jmendoza-10/connectivity-module-public/firmware/config/README.md

Pin/clock configuration will be generated with NXP S32 Config Tools from the rev 0.4 schematic pin budget
(docs/design/power-mcu.md sec. 4) into `config/generated/`. Empty until rev 0.4 exists.
