jmendoza-10/connectivity-module-public/docs/hw-sw-interface.md

<!-- GENERATED by tools/gen_interface.py from hardware/kicad/wwan-carrier.net - DO NOT EDIT BY HAND. -->
# Hardware / software interface - WWAN carrier rev 0.2

Generated from the KiCad netlist plus the semantic table in `tools/gen_interface.py`. Rerun `python3 tools/gen_interface.py` (or `tools/regen_hardware.sh`) after any schematic change; CI runs `--check`.

Legend: **VERIFY** = not yet confirmed on hardware or against a primary source. Nothing in this document has been bench-tested (no boards exist yet).

## 1. I2C devices

One host I2C bus enters on the host header J801 (3.3 V). The PCIe switch sits behind a PCA9306 level translator (1.8 V side).

| Ref | Device | 7-bit address | Bus | Source / note | Status |
|---|---|---|---|---|---|
| U301 | PI7C9X3G606GP | 0x6F | host I2C via U304 PCA9306 (1.8 V side) | Diodes DS43484 Rev 5-2 sec. I2C: default 1101111b (0x6F), programmable at cfg offset 318h. The same section's example tables show 68h - confirm with i2cdetect | **VERIFY** |
| U705 | USB5744 | 0x2D | host I2C (3.3 V) | Linux DT binding microchip,usb5744.yaml example (usb-hub@2d); not stated in DS00001855J text | **VERIFY** |
| U801 | TCA6416A | 0x20 | host I2C (3.3 V) | ADDR pin on GND - TI SCPS194F Table 8-3: ADDR=L -> 0x20, ADDR=H -> 0x21 (derived from the ADDR pin net) | from netlist + datasheet |
| U802 | TCA6416A | 0x21 | host I2C (3.3 V) | ADDR pin on +3V3 - TI SCPS194F Table 8-3: ADDR=L -> 0x20, ADDR=H -> 0x21 (derived from the ADDR pin net) | from netlist + datasheet |
| U704 | HD3SS3220 | - | - | ADDR pin unconnected -> GPIO mode, I2C not used (TI SLLSEN5) | from netlist + datasheet |

Bus pull-ups found in the netlist: R709 10k to +3V3; R802 4.7k to +3V3 (DNP); R710 10k to +3V3; R803 4.7k to +3V3 (DNP).

Notes:
- USB5744 is strapped for **SMBus slave mode** (10 k pull-ups on SMCLK/SMDAT). In that mode the hub waits **indefinitely** in its SOC_CFG stage until the host finishes configuration (DS00001855J sec. 5.1.5). Linux `onboard_usb_dev` (`CONFIG_USB_ONBOARD_DEV_USB5744`) sends the attach command (SMBus write-word, command 0xAA, data 0x0056); `carrierctl.py hub-attach` does the same from userspace. Until this happens **no slot enumerates over USB**. **VERIFY** on hardware.
- PI7C9X3G606GP I2C is for configuration/debug only; normal operation needs no I2C traffic (transparent switch).

## 2. TCA6416A GPIO expanders

### U801 - address 0x20 (ADDR -> GND)

INT# -> `EXP_INT_N`, RESET# -> `EXP_RESET_N`. Register init (write output regs 0x02/0x03 **first**, then config 0x06/0x07): output = `0x00 0x80`, config = `0x00 0x00` (1 = input).

| Port.bit | Pin | Net | Dir | Active | Board default (expander pins are inputs after POR) | Init value | Meaning | Connects to | gpio-line-name |
|---|---|---|---|---|---|---|---|---|---|
| P0.0 | 4 | `SLOT1_PWR_EN` | out | high | 0 (pull-down R201 100k to GND) | 0 | Enable for slot 1 3.7 V buck (LM61460 EN). 1 = slot rail on. | R201.1 (100k), U201.EN/SYNC (LM61460AASQRJRRQ1) | `slot1-pwr-en` |
| P0.1 | 5 | `SLOT1_FCPO_N` | out | low | 0 (pull-down R401 47k to GND) | 0 | M.2 FULL_CARD_POWER_OFF# (module pin 6), driven directly. 0 = module held off, 1 = module allowed to run. Drive 0 before removing +3V7 (avoid back-powering the module from the expander). | J401.FULL_CARD_POWER_OFF# (M.2 Key-B WWAN), R401.1 (47k) | `slot1-fcpo-n` |
| P0.2 | 6 | `SLOT1_RESET` | out | high | 0 (pull-down R402 100k to GND) | 0 | Gate of 2N7002 that pulls module RESET# (pin 67) low (open drain only - EM92 RESET_N / FN990 SYS_RESIN_N forbid pull-ups). 1 = module held in reset. Pulse >= 1 s (FN990 needs > 1 s, EM92 >= 450 ms); emergency use only. | Q401.G (2N7002), R402.1 (100k) | `slot1-reset` |
| P0.3 | 7 | `SLOT1_WDIS` | out | high | 0 (pull-down R403 100k to GND) | 0 | Gate of 2N7002 that pulls W_DISABLE1# (pin 8) low. 1 = radio disabled (RF off). | Q402.G (2N7002), R403.1 (100k) | `slot1-wdis` |
| P0.4 | 8 | `SLOT1_PCIE_EN` | out | high | 0 (pull-down R407 10k to GND) | 0 | Gates host PERST# into slot 1 (SN74LVC1G08 AND). 0 = slot PERST# held asserted (default during power-up; release >= 150 ms after the slot rail is valid, EM92 T_pvpgl). Does NOT select the host interface - see SLOT1_PCIE_SEL. Jumper JUMPER (fitted) forces 0 regardless of the expander. | R406.1 (1k), R407.1 (10k) | `slot1-pcie-en` |
| P0.5 | 9 | `SLOT2_PWR_EN` | out | high | 0 (pull-down R207 100k to GND) | 0 | Enable for slot 2 3.7 V buck (LM61460 EN). 1 = slot rail on. | R207.1 (100k), U202.EN/SYNC (LM61460AASQRJRRQ1) | `slot2-pwr-en` |
| P0.6 | 10 | `SLOT2_FCPO_N` | out | low | 0 (pull-down R501 47k to GND) | 0 | M.2 FULL_CARD_POWER_OFF# (module pin 6), driven directly. 0 = module held off, 1 = module allowed to run. Drive 0 before removing +3V7 (avoid back-powering the module from the expander). | J501.FULL_CARD_POWER_OFF# (M.2 Key-B WWAN), R501.1 (47k) | `slot2-fcpo-n` |
| P0.7 | 11 | `SLOT2_RESET` | out | high | 0 (pull-down R502 100k to GND) | 0 | Gate of 2N7002 that pulls module RESET# (pin 67) low (open drain only - EM92 RESET_N / FN990 SYS_RESIN_N forbid pull-ups). 1 = module held in reset. Pulse >= 1 s (FN990 needs > 1 s, EM92 >= 450 ms); emergency use only. | Q501.G (2N7002), R502.1 (100k) | `slot2-reset` |
| P1.0 | 13 | `SLOT2_WDIS` | out | high | 0 (pull-down R503 100k to GND) | 0 | Gate of 2N7002 that pulls W_DISABLE1# (pin 8) low. 1 = radio disabled (RF off). | Q502.G (2N7002), R503.1 (100k) | `slot2-wdis` |
| P1.1 | 14 | `SLOT2_PCIE_EN` | out | high | 0 (pull-down R507 10k to GND) | 0 | Gates host PERST# into slot 2 (SN74LVC1G08 AND). 0 = slot PERST# held asserted (default during power-up; release >= 150 ms after the slot rail is valid, EM92 T_pvpgl). Does NOT select the host interface - see SLOT2_PCIE_SEL. Jumper JUMPER (fitted) forces 0 regardless of the expander. | R506.1 (1k), R507.1 (10k) | `slot2-pcie-en` |
| P1.2 | 15 | `SLOT3_PWR_EN` | out | high | 0 (pull-down R213 100k to GND) | 0 | Enable for slot 3 3.7 V buck (LM61460 EN). 1 = slot rail on. | R213.1 (100k), U203.EN/SYNC (LM61460AASQRJRRQ1) | `slot3-pwr-en` |
| P1.3 | 16 | `SLOT3_FCPO_N` | out | low | 0 (pull-down R601 47k to GND) | 0 | M.2 FULL_CARD_POWER_OFF# (module pin 6), driven directly. 0 = module held off, 1 = module allowed to run. Drive 0 before removing +3V7 (avoid back-powering the module from the expander). | J601.FULL_CARD_POWER_OFF# (M.2 Key-B WWAN), R601.1 (47k) | `slot3-fcpo-n` |
| P1.4 | 17 | `SLOT3_RESET` | out | high | 0 (pull-down R602 100k to GND) | 0 | Gate of 2N7002 that pulls module RESET# (pin 67) low (open drain only - EM92 RESET_N / FN990 SYS_RESIN_N forbid pull-ups). 1 = module held in reset. Pulse >= 1 s (FN990 needs > 1 s, EM92 >= 450 ms); emergency use only. | Q601.G (2N7002), R602.1 (100k) | `slot3-reset` |
| P1.5 | 18 | `SLOT3_WDIS` | out | high | 0 (pull-down R603 100k to GND) | 0 | Gate of 2N7002 that pulls W_DISABLE1# (pin 8) low. 1 = radio disabled (RF off). | Q602.G (2N7002), R603.1 (100k) | `slot3-wdis` |
| P1.6 | 19 | `SLOT3_PCIE_EN` | out | high | 0 (pull-down R607 10k to GND) | 0 | Gates host PERST# into slot 3 (SN74LVC1G08 AND). 0 = slot PERST# held asserted (default during power-up; release >= 150 ms after the slot rail is valid, EM92 T_pvpgl). Does NOT select the host interface - see SLOT3_PCIE_SEL. Jumper JUMPER (fitted) forces 0 regardless of the expander. | R606.1 (1k), R607.1 (10k) | `slot3-pcie-en` |
| P1.7 | 20 | `HUB_RESET_N` | out | low | 1 (pull-up R706 10k to +3V3) | 1 | USB5744 RESET_N. 0 = hub held in reset (standby). Hub straps re-latch on the rising edge. | C716.1 (100nF), R706.2 (10k), TP702.1 (HUB_RESET_N), U705.RESET_N (USB5744/2G9 (verify ordering suffix)) | `hub-reset-n` |

### U802 - address 0x21 (ADDR -> +3V3)

INT# -> `EXP_INT_N`, RESET# -> `EXP_RESET_N`. Register init (write output regs 0x02/0x03 **first**, then config 0x06/0x07): output = `0xFF 0xF3`, config = `0xFF 0x83` (1 = input).

| Port.bit | Pin | Net | Dir | Active | Board default (expander pins are inputs after POR) | Init value | Meaning | Connects to | gpio-line-name |
|---|---|---|---|---|---|---|---|---|---|
| P0.0 | 4 | `SLOT1_PG` | in | high | 1 (pull-up R206 100k to +3V3) | - | Slot 1 3.7 V buck PGOOD (open drain). 1 = rail in regulation. | Q805.G (2N7002), R206.2 (100k), U201.PGOOD (LM61460AASQRJRRQ1) | `slot1-pg` |
| P0.1 | 5 | `SLOT2_PG` | in | high | 1 (pull-up R212 100k to +3V3) | - | Slot 2 3.7 V buck PGOOD (open drain). 1 = rail in regulation. | Q806.G (2N7002), R212.2 (100k), U202.PGOOD (LM61460AASQRJRRQ1) | `slot2-pg` |
| P0.2 | 6 | `SLOT3_PG` | in | high | 1 (pull-up R218 100k to +3V3) | - | Slot 3 3.7 V buck PGOOD (open drain). 1 = rail in regulation. | Q807.G (2N7002), R218.2 (100k), U203.PGOOD (LM61460AASQRJRRQ1) | `slot3-pg` |
| P0.3 | 7 | `SLOT1_WAKE_N` | in | low | 1 (pull-up R405 10k to +3V3) | - | M.2 PEWAKE# (module pin 54). 0 = module requests wake. Not routed to the PCIe switch. | J401.PEWAKE# (M.2 Key-B WWAN), R405.2 (10k) | `slot1-wake-n` |
| P0.4 | 8 | `SLOT2_WAKE_N` | in | low | 1 (pull-up R505 10k to +3V3) | - | M.2 PEWAKE# (module pin 54). 0 = module requests wake. Not routed to the PCIe switch. | J501.PEWAKE# (M.2 Key-B WWAN), R505.2 (10k) | `slot2-wake-n` |
| P0.5 | 9 | `SLOT3_WAKE_N` | in | low | 1 (pull-up R605 10k to +3V3) | - | M.2 PEWAKE# (module pin 54). 0 = module requests wake. Not routed to the PCIe switch. | J601.PEWAKE# (M.2 Key-B WWAN), R605.2 (10k) | `slot3-wake-n` |
| P0.6 | 10 | `PG_3V3` | in | high | 1 (pull-up R112 10k to +3V3) | - | +3V3 system buck PGOOD. Also enables the +0V95/+1V8/+1V2 regulators (hardware sequencing). | Q801.G (2N7002), R112.2 (10k), TP106.1 (PG_3V3), U102.PGOOD (LM61460AASQRJRRQ1), U103.EN (TPS568230RJER), U104.EN (TPS62130RGTR), U105.EN (TPS62130RGTR) | `pg-3v3` |
| P0.7 | 11 | `PG_0V95` | in | high | 1 (pull-up R117 100k to +3V3) | - | +0V95 (PCIe switch core) PGOOD. | Q802.G (2N7002), R117.2 (100k), U103.PGOOD (TPS568230RJER) | `pg-0v95` |
| P1.0 | 13 | `PG_1V8` | in | high | 1 (pull-up R120 100k to +3V3) | - | +1V8 (PCIe switch I/O, EEPROM) PGOOD. | Q803.G (2N7002), R120.2 (100k), U104.PG (TPS62130RGTR) | `pg-1v8` |
| P1.1 | 14 | `PG_1V2` | in | high | 1 (pull-up R123 100k to +3V3) | - | +1V2 (USB5744 core) PGOOD. | Q804.G (2N7002), R123.2 (100k), U105.PG (TPS62130RGTR) | `pg-1v2` |
| P1.2 | 15 | `USER_LED1` | out | high | ? (no pull (floating while expander pin is an input)) | 0 | User LED 1 (yellow, 1 k to LED to GND). 1 = on. | R813.1 (1k) | `user-led1` |
| P1.3 | 16 | `USER_LED2` | out | high | ? (no pull (floating while expander pin is an input)) | 0 | User LED 2 (yellow, 1 k to LED to GND). 1 = on. | R814.1 (1k) | `user-led2` |
| P1.4 | 17 | `SLOT1_PCIE_SEL` | out | high | 1 (pull-up R410 10k to +3V3) | 1 | Gate of 2N7002 on M.2 pin 20 (rev 0.3). 1 = pin 20 LOW = PCIe host interface (Telit FN990 USB_PCIE_SWITCH low; Sierra EM92 PCIE_DIS low). 0 = pin 20 released: FN990 boots USB-only (internal 10k PU); EM92 boots USB only if the DNP 10k pin-20 pull-up to +1V8 is fitted. Sampled at module boot: set before FCPO# goes high. 10k PU = PCIe by default. | Q403.G (2N7002), R410.2 (10k) | `slot1-pcie-sel` |
| P1.5 | 18 | `SLOT2_PCIE_SEL` | out | high | 1 (pull-up R510 10k to +3V3) | 1 | Gate of 2N7002 on M.2 pin 20 (rev 0.3). 1 = pin 20 LOW = PCIe host interface (Telit FN990 USB_PCIE_SWITCH low; Sierra EM92 PCIE_DIS low). 0 = pin 20 released: FN990 boots USB-only (internal 10k PU); EM92 boots USB only if the DNP 10k pin-20 pull-up to +1V8 is fitted. Sampled at module boot: set before FCPO# goes high. 10k PU = PCIe by default. | Q503.G (2N7002), R510.2 (10k) | `slot2-pcie-sel` |
| P1.6 | 19 | `SLOT3_PCIE_SEL` | out | high | 1 (pull-up R610 10k to +3V3) | 1 | Gate of 2N7002 on M.2 pin 20 (rev 0.3). 1 = pin 20 LOW = PCIe host interface (Telit FN990 USB_PCIE_SWITCH low; Sierra EM92 PCIE_DIS low). 0 = pin 20 released: FN990 boots USB-only (internal 10k PU); EM92 boots USB only if the DNP 10k pin-20 pull-up to +1V8 is fitted. Sampled at module boot: set before FCPO# goes high. 10k PU = PCIe by default. | Q603.G (2N7002), R610.2 (10k) | `slot3-pcie-sel` |
| P1.7 | 20 | `EXP_SPARE7` | spare | - | ? (no pull (floating while expander pin is an input)) | - | Spare expander pin, brought to a test point only. | TP804.1 (EXP_SPARE7) | `spare7` |

TCA6416A facts used above (TI SCPS194F): after power-on reset or RESET# all pins are inputs (config regs 0x06/0x07 = 0xFF) and the output registers 0x02/0x03 default to 0xFF (sec. 8.6.3). If firmware writes the config register first, every output would immediately drive **1** (slots powered, FCPO# released, modules in reset, RF disabled). Always write the output registers first. The expander has no internal pull resistors, so the "board default" column is set by the carrier resistors only.

## 3. PCIe topology

Host: FRDM-IMX95 M.2 Key-M (PCIe Gen3 x1) -> ADT-Link M41 riser cable -> carrier x1 edge fingers -> PI7C9X3G606GP upstream port 0. Switch strapped PORTCFG[2:0]=101 (6-port/6-lane), CKMODE=0 (host REFCLK), hot-plug disabled (HOT_PLUG_EN_L=1).

| Slot | Connector | Switch lane | Switch port | REFCLK out | CLKREQ# net | PERST# source |
|---|---|---|---|---|---|---|
| 1 | J401 | 1 | P1 | REFCLKO1 | `SLOT1_CLKREQ_N` | `SLOT1_PERST_N` = host PERST# AND SLOT1_PCIE_EN (TP403.1 (SLOT1_PERST_N), U401.4 (SN74LVC1G08DCKR)) |
| 2 | J501 | 2 | P4 | REFCLKO4 | `SLOT2_CLKREQ_N` | `SLOT2_PERST_N` = host PERST# AND SLOT2_PCIE_EN (TP503.1 (SLOT2_PERST_N), U501.4 (SN74LVC1G08DCKR)) |
| 3 | J601 | 3 | P5 | REFCLKO5 | `SLOT3_CLKREQ_N` | `SLOT3_PERST_N` = host PERST# AND SLOT3_PCIE_EN (TP603.1 (SLOT3_PERST_N), U601.4 (SN74LVC1G08DCKR)) |

Ports P6/P7 are unused (lanes 4/5 NC).

Expected `lspci -tvnn` (bus numbers illustrative; **VERIFY** downstream device numbers and whether unused ports P6/P7 still appear as bridges):

```
-[0000:00]---00.0-[01-ff]--  i.MX 95 root port
    \-[01]---00.0  Pericom/Diodes PI7C9X3G606GP upstream port   [12d8:c008]
        +-[02] DSP P1 --- 00.0  Qualcomm SDX65 MHI (Telit FN990A28)  [17cb:0308 sub 1c5d:2010]  driver mhi-pci-generic
        +-[03] DSP P4 --- 00.0  Qualcomm SDX65 MHI (Sierra EM9291)   [17cb:0308 sub 18d7:0301]  driver mhi-pci-generic
        +-[04] DSP P5 --- 00.0  (any of the above / future NTN M.2 card)
        +-[05] DSP P6 (no link)
        \-[06] DSP P7 (no link)
```

IDs: switch 12d8:c008 from DS43484 sec. 9.3.1/9.3.2 (vendor 12D8h, device C008h). Module IDs from mainline `drivers/bus/mhi/host/pci_generic.c` (entries "Telit FN990" 1c5d:2010 and "EM929x (sdx65)" 18d7:0301); the slot assignment above is only an example. **VERIFY** on hardware that FN990A28 reports subsystem 1c5d:2010 (an unknown subsystem still binds via the generic 17cb:0308 entry).

## 4. USB topology

Host USB3 Type-C (FRDM) -> carrier USB-C J701 (UFP) -> HD3SS3220 (orientation mux, GPIO mode) -> USB5744 upstream. USB5744 port 4 disabled by strap; ports 1-3 non-removable.

| Slot | Connector | USB5744 port | USB2 D+ | Module USB3 TX -> hub | Hub USB3 TX -> module RX |
|---|---|---|---|---|---|
| 1 | J401 | 1 | USB2DN_DP1/PRT_DIS_P1 | USB3DN_RXDP1 | USB3DN_TXDP1 (via C708 100nF) |
| 2 | J501 | 2 | USB2DN_DP2/PRT_DIS_P2 | USB3DN_RXDP2 | USB3DN_TXDP2 (via C710 100nF) |
| 3 | J601 | 3 | USB2DN_DP3/PRT_DIS_P3 | USB3DN_RXDP3 | USB3DN_TXDP3 (via C712 100nF) |

USB is always wired. Telit FN990: with pin 20 LOW (PCIe mode) USB is debug-only; with `SLOTn_PCIE_SEL`=0 at boot the card boots USB-only (USB 3.1 Gen2 / USB 2.0, HDG Table 29). Sierra EM92xx: interfaces are mutually exclusive; USB needs PCIE_DIS driven to 1.8 V (fit the DNP 10k pin-20 pull-up to +1V8) and normally VBUS_SENSE high on pin 22 (fit the DNP 10k to the slot rail - Sierra only).

## 5. LEDs

| Ref | Colour | Anode supply | Cathode net | Lit when | Sheet |
|---|---|---|---|---|---|
| D102 | green | `+12V via R105 4.7k` | `GND` | on whenever `+12V` is present | power_input.kicad_sch |
| D301 | red | `+3V3 via R345 680` | `Net-(D301-K)` | switch PORTGOOD_L0 (port P0): off = no link, 1 Hz blink = 2.5 GT/s, 2 Hz blink = 5 GT/s, steady on = 8 GT/s (DS43484 pin table) | pcie_switch.kicad_sch |
| D302 | red | `+3V3 via R346 680` | `Net-(D302-K)` | switch PORTGOOD_L1 (port P1): off = no link, 1 Hz blink = 2.5 GT/s, 2 Hz blink = 5 GT/s, steady on = 8 GT/s (DS43484 pin table) | pcie_switch.kicad_sch |
| D303 | red | `+3V3 via R347 680` | `Net-(D303-K)` | switch PORTGOOD_L4 (port P4): off = no link, 1 Hz blink = 2.5 GT/s, 2 Hz blink = 5 GT/s, steady on = 8 GT/s (DS43484 pin table) | pcie_switch.kicad_sch |
| D304 | red | `+3V3 via R348 680` | `Net-(D304-K)` | switch PORTGOOD_L5 (port P5): off = no link, 1 Hz blink = 2.5 GT/s, 2 Hz blink = 5 GT/s, steady on = 8 GT/s (DS43484 pin table) | pcie_switch.kicad_sch |
| D401 | green | `+3V3 via R404 1k` | `Net-(D401-K)` | module LED1# (J401 pin 10, open drain): status pattern set by module firmware | slot1.kicad_sch |
| D501 | green | `+3V3 via R504 1k` | `Net-(D501-K)` | module LED1# (J501 pin 10, open drain): status pattern set by module firmware | slot2.kicad_sch |
| D601 | green | `+3V3 via R604 1k` | `Net-(D601-K)` | module LED1# (J601 pin 10, open drain): status pattern set by module firmware | slot3.kicad_sch |
| D801 | green | `+3V3 via R806 1k` | `Net-(D801-K)` | on when `PG_3V3` = 1 (Q801 2N7002 low-side switch) | control.kicad_sch |
| D802 | green | `+3V3 via R807 1k` | `Net-(D802-K)` | on when `PG_0V95` = 1 (Q802 2N7002 low-side switch) | control.kicad_sch |
| D803 | green | `+3V3 via R808 1k` | `Net-(D803-K)` | on when `PG_1V8` = 1 (Q803 2N7002 low-side switch) | control.kicad_sch |
| D804 | green | `+3V3 via R809 1k` | `Net-(D804-K)` | on when `PG_1V2` = 1 (Q804 2N7002 low-side switch) | control.kicad_sch |
| D805 | green | `+3V3 via R810 1k` | `Net-(D805-K)` | on when `SLOT1_PG` = 1 (Q805 2N7002 low-side switch) | control.kicad_sch |
| D806 | green | `+3V3 via R811 1k` | `Net-(D806-K)` | on when `SLOT2_PG` = 1 (Q806 2N7002 low-side switch) | control.kicad_sch |
| D807 | green | `+3V3 via R812 1k` | `Net-(D807-K)` | on when `SLOT3_PG` = 1 (Q807 2N7002 low-side switch) | control.kicad_sch |
| D808 | yellow | `USER_LED1 via R813 1k` | `GND` | on when `USER_LED1` = 1 (U802 P12 via R813 1k) | control.kicad_sch |
| D809 | yellow | `USER_LED2 via R814 1k` | `GND` | on when `USER_LED2` = 1 (U802 P13 via R814 1k) | control.kicad_sch |

## 6. Test points

| Ref | Label (silkscreen intent) | Netlist net | Sheet |
|---|---|---|---|
| TP101 | +12V | `+12V` | power_input.kicad_sch |
| TP102 | +12V_RAW | `Net-(J101-Pin_1)` | power_input.kicad_sch |
| TP103 | GND | `GND` | power_input.kicad_sch |
| TP104 | GND | `GND` | power_input.kicad_sch |
| TP105 | +3V3 | `+3V3` | power_input.kicad_sch |
| TP106 | PG_3V3 | `PG_3V3` | power_input.kicad_sch |
| TP107 | +0V95 | `+0V95` | power_input.kicad_sch |
| TP108 | +1V8 | `+1V8` | power_input.kicad_sch |
| TP109 | +1V2 | `+1V2` | power_input.kicad_sch |
| TP201 | +3V7_S1 | `+3V7_S1` | wwan_power.kicad_sch |
| TP202 | +3V7_S2 | `+3V7_S2` | wwan_power.kicad_sch |
| TP203 | +3V7_S3 | `+3V7_S3` | wwan_power.kicad_sch |
| TP301 | PCIE_PERST_N | `PCIE_PERST_N` | pcie_switch.kicad_sch |
| TP302 | SW_FATAL_N | `Net-(U301B-FATAL_ERR_L{slash}HOT_PLUG_EN_L)` | pcie_switch.kicad_sch |
| TP303 | SW_INTA_N | `Net-(U301B-INTA_L{slash}PM_L11_EN_L)` | pcie_switch.kicad_sch |
| TP304 | UP_CLKREQ_N | `Net-(U301B-GPIO8{slash}CLKREQ_L0)` | pcie_switch.kicad_sch |
| TP401 | S1_M2_GPIO6 | `Net-(J401-GPIO6[VBUS_SNS])` | slot1.kicad_sch |
| TP402 | S1_M2_GPIO8 | `Net-(J401-GPIO8[PLA_S2#])` | slot1.kicad_sch |
| TP403 | SLOT1_PERST_N | `Net-(J401-PERST#)` | slot1.kicad_sch |
| TP404 | +3V7_S1 | `+3V7_S1` | slot1.kicad_sch |
| TP501 | S2_M2_GPIO6 | `Net-(J501-GPIO6[VBUS_SNS])` | slot2.kicad_sch |
| TP502 | S2_M2_GPIO8 | `Net-(J501-GPIO8[PLA_S2#])` | slot2.kicad_sch |
| TP503 | SLOT2_PERST_N | `Net-(J501-PERST#)` | slot2.kicad_sch |
| TP504 | +3V7_S2 | `+3V7_S2` | slot2.kicad_sch |
| TP601 | S3_M2_GPIO6 | `Net-(J601-GPIO6[VBUS_SNS])` | slot3.kicad_sch |
| TP602 | S3_M2_GPIO8 | `Net-(J601-GPIO8[PLA_S2#])` | slot3.kicad_sch |
| TP603 | SLOT3_PERST_N | `Net-(J601-PERST#)` | slot3.kicad_sch |
| TP604 | +3V7_S3 | `+3V7_S3` | slot3.kicad_sch |
| TP701 | HD_DIR | `Net-(U704-DIR)` | usb_hub.kicad_sch |
| TP702 | HUB_RESET_N | `HUB_RESET_N` | usb_hub.kicad_sch |
| TP801 | I2C_SCL | `I2C_SCL` | control.kicad_sch |
| TP802 | I2C_SDA | `I2C_SDA` | control.kicad_sch |
| TP803 | EXP_INT_N | `Net-(J801-Pin_5)` | control.kicad_sch |
| TP804 | EXP_SPARE7 | `Net-(U802-P17)` | control.kicad_sch |

## 7. Host header J801 (2x5, 2.54 mm)

| Pin | Net | Notes |
|---|---|---|
| 1 | `GND` |  |
| 2 | `GND` |  |
| 3 | `I2C_SCL` | host I2C, 3.3 V. Bus pull-ups 10 k on the hub sheet (SMBus strap), 4.7 k DNP here |
| 4 | `I2C_SDA` | host I2C, 3.3 V. Bus pull-ups 10 k on the hub sheet (SMBus strap), 4.7 k DNP here |
| 5 | `EXP_INT_N` | open-drain wired-OR INT# of both TCA6416A, 10 k pull-up; connect to a host GPIO with IRQ |
| 6 | `EXP_RESET_N` | RESET# of both TCA6416A, 10 k pull-up; host GPIO, active low |
| 7 | `NC` |  |
| 8 | `CARRIER_3V3_SENSE` | 1 k from +3V3: reads high when the carrier +3V3 rail is up |
| 9 | `GND` |  |
| 10 | `GND` |  |

Mapping to FRDM-IMX95 header pins (which LPI2C instance, which GPIO for INT#/RESET#) is **not decided**; see docs/open-issues.md. Host I/O must be 3.3 V (**VERIFY** the FRDM header voltage).

## 8. Parts flagged VERIFY in the schematic

| Ref | Value | Field | Text |
|---|---|---|---|
| C106 | 100uF/35V | MPN | Panasonic EEE-FK1V101P (AEC-Q200) VERIFY |
| C401, C402, C501, C502, C601, C602 | 220uF/6.3V | MPN | KEMET T520D227M006ATE015 (low ESR polymer) VERIFY |
| D301, D302, D303, D304 | red | MPN | Kingbright APHHS1005SURCK (low Vf red) VERIFY |
| F101 | 7A | MPN | Littelfuse 0466007.NR (VERIFY I2t vs inrush) |
| FB301, FB302, FB303, FB701 | BLM18PG221SN1D | Notes | VERIFY bead choice/DCR |
| H401, H501, H601 | 3052 standoff | MPN | Wurth WA-SMSI M2 SMT spacer (height per connector) VERIFY P/N |
| H402, H502, H602 | 3042 standoff | MPN | Wurth WA-SMSI M2 SMT spacer VERIFY P/N (fit only for 3042 cards) |
| J401, J501, J601 | M.2 Key-B WWAN | MPN | LOTES APCI0026-P001A (TW) VERIFY stack height; alt TE/Amphenol M.2 Key-B 0.5mm VERIFY |
| J801 | HOST I2C/CTRL | MPN | Samtec TSW-105-07-G-D (or Wurth 61301021121) VERIFY |
| JP401, JP501, JP601 | PERST# hold | MPN | Samtec TSW-102-07-G-S + SNT-100-BK-G shunt VERIFY |
| Q101, Q102 | NVMFS5C646NL | Notes | VERIFY SOA/inrush with LM74800 HGATE soft-start |
| Q401, Q402, Q403, Q501, Q502, Q503, Q601, Q602, Q603, Q801, Q802, Q803, Q804, Q805, Q806, Q807 | 2N7002 | MPN | Diodes Inc. 2N7002-7-F (AEC-Q101: onsemi 2N7002ET1G / Diodes 2N7002Q-7-F VERIFY) |
| R342, R343, R344 | 0 | Notes | present-detect option - VERIFY |
| U303 | 25AA640A | MPN | 25AA640A-I/SN (1.8V, 2-byte addr) VERIFY vs switch EEPROM format |
| U705 | USB5744/2G9 (verify ordering suffix) | MPN | USB5744-I/2G (industrial) VERIFY suffix |
| U801, U802 | TCA6416APWR | MPN | TCA6416APWR (TCA6416ATPWRQ1 = AEC option, VERIFY) |
| Y701 | 25MHz | MPN | Abracon ABM8-25.000MHZ-B2-T (VERIFY CL vs load caps) |
