jmendoza-10/connectivity-module-public/hardware/diagrams/block-diagram-v1-bench.png

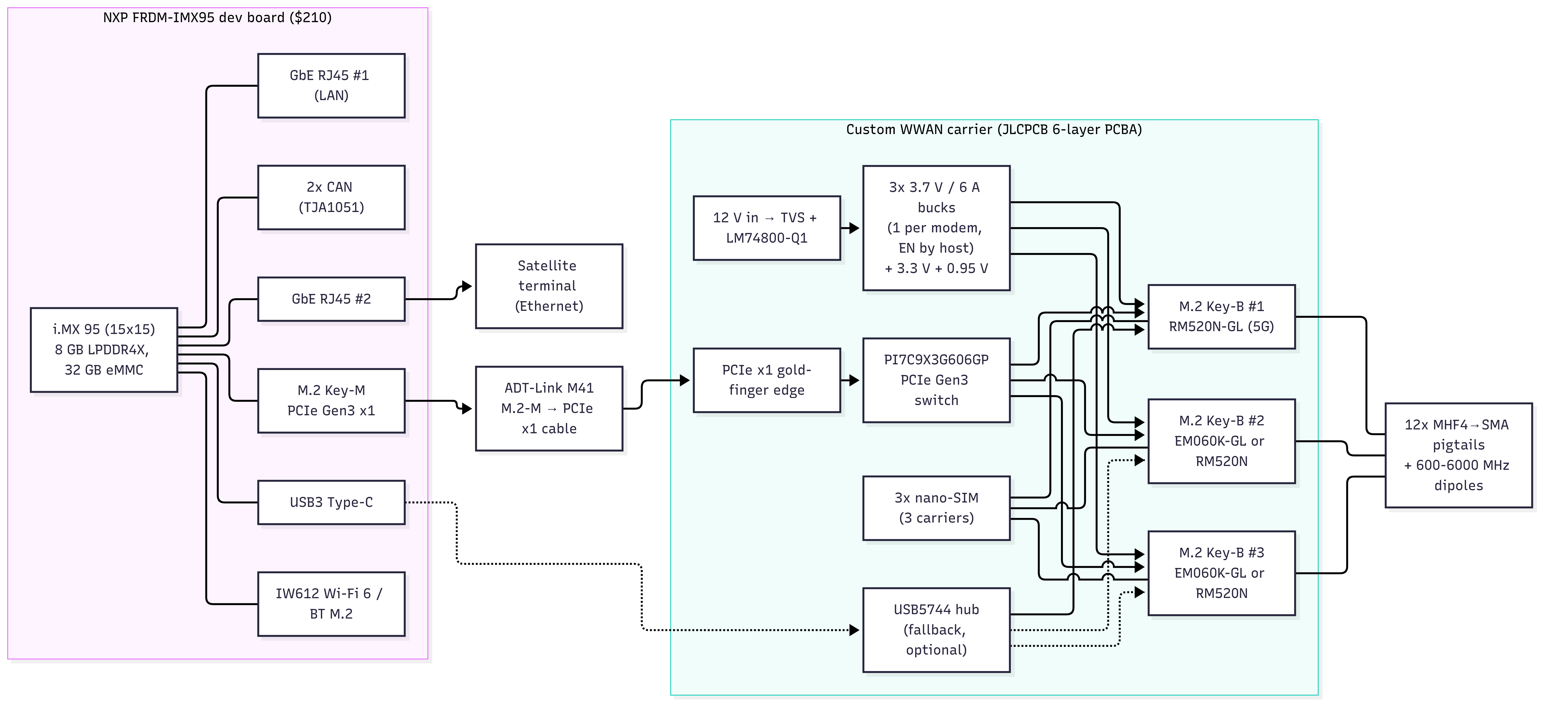
hardware/diagrams/block-diagram-v1-bench.png
