jmendoza-10/connectivity-module-public/hardware/diagrams/block-diagram.png

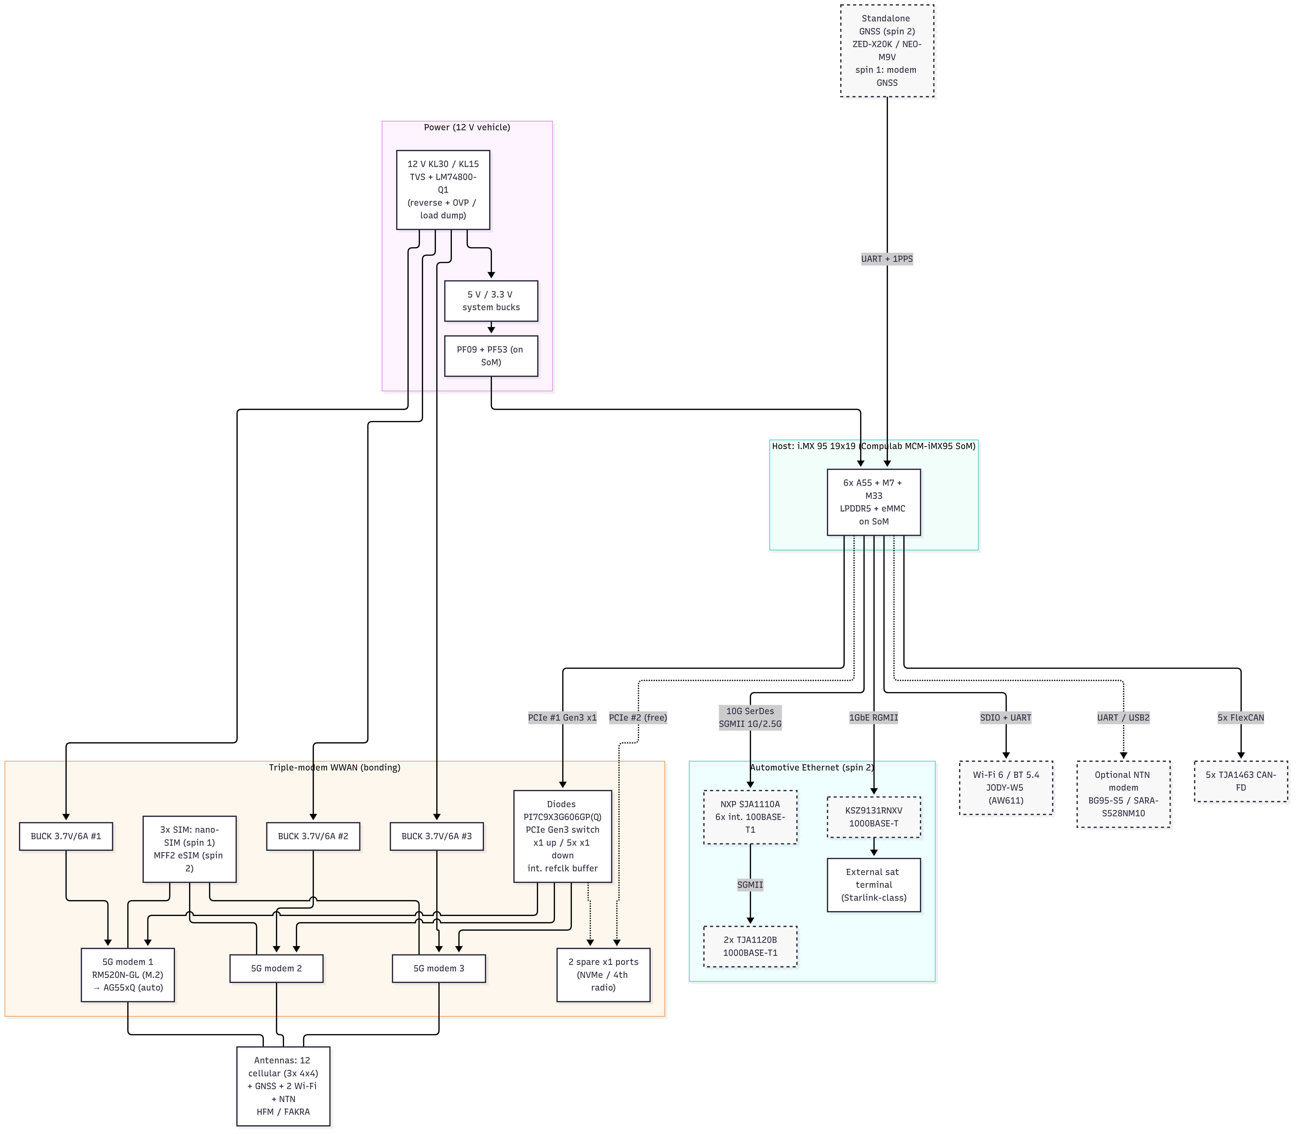
hardware/diagrams/block-diagram.png
