jmendoza-10/connectivity-module-public/hardware/diagrams/preview-control.png

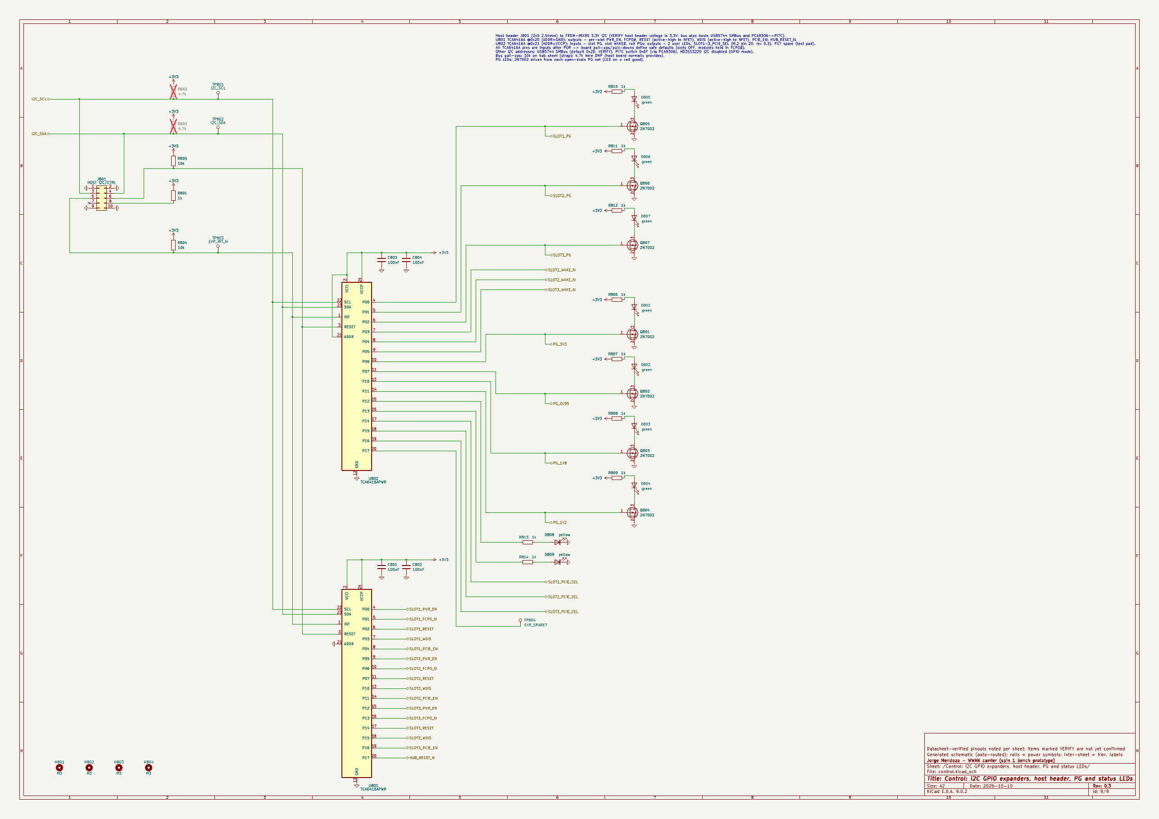
hardware/diagrams/preview-control.png
