jmendoza-10/connectivity-module-public/hardware/diagrams/preview-root.png

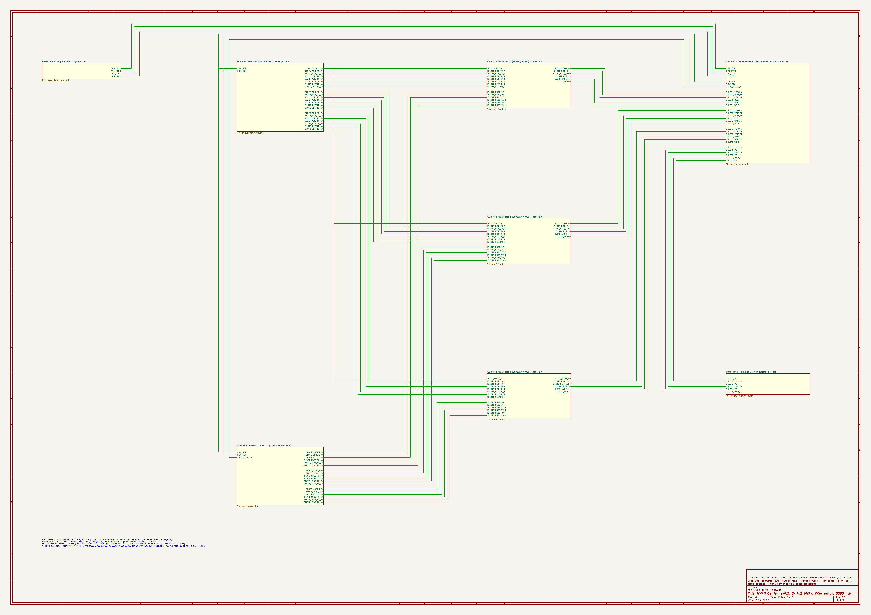
hardware/diagrams/preview-root.png
