jmendoza-10/connectivity-module-public/hardware/wwan-carrier-bom.csv

Refs | Value | Footprint | MPN / maker | Qty | DNP | Notes | Footprint TODO | Footprint VERIFY
C101,C102,C103 | 100nF/50V | Capacitor_SMD:C_0603_1608Metric | Murata GRM/GCM, TDK C/CGA or KEMET (X7R; C0G below 10nF) - no PRC brands | 3
C104,C105,C107,C108,C201,C202,C212,C213,C223,C224 | 10uF/50V | Capacitor_SMD:C_1210_3225Metric | Murata GRM/GCM, TDK C/CGA or KEMET (X7R; C0G below 10nF) - no PRC brands | 10
C106 | 100uF/35V | Capacitor_SMD:CP_Elec_6.3x7.7 | Panasonic EEE-FK1V101P (AEC-Q200) VERIFY | 1
C109,C110,C121,C129,C134,C203,C204,C214,C215,C225,C226 | 100nF/50V | Capacitor_SMD:C_0402_1005Metric | Murata GRM/GCM, TDK C/CGA or KEMET (X7R; C0G below 10nF) - no PRC brands | 11
C111,C122,C205,C216,C227 | 100nF/16V | Capacitor_SMD:C_0402_1005Metric | Murata GRM/GCM, TDK C/CGA or KEMET (X7R; C0G below 10nF) - no PRC brands | 5
C112,C113,C206,C207,C217,C218,C228,C229,C702,C703 | 1uF/16V | Capacitor_SMD:C_0402_1005Metric | Murata GRM/GCM, TDK C/CGA or KEMET (X7R; C0G below 10nF) - no PRC brands | 10
C114 | 22pF | Capacitor_SMD:C_0402_1005Metric | Murata GRM/GCM, TDK C/CGA or KEMET (X7R; C0G below 10nF) - no PRC brands | 1 | DNP | Cff option
C115,C116,C117,C118,C208,C209,C210,C211,C219,C220,C221,C222,C230,C231,C232,C233 | 22uF/10V | Capacitor_SMD:C_1210_3225Metric | Murata GRM/GCM, TDK C/CGA or KEMET (X7R; C0G below 10nF) - no PRC brands | 16
C119,C120 | 10uF/25V | Capacitor_SMD:C_1206_3216Metric | Murata GRM/GCM, TDK C/CGA or KEMET (X7R; C0G below 10nF) - no PRC brands | 2
C123,C403,C503,C603 | 1uF/10V | Capacitor_SMD:C_0402_1005Metric | Murata GRM/GCM, TDK C/CGA or KEMET (X7R; C0G below 10nF) - no PRC brands | 4
C124,C125,C126,C127 | 47uF/6.3V | Capacitor_SMD:C_1206_3216Metric | Murata GRM/GCM, TDK C/CGA or KEMET (X7R; C0G below 10nF) - no PRC brands | 4
C128,C133 | 10uF/25V | Capacitor_SMD:C_0805_2012Metric | Murata GRM/GCM, TDK C/CGA or KEMET (X7R; C0G below 10nF) - no PRC brands | 2
C130,C135 | 3.3nF | Capacitor_SMD:C_0402_1005Metric | Murata GRM/GCM, TDK C/CGA or KEMET (X7R; C0G below 10nF) - no PRC brands | 2
C131,C132,C136,C137,C327 | 22uF/6.3V | Capacitor_SMD:C_0805_2012Metric | Murata GRM/GCM, TDK C/CGA or KEMET (X7R; C0G below 10nF) - no PRC brands | 5
C301,C302,C304,C305,C306,C307,C308,C309 | 220nF | Capacitor_SMD:C_0201_0603Metric | Murata GRM/GCM, TDK C/CGA or KEMET (X7R; C0G below 10nF) - no PRC brands | 8
C303,C310,C311,C328,C330,C331,C333,C335,C336,C404,C409,C411,C504,C509,C511,C604,C609,C611,C704,C705,C716,C717,C718,C719,C720,C722,C723,C724,C725,C726,C727,C728,C729,C801,C802,C803,C804 | 100nF | Capacitor_SMD:C_0402_1005Metric | Murata GRM/GCM, TDK C/CGA or KEMET (X7R; C0G below 10nF) - no PRC brands | 37
C312,C313,C314,C315,C316,C317,C318,C319,C320,C321,C322,C323,C706,C707,C708,C709,C710,C711,C712,C713 | 100nF | Capacitor_SMD:C_0201_0603Metric | Murata GRM/GCM, TDK C/CGA or KEMET (X7R; C0G below 10nF) - no PRC brands | 20
C324,C325,C326 | 10uF/6.3V | Capacitor_SMD:C_0603_1608Metric | Murata GRM/GCM, TDK C/CGA or KEMET (X7R; C0G below 10nF) - no PRC brands | 3
C329,C334,C410,C510,C610 | 1uF | Capacitor_SMD:C_0402_1005Metric | Murata GRM/GCM, TDK C/CGA or KEMET (X7R; C0G below 10nF) - no PRC brands | 5
C332,C337,C721,C730,C731 | 10uF/6.3V | Capacitor_SMD:C_0402_1005Metric | Murata GRM/GCM, TDK C/CGA or KEMET (X7R; C0G below 10nF) - no PRC brands | 5
C401,C402,C501,C502,C601,C602 | 220uF/6.3V | Capacitor_Tantalum_SMD:CP_EIA-7343-31_Kemet-D | KEMET T520D227M006ATE015 (low ESR polymer) VERIFY | 6
C405,C505,C605 | 33pF | Capacitor_SMD:C_0402_1005Metric | Murata GRM/GCM, TDK C/CGA or KEMET (X7R; C0G below 10nF) - no PRC brands | 3
C406,C506,C606,C714,C715 | 18pF | Capacitor_SMD:C_0402_1005Metric | Murata GRM/GCM, TDK C/CGA or KEMET (X7R; C0G below 10nF) - no PRC brands | 5
C407,C507,C607 | 10pF | Capacitor_SMD:C_0402_1005Metric | Murata GRM/GCM, TDK C/CGA or KEMET (X7R; C0G below 10nF) - no PRC brands | 3
C408,C508,C608 | 6.8pF | Capacitor_SMD:C_0402_1005Metric | Murata GRM/GCM, TDK C/CGA or KEMET (X7R; C0G below 10nF) - no PRC brands | 3
C412,C413,C414,C512,C513,C514,C612,C613,C614 | 22pF | Capacitor_SMD:C_0402_1005Metric | Murata GRM/GCM, TDK C/CGA or KEMET (X7R; C0G below 10nF) - no PRC brands | 9
C701 | 4.7nF/100V | Capacitor_SMD:C_0603_1608Metric | Murata GRM/GCM, TDK C/CGA or KEMET (X7R; C0G below 10nF) - no PRC brands | 1
D101 | SMBJ33CA | Diode_SMD:D_SMB | Littelfuse SMBJ33CA (bidirectional, per TI app) | 1
D102,D401,D501,D601,D801,D802,D803,D804,D805,D806,D807 | green | LED_SMD:LED_0603_1608Metric | Lite-On LTST-C191KGKT | 11
D301,D302,D303,D304 | red | LED_SMD:LED_0603_1608Metric | Kingbright APHHS1005SURCK (low Vf red) VERIFY | 4
D701 | SMAJ5.0A | Diode_SMD:D_SMA | Littelfuse SMAJ5.0A (unidirectional, pin1=K to VBUS) | 1
D808,D809 | yellow | LED_SMD:LED_0603_1608Metric | Lite-On LTST-C191KSKT | 2
F101 | 7A | Fuse:Fuse_1206_3216Metric | Littelfuse 0466007.NR (VERIFY I2t vs inrush) | 1
FB301,FB302,FB303,FB701 | BLM18PG221SN1D | Inductor_SMD:L_0603_1608Metric | Murata BLM18PG221SN1D | 4 |  | VERIFY bead choice/DCR
H401,H501,H601 | 3052 standoff | MountingHole:MountingHole_2.2mm_M2_Pad_Via | Wurth WA-SMSI M2 SMT spacer (height per connector) VERIFY P/N | 3 |  | 3052 card screw position (30 x 52 mm) - verify against connector datum
H402,H502,H602 | 3042 standoff | MountingHole:MountingHole_2.2mm_M2_Pad_Via | Wurth WA-SMSI M2 SMT spacer VERIFY P/N (fit only for 3042 cards) | 3 |  | 42 mm option: 3042 card screw position (30 x 42 mm) - verify against connector datum
H801,H802,H803,H804 | M3 | MountingHole:MountingHole_3.2mm_M3 | M3 nylon/steel standoff (Wurth WA-SSTII / Keystone) - mechanical | 4
J101 | 12V IN | Connector_Molex:Molex_Micro-Fit_3.0_43650-0200_1x02_P3.00mm_Horizontal | Molex 43650-0200 | 1
J301 | PCIe x1 edge fingers | Connector_PCBEdge:BUS_PCIexpress_x1 |  | 1 |  | PCB edge fingers (bevel/hard gold); mates ADT-Link M41 x1 slot
J401,J501,J601 | M.2 Key-B WWAN |  | LOTES APCI0026-P001A (TW) VERIFY stack height; alt TE/Amphenol M.2 Key-B 0.5mm VERIFY | 3
J402,J502,J602 | NSIM-2-C | Connector_Card:nanoSIM_Hinged_CUI_NSIM-2-C | CUI Devices NSIM-2-C | 3
J701 | USB-C (USB3.2 Gen1, UFP) | Connector_USB:USB_C_Receptacle_Amphenol_12401610E4-2A | Amphenol 12401610E4#2A | 1
J801 | HOST I2C/CTRL | Connector_PinHeader_2.54mm:PinHeader_2x05_P2.54mm_Vertical | Samtec TSW-105-07-G-D (or Wurth 61301021121) VERIFY | 1
JP401,JP501,JP601 | PERST# hold | Connector_PinHeader_2.54mm:PinHeader_1x02_P2.54mm_Vertical | Samtec TSW-102-07-G-S + SNT-100-BK-G shunt VERIFY | 3
L101,L201,L202,L203 | 3.3uH | Inductor_SMD:L_Coilcraft_XAL7070-XXX | XAL7070-332MEB | 4
L102 | 1.0uH | Inductor_SMD:L_Coilcraft_XAL5030-XXX | XAL5030-102MEB | 1
L103,L104 | 2.2uH | Inductor_SMD:L_Coilcraft_XAL4020-XXX | XAL4020-222MEB | 2
Q101,Q102 | NVMFS5C646NL | Package_SO:ONSemi_SO-8FL_488AA | onsemi NVMFS5C646NLAFT1G (60V, 4.7mOhm@10V, AEC-Q101, SO-8FL 488AA) | 2 |  | VERIFY SOA/inrush with LM74800 HGATE soft-start
Q401,Q402,Q403,Q501,Q502,Q503,Q601,Q602,Q603,Q801,Q802,Q803,Q804,Q805,Q806,Q807 | 2N7002 | Package_TO_SOT_SMD:SOT-23 | Diodes Inc. 2N7002-7-F (AEC-Q101: onsemi 2N7002ET1G / Diodes 2N7002Q-7-F VERIFY) | 16
R101 | 470k | Resistor_SMD:R_0402_1005Metric | Yageo RC0402FR-07470KL (alt Panasonic ERJ / Vishay CRCW, 1%) | 1
R102 | 39k | Resistor_SMD:R_0402_1005Metric | Yageo RC0402FR-0739KL (alt Panasonic ERJ / Vishay CRCW, 1%) | 1
R103 | 220k | Resistor_SMD:R_0402_1005Metric | Yageo RC0402FR-07220KL (alt Panasonic ERJ / Vishay CRCW, 1%) | 1
R104 | 40.2k | Resistor_SMD:R_0402_1005Metric | Yageo RC0402FR-0740K2L (alt Panasonic ERJ / Vishay CRCW, 1%) | 1
R105 | 4.7k | Resistor_SMD:R_0402_1005Metric | Yageo RC0402FR-074K7L (alt Panasonic ERJ / Vishay CRCW, 1%) | 1
R106,R110,R117,R120,R123,R201,R204,R206,R207,R210,R212,R213,R216,R218,R303,R402,R403,R502,R503,R602,R603,R708 | 100k | Resistor_SMD:R_0402_1005Metric | Yageo RC0402FR-07100KL (alt Panasonic ERJ / Vishay CRCW, 1%) | 22 |  | default OFF
R107 | 20k | Resistor_SMD:R_0402_1005Metric | Yageo RC0402FR-0720KL (alt Panasonic ERJ / Vishay CRCW, 1%) | 1
R108,R202,R208,R214 | 33.2k | Resistor_SMD:R_0402_1005Metric | Yageo RC0402FR-0733K2L (alt Panasonic ERJ / Vishay CRCW, 1%) | 4 |  | 400 kHz
R109,R203,R209,R215,R306,R307,R310,R311,R314,R315 | 0 | Resistor_SMD:R_0402_1005Metric | Yageo RC0402JR-070RL (0R jumper) | 10
R111 | 43.2k | Resistor_SMD:R_0402_1005Metric | Yageo RC0402FR-0743K2L (alt Panasonic ERJ / Vishay CRCW, 1%) | 1
R112,R405,R407,R410,R505,R507,R510,R605,R607,R610,R706,R709,R710,R712,R713,R714,R804,R805 | 10k | Resistor_SMD:R_0402_1005Metric | Yageo RC0402FR-0710KL (alt Panasonic ERJ / Vishay CRCW, 1%) | 18 |  | PG_3V3 also drives EN of 3 regulators (internal EN pull-downs),SMBus-mode strap,default PCIe: Q on -> pin 20 low while the expander pin is still an input,ports 1-3 non-removable,rev 0.3: pull-DOWN - PERST# held low by default (no 3.3V into an unpowered card)
R113,R121 | 75k | Resistor_SMD:R_0402_1005Metric | Yageo RC0402FR-0775KL (alt Panasonic ERJ / Vishay CRCW, 1%) | 2 |  | FCCM 800kHz (DS Table 1)
R114 | 51k | Resistor_SMD:R_0402_1005Metric | Yageo RC0402FR-0751KL (alt Panasonic ERJ / Vishay CRCW, 1%) | 1
R115 | 5.62k | Resistor_SMD:R_0402_1005Metric | Yageo RC0402FR-075K62L (alt Panasonic ERJ / Vishay CRCW, 1%) | 1
R116 | 9.53k | Resistor_SMD:R_0402_1005Metric | Yageo RC0402FR-079K53L (alt Panasonic ERJ / Vishay CRCW, 1%) | 1
R118,R122 | 150k | Resistor_SMD:R_0402_1005Metric | Yageo RC0402FR-07150KL (alt Panasonic ERJ / Vishay CRCW, 1%) | 2
R119 | 120k | Resistor_SMD:R_0402_1005Metric | Yageo RC0402FR-07120KL (alt Panasonic ERJ / Vishay CRCW, 1%) | 1
R205,R211,R217 | 36.5k | Resistor_SMD:R_0402_1005Metric | Yageo RC0402FR-0736K5L (alt Panasonic ERJ / Vishay CRCW, 1%) | 3
R301,R302,R308,R309,R312,R313,R316,R317 | 49.9 | Resistor_SMD:R_0402_1005Metric | Yageo RC0402FR-0749R9L (alt Panasonic ERJ / Vishay CRCW, 1%) | 8 | DNP | HCSL term option
R304,R325,R326,R327,R328,R329,R330,R331,R332,R333,R334,R335,R336,R337,R338,R339,R340 | 5.1k | Resistor_SMD:R_0402_1005Metric | Yageo RC0402FR-075K1L (alt Panasonic ERJ / Vishay CRCW, 1%) | 17
R305 | 200R 1% | Resistor_SMD:R_0402_1005Metric | Yageo RC0402FR-07200RL (alt Panasonic ERJ / Vishay CRCW, 1%) | 1 |  | 100ppm/C or better
R318,R319,R320,R321,R322,R323,R324 | 330 | Resistor_SMD:R_0402_1005Metric | Yageo RC0402FR-07330RL (alt Panasonic ERJ / Vishay CRCW, 1%) | 7
R341 | 330 | Resistor_SMD:R_0402_1005Metric | Yageo RC0402FR-07330RL (alt Panasonic ERJ / Vishay CRCW, 1%) | 1 | DNP | fit to enable PM L1.1 (PM_L11_EN_L=0)
R342,R343,R344 | 0 | Resistor_SMD:R_0402_1005Metric | Yageo RC0402JR-070RL (0R jumper) | 3 | DNP | present-detect option - VERIFY
R345,R346,R347,R348 | 680 | Resistor_SMD:R_0402_1005Metric | Yageo RC0402FR-07680RL (alt Panasonic ERJ / Vishay CRCW, 1%) | 4
R349,R703,R711 | 200k | Resistor_SMD:R_0402_1005Metric | Yageo RC0402FR-07200KL (alt Panasonic ERJ / Vishay CRCW, 1%) | 3 |  | no BC
R401,R501,R601 | 47k | Resistor_SMD:R_0402_1005Metric | Yageo RC0402FR-0747KL (alt Panasonic ERJ / Vishay CRCW, 1%) | 3
R404,R406,R504,R506,R604,R606,R801,R806,R807,R808,R809,R810,R811,R812,R813,R814 | 1k | Resistor_SMD:R_0402_1005Metric | Yageo RC0402FR-071KL (alt Panasonic ERJ / Vishay CRCW, 1%) | 16 |  | host can sense carrier powered,limits current if JP fitted while GPIO drives high
R408,R409,R508,R509,R608,R609 | 10k | Resistor_SMD:R_0402_1005Metric | Yageo RC0402FR-0710KL (alt Panasonic ERJ / Vishay CRCW, 1%) | 6 | DNP | FIT ONLY for Sierra EM92xx (pin22 VBUS_SENSE 1.6-5.25V). NEVER fit with Telit FN990 (pin22 = 1.8V TGPIO_06),Sierra-only option: lets PCIE_EN=0/JP select USB (PCIE_DIS high = 1.8V, max 2.1V). Not needed for Telit (internal 10k PU)
R701 | 1M | Resistor_SMD:R_0603_1608Metric | Yageo RC0603FR-071ML (alt Panasonic ERJ / Vishay CRCW, 1%) | 1
R702 | 910k | Resistor_SMD:R_0402_1005Metric | Yageo RC0402FR-07910KL (alt Panasonic ERJ / Vishay CRCW, 1%) | 1 |  | DS: 900k required
R704 | 12k 1% | Resistor_SMD:R_0402_1005Metric | Yageo RC0402FR-0712KL (alt Panasonic ERJ / Vishay CRCW, 1%) | 1
R705 | 1M | Resistor_SMD:R_0402_1005Metric | Yageo RC0402FR-071ML (alt Panasonic ERJ / Vishay CRCW, 1%) | 1 | DNP
R707 | 49.9k | Resistor_SMD:R_0402_1005Metric | Yageo RC0402FR-0749K9L (alt Panasonic ERJ / Vishay CRCW, 1%) | 1
R802,R803 | 4.7k | Resistor_SMD:R_0402_1005Metric | Yageo RC0402FR-074K7L (alt Panasonic ERJ / Vishay CRCW, 1%) | 2 | DNP
U101 | LM74800QDRRRQ1 | Package_SON:WSON-12-1EP_3x3mm_P0.5mm_EP1.5x2.5mm |  | 1
U102,U201,U202,U203 | LM61460AASQRJRRQ1 |  | LM61460AASQRJRRQ1 | 4 |  | Sub for LMQ61460AASQRJRRQ1 (backordered)
U103 | TPS568230RJER | Package_DFN_QFN:Texas_RJE0020A_VQFN-20-1EP_3x3mm_P0.45mm_EP0.675x0.76mm | TPS568230RJER | 1
U104,U105 | TPS62130RGTR | Package_DFN_QFN:VQFN-16-1EP_3x3mm_P0.5mm_EP1.68x1.68mm_ThermalVias | TPS62130RGTR (TPS62130AQRGTRQ1 = AEC option) | 2
U301 | PI7C9X3G606GP | Package_BGA:LFBGA-144_10x10mm_Layout12x12_P0.8mm | PI7C9X3G606GPAEX (GPQ = AEC-Q100 option) | 1
U302 | SN74LVC1G07DCKR | Package_TO_SOT_SMD:SOT-353_SC-70-5 | TI SN74LVC1G07DCKR | 1
U303 | 25AA640A | Package_SO:SOIC-8_3.9x4.9mm_P1.27mm | 25AA640A-I/SN (1.8V, 2-byte addr) VERIFY vs switch EEPROM format | 1
U304 | PCA9306DCUR | Package_SO:VSSOP-8_2.3x2mm_P0.5mm | PCA9306DCUR | 1
U401,U501,U601 | SN74LVC1G08DCKR | Package_TO_SOT_SMD:SOT-353_SC-70-5 | TI SN74LVC1G08DCKR | 3
U402,U502,U602 | TPD4E05U06DQAR | Package_SON:USON-10_2.5x1.0mm_P0.5mm | TI TPD4E05U06DQAR | 3
U701,U702,U703 | TPD4EUSB30DQAR | Package_SON:USON-10_2.5x1.0mm_P0.5mm | TPD4EUSB30DQAR | 3
U704 | HD3SS3220RNHR | Package_DFN_QFN:Texas_RNH0030A_WQFN-30-1EP_2.5x4.5mm_P0.4mm_EP1.2x3.2mm | HD3SS3220RNHR | 1
U705 | USB5744/2G9 (verify ordering suffix) | Package_DFN_QFN:QFN-56-1EP_7x7mm_P0.4mm_EP5.6x5.6mm_ThermalVias | USB5744-I/2G (industrial) VERIFY suffix | 1
U801,U802 | TCA6416APWR | Package_SO:TSSOP-24_4.4x7.8mm_P0.65mm | TCA6416APWR (TCA6416ATPWRQ1 = AEC option, VERIFY) | 2
Y701 | 25MHz | Crystal:Crystal_SMD_3225-4Pin_3.2x2.5mm | Abracon ABM8-25.000MHZ-B2-T (VERIFY CL vs load caps) | 1
