jmendoza-10/connectivity-module-public/docs/open-issues.md

# Open issues and unverified items

Everything below is **unverified** until closed with evidence (measurement, datasheet section, vendor answer). "Close by" says how.
Generated per-part VERIFY flags (MPNs, footprints) are listed in [hw-sw-interface.md](hw-sw-interface.md) sec. 8 and in the BOM;
they are summarised as OI-20..OI-22 here.

**Roadmap issues (GitHub):** [#1 power-management MCU](https://github.com/jmendoza-10/connectivity-module/issues/1) (OI-07, OI-12, OI-27, OI-38..OI-41), [#2 host abstraction](https://github.com/jmendoza-10/connectivity-module/issues/2) (OI-10, OI-12, OI-16), [#3 low-power PARK mode](https://github.com/jmendoza-10/connectivity-module/issues/3) (OI-30, OI-34), [#4 vehicle networking](https://github.com/jmendoza-10/connectivity-module/issues/4) (OI-37), [#5 eCall / NG eCall](https://github.com/jmendoza-10/connectivity-module/issues/5) (OI-26).

| ID | Area | Item | Risk if wrong | Close by | Test |
|---|---|---|---|---|---|
| OI-01 | Host | FRDM-IMX95 header pins / LPI2C instance / GPIOs for J801 (SCL, SDA, EXP_INT_N, EXP_RESET_N, 3V3 sense); header I/O voltage must be 3.3 V | No control of carrier | FRDM-IMX95 schematic + board user guide; update overlay placeholders | T1.1 |
| OI-02 | Software | DT overlay compiles with dtc (syntax only, stub headers) but is untested against the NXP BSP: labels, pinctrl, overlay fixups | Expanders not probed | Build in Yocto/BSP, boot, `gpioinfo` | T1.7 |
| OI-03 | Modem | USB host-interface mode (rev 0.3): FN990 pin 20 high (internal 10k PU) = USB only, [FN990] Table 29; EM92 PCIE_DIS (pin 20) high = USB and needs VBUS_SENSE (pin 22) high, [EM92] Tables 2-1, 2-12. Open: EM92 PCIE_DIS internal pull-down strength vs 10k DNP PU; whether PERST# must stay low in USB mode; FN990 USB composition (`AT#USBCFG`) | USB fallback useless | Bench with DNP Rx08/Rx09 fitted (Sierra only); vendor FAE | T6.1 |
| OI-04 | I2C | PI7C9X3G606GP I2C address: DS43484 text says default 1101111b = 0x6F, examples show 68h | Wrong address in tools (debug only) | `i2cdetect` | T1.2 |
| OI-05 | I2C | USB5744 SMBus address 0x2D (from Linux binding example, not found in DS00001855J text) and attach command (0xAA / 0x0056 from Linux onboard_usb_dev.c) | Hub never leaves SOC_CFG -> no USB | `i2cdetect`; T3.1; Microchip AN for SMBus config | T1.2, T3.1 |
| OI-06 | Timing | USB5744 RESET_N min assertion trstia: extracted text shows "5" with garbled unit (likely µs); carrierctl uses 5 ms | none if µs | Read DS00001855J Table 10-7 in the PDF | - |
| OI-07 | Power | USB5744 VDD12 (+1V2) rises after VDD33 (+3V3) because +1V2 EN = PG_3V3; Table 10-5 tVDD33 suggests VDD12 no later than VDD33 | Hub mis-start / latch-up risk (unknown) | Scope (T0.4); ask Microchip; rev 0.3: hold HUB_RESET_N low until PG_1V2 (add AND/RC) or enable +1V2 first | T0.4, T3.1 |
| OI-08 | PCIe SI | Gen3 through the FRDM M.2 Key-M -> ADT-Link riser -> carrier edge; REFCLK presence on the FRDM M.2 connector; switch PERST_L slew (>= 50 mV/ns, DS43484) through the cable | Link fails / downtrains | Scope REFCLK/PERST#; LnkSta; force Gen2 if needed | T4.1, T4.2 |
| OI-09 | Modem | FCC lock state of purchased EM9291 / FN990A28 units; MM fcc-unlock helper for 1199:90e3 / 17cb:0308 (sub 18d7:0301, 1c5d:2010) in the MM version used | Radio stays off | `mmcli -m N` state; MM package contents | T5.1 |
| OI-10 | Kernel | BSP `mhi_pci_generic` contains the EM929x (18d7:0301) and FN990 (1c5d:2010) subsystem entries (mainline master has both, checked 2026-10-10); FN990**A28** subsystem ID not confirmed (assumed 1c5d:2010) | Card binds with generic sdx65 config (wrong channels) | `modinfo mhi_pci_generic`; `lspci -nnv` on first card; backport | T4.3 |
| OI-11 | PCIe | Downstream port BDFs and whether PI7C reports LNKCAP port number = P1/P4/P5 (carrierctl uses it to map slots); whether unused P6/P7 appear | carrierctl maps wrong slot | `lspci -vv` on downstream ports | T4.1 |
| OI-12 | PCIe/Linux | BAR / bus-number assignment for endpoints that appear after boot behind a non-hot-plug switch | Modems powered after boot unusable without reboot | Try `pci=realloc`; U-Boot pre-power; switch hot-plug strap in rev 0.3 | T4.4 |
| OI-13 | Software | EXP_RESET_N is shared by both expanders; pca953x takes `reset-gpios` exclusively, so only one DT node can own it, and the "emergency all-off" pulse then needs a driver path | No emergency all-off from userspace | Decide: leave reset-gpios out of DT and drive EXP_RESET_N from a gpio-hog/userspace, or keep in U801 node | T1.7 |
| OI-14 | Modem | Rev 0.3 sequence releases RESET# before power and never holds it at power-up (FN990: RESET must not be low at power-on; EM92: RESET_N open-collector only). Open: does the 2N7002 gate default (pull-down) guarantee RESET# released while U801 is in reset - yes by design; confirm on bench | Card stuck in reset / boot-mode side effect | Bench T2.2/T4.3 | T4.3 |
| OI-15 | Timing | Engineering choices in carrierctl (rev 0.3): PWR_EN -> PG timeout 50 ms, PERST# 200 ms after PG (EM92 T_pvpgl >= 150 ms is datasheet), rescan after 1 s and retry to 10 s, FCPO# -> power-off wait 15 s (EM92 max 12 s), off time 1 s, inter-slot stagger 2 s, AT+CFUN=0 cap 5 s | Spurious failures or slow recovery | Measure, then tune constants in carrierctl.py | T2.1, T5.3, T7.1 |
| OI-16 | PCIe | Surprise link-down on one switch port during slot power-cycle: AER/DPC behaviour of PI7C + i.MX 95 root port | Other slots disturbed | dmesg during T5.4 | T5.4 |
| OI-17 | Power | PI7C 0.95 V vs 1.8 V rail order (rev 0.2 starts both from PG_3V3 together) | Switch start-up issue | Read full DS43484 sec. 10 figure; scope | T0.4, T4.1 |
| OI-18 | Software | gpiod backend: line state after carrierctl exits (released lines keep value in pca953x, not an ABI guarantee) | Glitch on exit | Bench check; long-term: daemon holding the requests | T1.3 |
| OI-19 | Thermal | 3x 5G cards (EM9291 / FN990A28) at full load in the bench enclosure; operating ranges per vendor guides not yet copied into the test plan | Throttling / shutdown | T5.7, T7.2 | T5.7 |
| OI-20 | BOM | Parts with MPN VERIFY flags (C106, C401-C602 polymer caps, F101 I2t, Q101/Q102, U303 EEPROM format, U705 ordering suffix, U801/U802 AEC option, Y701 CL, FB beads, D301-D304) | Wrong part ordered | Distributor/datasheet check before ordering | - |
| OI-21 | Footprints | M.2 socket LOTES APCI0026-P001A (no KiCad footprint), LM61460 RJR0014A, PI7C FCA144 vs generic LFBGA-144, USB5744 EP size, LM74800 DRR EP must float, PCIe edge bevel/hard gold | Unbuildable PCB | Create/verify footprints before layout (see hardware/kicad/README.md) | - |
| OI-22 | Schematic | R342-R344 present-detect option (0 ohm) - VERIFY intent | PRSNT wiring wrong | Decide hot-plug/present-detect strategy with OI-12 | - |
| OI-23 | Docs | FRDM-IMX95 DTS location/name and kernel config symbol names in the NXP BSP (PCI_IMX6_HOST, DWC3 glue, Type-C) | Build friction | Check BSP defconfig | - |
| OI-24 | Modem | `wwanNat0`/`wwanNmbim0`/`wwanNqmi0` naming per mhi_wwan_ctrl version (channels per mainline pci_generic: EM929x MBIM/QMI/DUN/DIAG/IP_HW0; FN990 MBIM/DUN/DUN2/NMEA/IP_HW0_MBIM); MM >= 1.22 support for EM929x data over mhi_net | Tool paths wrong / no data | Bench | T4.3 |
| OI-25 | Bonding | All bonding requirement values (bonding-requirements.md TODOs) | No pass/fail for T8 | open decision | T8 |
| OI-26 | Supply chain | **No Chinese-company chips/modules (decision 2026-10-10).** FM350-GL (Fibocom) and all Quectel parts are excluded, which voids the FM350-based assumptions in OI-03, OI-09, OI-10, OI-14, OI-19, OI-24, power-reset-sequencing.md, linux-bringup.md (t7xx) and the schematic title/pin names. Open: (a) rev 0.3 slot changes for the replacement cards (pin-20 pull-down for Telit FN990 PCIe select, DNP pin-22 VBUS_SENSE pull-up for Sierra, 42 mm standoff, 3.3 V FB option for AIW-357; see parts-shortlist.md rev 0.4); (b) Nexperia parts Q101/Q102, U302, U401-U601 (Wingtech-owned) to onsemi/TI; (c) pin MPNs for generic R/C/headers/TVS; (d) does the rule cover bench fixtures (ADT-Link riser, pigtails) and PCB fab/assembly (JLCPCB)? (e) is Rolling Wireless (Fibocom-owned until Jul 2024) acceptable? (f) country-of-manufacture vs company HQ Status 2026-10-10: (a) done in rev 0.3 except the AIW-357 3.3 V option (AIW-357 VCC max 3.63 V < our 3.74 V slot rail - do **not** fit an AIW-357 on rev 0.3), (b) done, (c) done with VERIFY flags (OI-20/OI-33); (d)(e)(f) open; (f) now also affects the S32K3 power MCU (OI-38) | Ordering or building with an excluded part; budget overrun (3x 5G no longer fits $1,500) | decisions still open on (d)(e); schematic rev 0.3; re-run ERC + gen_interface; per-module timing from EM92 PTS / FN990 HDG | T2.x, T4.3 re-baselined per module |
| OI-27 | Modem/HW | No graceful-shutdown monitor: EM92 requires FCPO# low -> wait PLA_S2_N (pin 28) low -> remove power; FN990 indicates via VREG_L6B_1P8 (pin 65). Rev 0.3 only has TPs on pin 28 and a fixed 15 s wait. Proposal: 1.8 V->3.3 V level shift of pin 28 / pin 65 into U802 P1.7 (EXP_SPARE7) per slot (needs 2 more inputs - second-stage expander or OR) | Power removed during flash write -> corrupted card | Decide for rev 0.4; bench measure shutdown time | T5.3 |
| OI-28 | Modem | FN990 power-on/PERST#/shutdown timing figures (HDG Rev 3 sec. 6.x figures) were not fully extracted; sequence uses EM92 numbers + margin | PERST# released too early for FN990 | Read FN990 HDG figures in the PDF; bench T4.3 | T4.3 |
| OI-29 | PCIe | FN990 PCIE_RESET_N / CLKREQ_N / WAKE_N are in the VPH (VCC) domain with 100k PU to VPH; carrier pulls/levels these at 3.3 V via the switch side. Check for back-drive into the card and CLKREQ# pull-up conflict | Leakage / wrong levels | Review FN990 HDG electrical table; scope | T4.1 |
| OI-30 | Power | Card back-feed when the slot rail is off: LED1# anode on +3V3, pin-20 FET path, SIM ESD, USB/PCIe AC paths. Rev 0.3 keeps PCIE_SEL=1 and PERST# low when off; LED path not fixed | Card partially powered / latch-up | Measure +3V7_Sn with slot off and others on | T2.3 |
| OI-31 | Modem | Sierra SIM detect (pin 66) polarity/enable is AT-configurable (EM92: 0 V = absent); FN990 UIM1_PRESENT 1.8 V with PU. Carrier SIM CD wiring vs the nano-SIM holder switch polarity | SIM not detected | AT config check; bench | T5.1 |
| OI-32 | GNSS | EM9291 GNSS is on shared ANT1 (passive antenna only - DC on ANT0-3 damages the module); FN990 dedicated GNSS port with internal bias LDO (2.9-3.15 V, 100 mA) - verify which FN990A28 port carries bias and that GNSS-only pigtail/antenna is correct; EM9293 (MHF7S, 3.0-3.25 V bias) if used later | Damaged module / no fix | See antenna-gnss-plan.md; vendor FAE | - |
| OI-33 | BOM | Rev 0.3 maker MPNs needing check: Würth WA-SMSI standoffs (3052/3042 height), Samtec TSW header suffix, onsemi NVMFS5C646NL SOA for LM74800 inrush, AEC alternates for 2N7002 (onsemi 2N7002ET1G / Diodes 2N7002Q-7-F), LOTES socket stack height vs card | Wrong part ordered | Distributor/datasheet check | - |
| OI-34 | Modem | Pin 20 / pin 28 / pin 65 are 1.8 V card signals; pin 20 is driven only by an open-drain FET (safe). Pin 28/65 are TP-only. Any future host connection needs level shifting | Over-voltage on card GPIO | Keep TP-only until OI-27 design | - |
| OI-35 | NTN | NTN-capable M.2 cards (future) may need extra antenna (L/S-band), a different VCC range or pin usage on 24/38/68 (left NC in rev 0.3) | Slot incompatible with NTN card | Re-check pinout when an NTN M.2 card is selected (nRF9151 decision still open, not on this carrier) | - |
| OI-36 | Power | FN990 max input ripple 30 mV ([FN990] Table 15) vs LM61460 at 400 kHz with 2x220 uF bulk at the slot: not calculated. EM92 limit 100 mVpp | RF spurs / desense on FN990 | Measure at the M.2 VCC pins under load (T2.5); add LC post-filter or more low-ESR bulk if needed | T2.5 |
| OI-37 | GNSS/Timing | FN990 outputs **1PPS on M.2 pin 38** (1.8 V, "1PPS/TSN", [FN990] HDG Rev 3 pin table), but rev 0.3 leaves pin 38 NC because Sierra EM92 uses pin 38 as optional VCC. Proposal: per-slot **Telit-only DNP** 0R/series resistor from pin 38 to a 1.8 V->3.3 V level shifter (e.g. TI SN74LXC1T45 class, VERIFY) feeding the host/switch PTP 1PPS input; DNP by default, never fitted with a Sierra card (would short the card's VCC option into the shifter). See [#4 vehicle networking](https://github.com/jmendoza-10/connectivity-module/issues/4) | No GNSS-disciplined gPTP from the modems; or damage if fitted with a Sierra card | Decide in #4 (dedicated GNSS receiver vs FN990 1PPS); verify FN990 1PPS accuracy and enable AT command in Telit docs; netcheck rule for DNP | - |
| OI-38 | Supply chain | Power MCU **NXP S32K344EHT1MPBST** (issue #1 decision 1.1): NXP is a Dutch company, but distributor listings give **country of origin China** (NXP assembly/test). Same question as OI-26(f). Alternatives are other S32K3 parts with the same COO situation; no non-NXP lockstep+HSM MCU evaluated yet (Infineon AURIX TC3xx / Renesas RH850 would be a full redesign) | Rule violation if (f) is decided as "country of manufacture" | decision still open on OI-26(f); ask NXP for assembly-site options | - |
| OI-39 | Power | Host power switch sizing ([#1](https://github.com/jmendoza-10/connectivity-module/issues/1)): primary **TI TPS1HC30-Q1** (5 A, adjustable ILIM) / alt **Infineon BTS7008-1EPP** (11 A). Needs the chosen host and its **supply current (steady, peak, inrush, input capacitance)**; all host currents in power-mcu.md sec. 6.4 are [U]. Also: does the host expose a **reset input** (HOST_RESET#) for the escalation ladder? | Nuisance trips on inrush; switch/thermal undersized; escalation skips reset step | Host decision (#2); host datasheet; measure inrush on bench | T-new |
| OI-40 | Security | HSE secure boot ([#1](https://github.com/jmendoza-10/connectivity-module/issues/1)): HSE firmware, SAF and the HSE service reference are behind NXP licence/NDA; key provisioning station owner, ECDSA curve, debug-lock option and lifecycle advance procedure not decided. No keys in repo/CI (firmware/docs/provisioning.md) | Bricked parts (lifecycle mistakes); no production secure boot | NXP account/NDA; provisioning plan; first EVB trial on S32K3X4EVB-T172 [U: EVB part number] | - |
| OI-41 | Safety | ASIL-B safety case ([#1](https://github.com/jmendoza-10/connectivity-module/issues/1)): HARA not done; SG-1 (no unintended slot/host power loss during eCall) vs SG-2 (no uncontrolled host power on fault) conflict on the **host-EN default/safe state** (power-mcu.md sec. 7); FMEDA metrics and TSR-1..6 are placeholders | Wrong safe state; ASIL claim unsupported | HARA with item definition; decide host-EN latch; FMEDA after rev 0.4 schematic | - |

## Closed

(none yet)
