jmendoza-10/connectivity-module-public/hardware/wwan-carrier-schematic-rev0.3.pdf

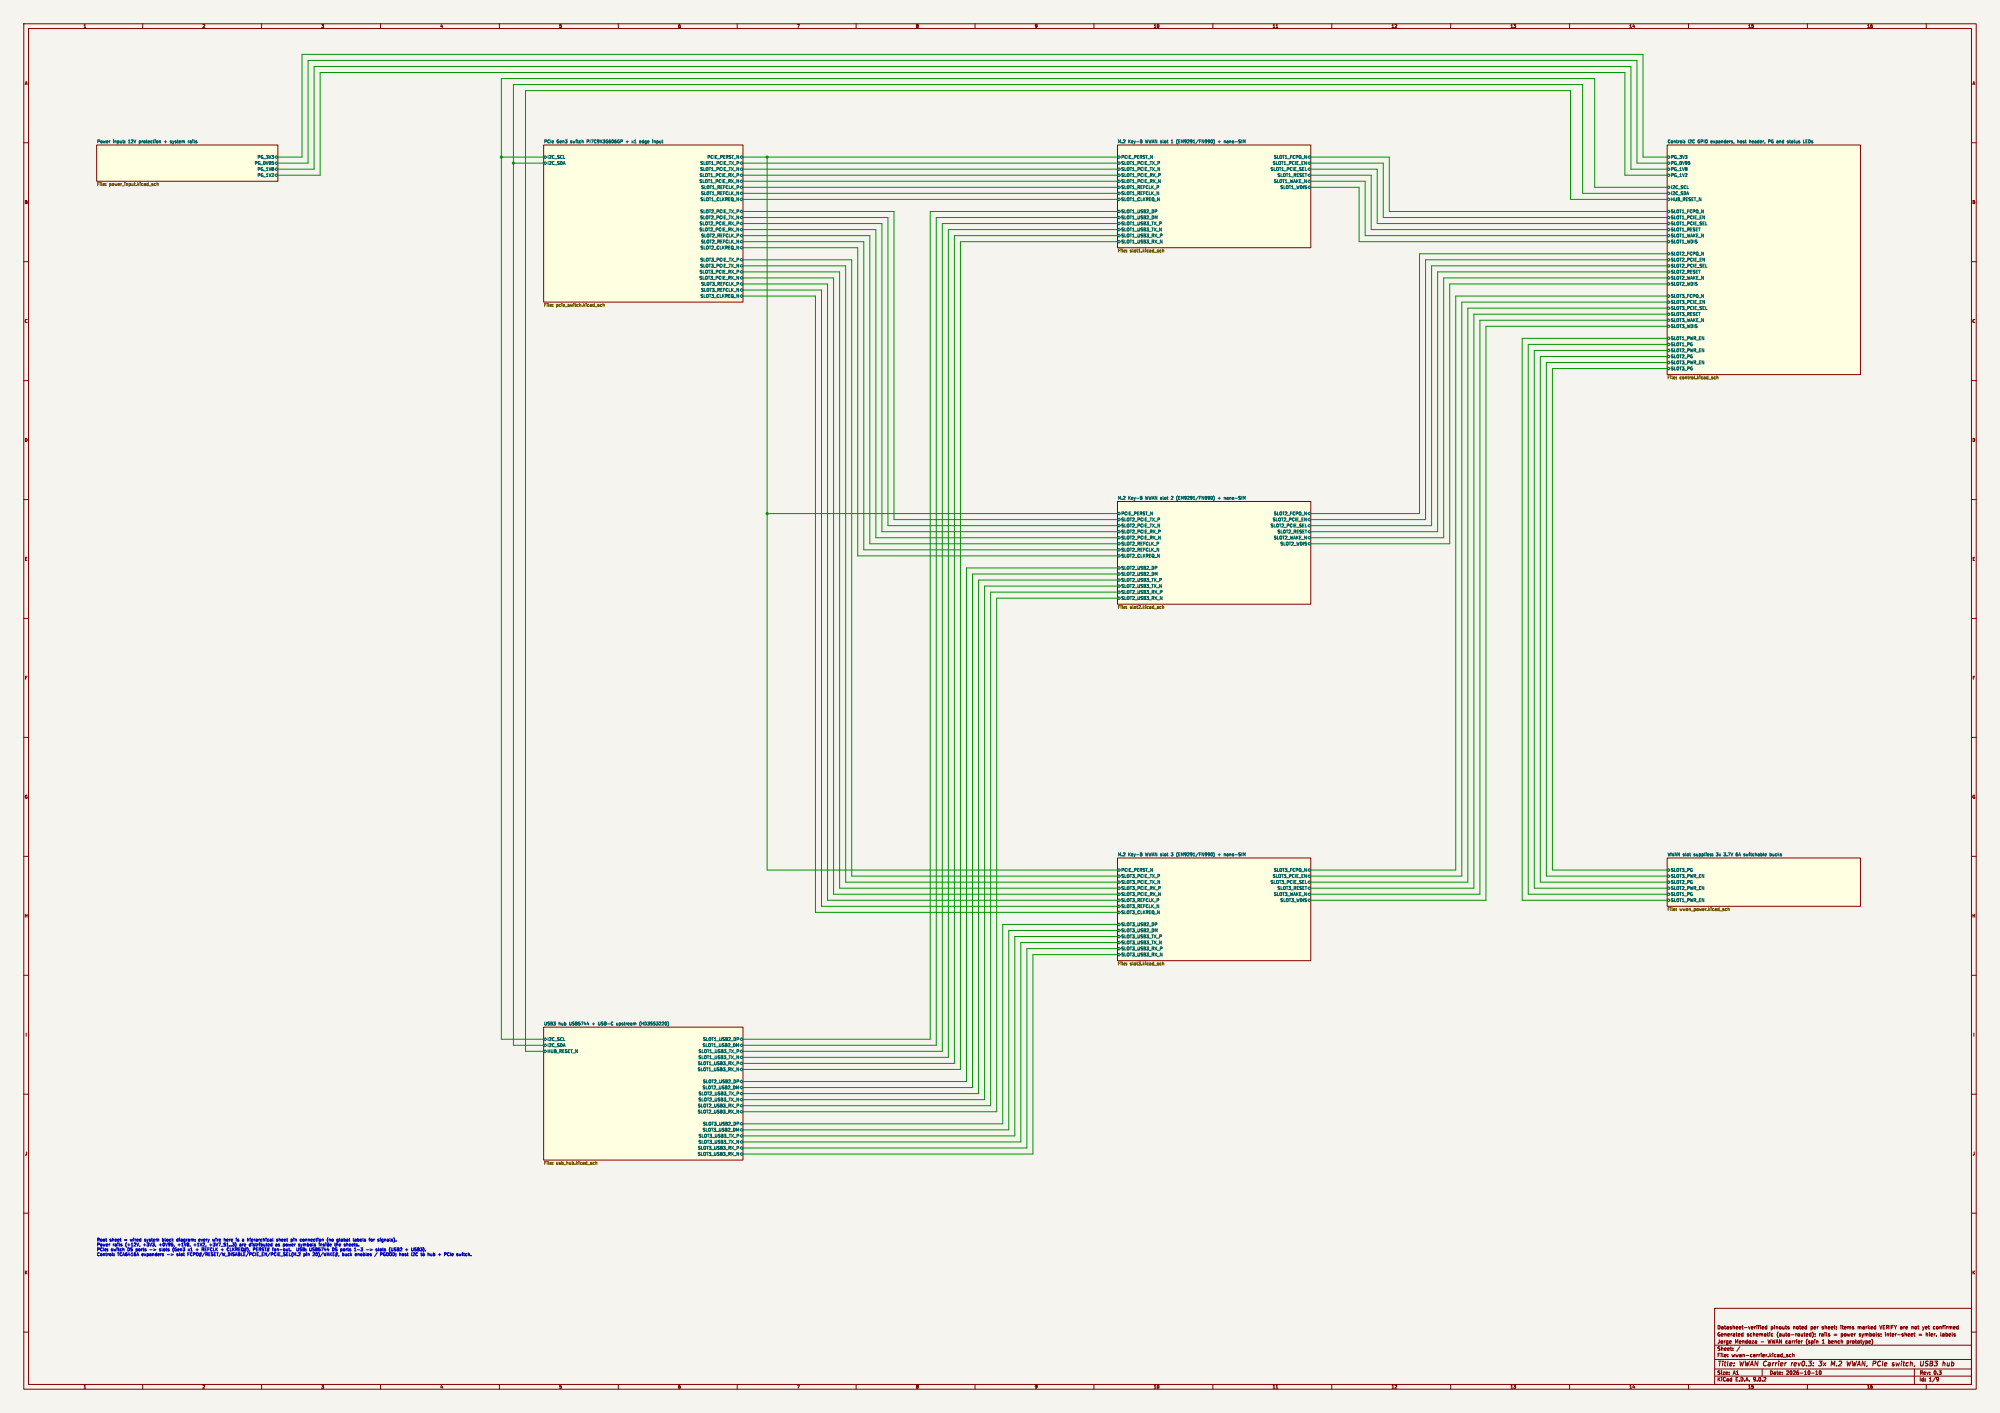
[picture p8: page 1]

PG_3V3 PG_0V95 PG_1V8 PG_1V2 Power input: 12V protection + system rails File: power_input.kicad_sch

Control: I2C GPIO expanders, host header, PG and status LEDs File: control.kicad_sch

SLOT1_PWR_EN WWAN slot supplies: 3x 3.7V 6A switchable bucks File: wwan_power.kicad_sch

Id: 1/9 Title: WWAN Carrier rev0.3: 3x M.2 WWAN, PCIe switch, USB3 hub

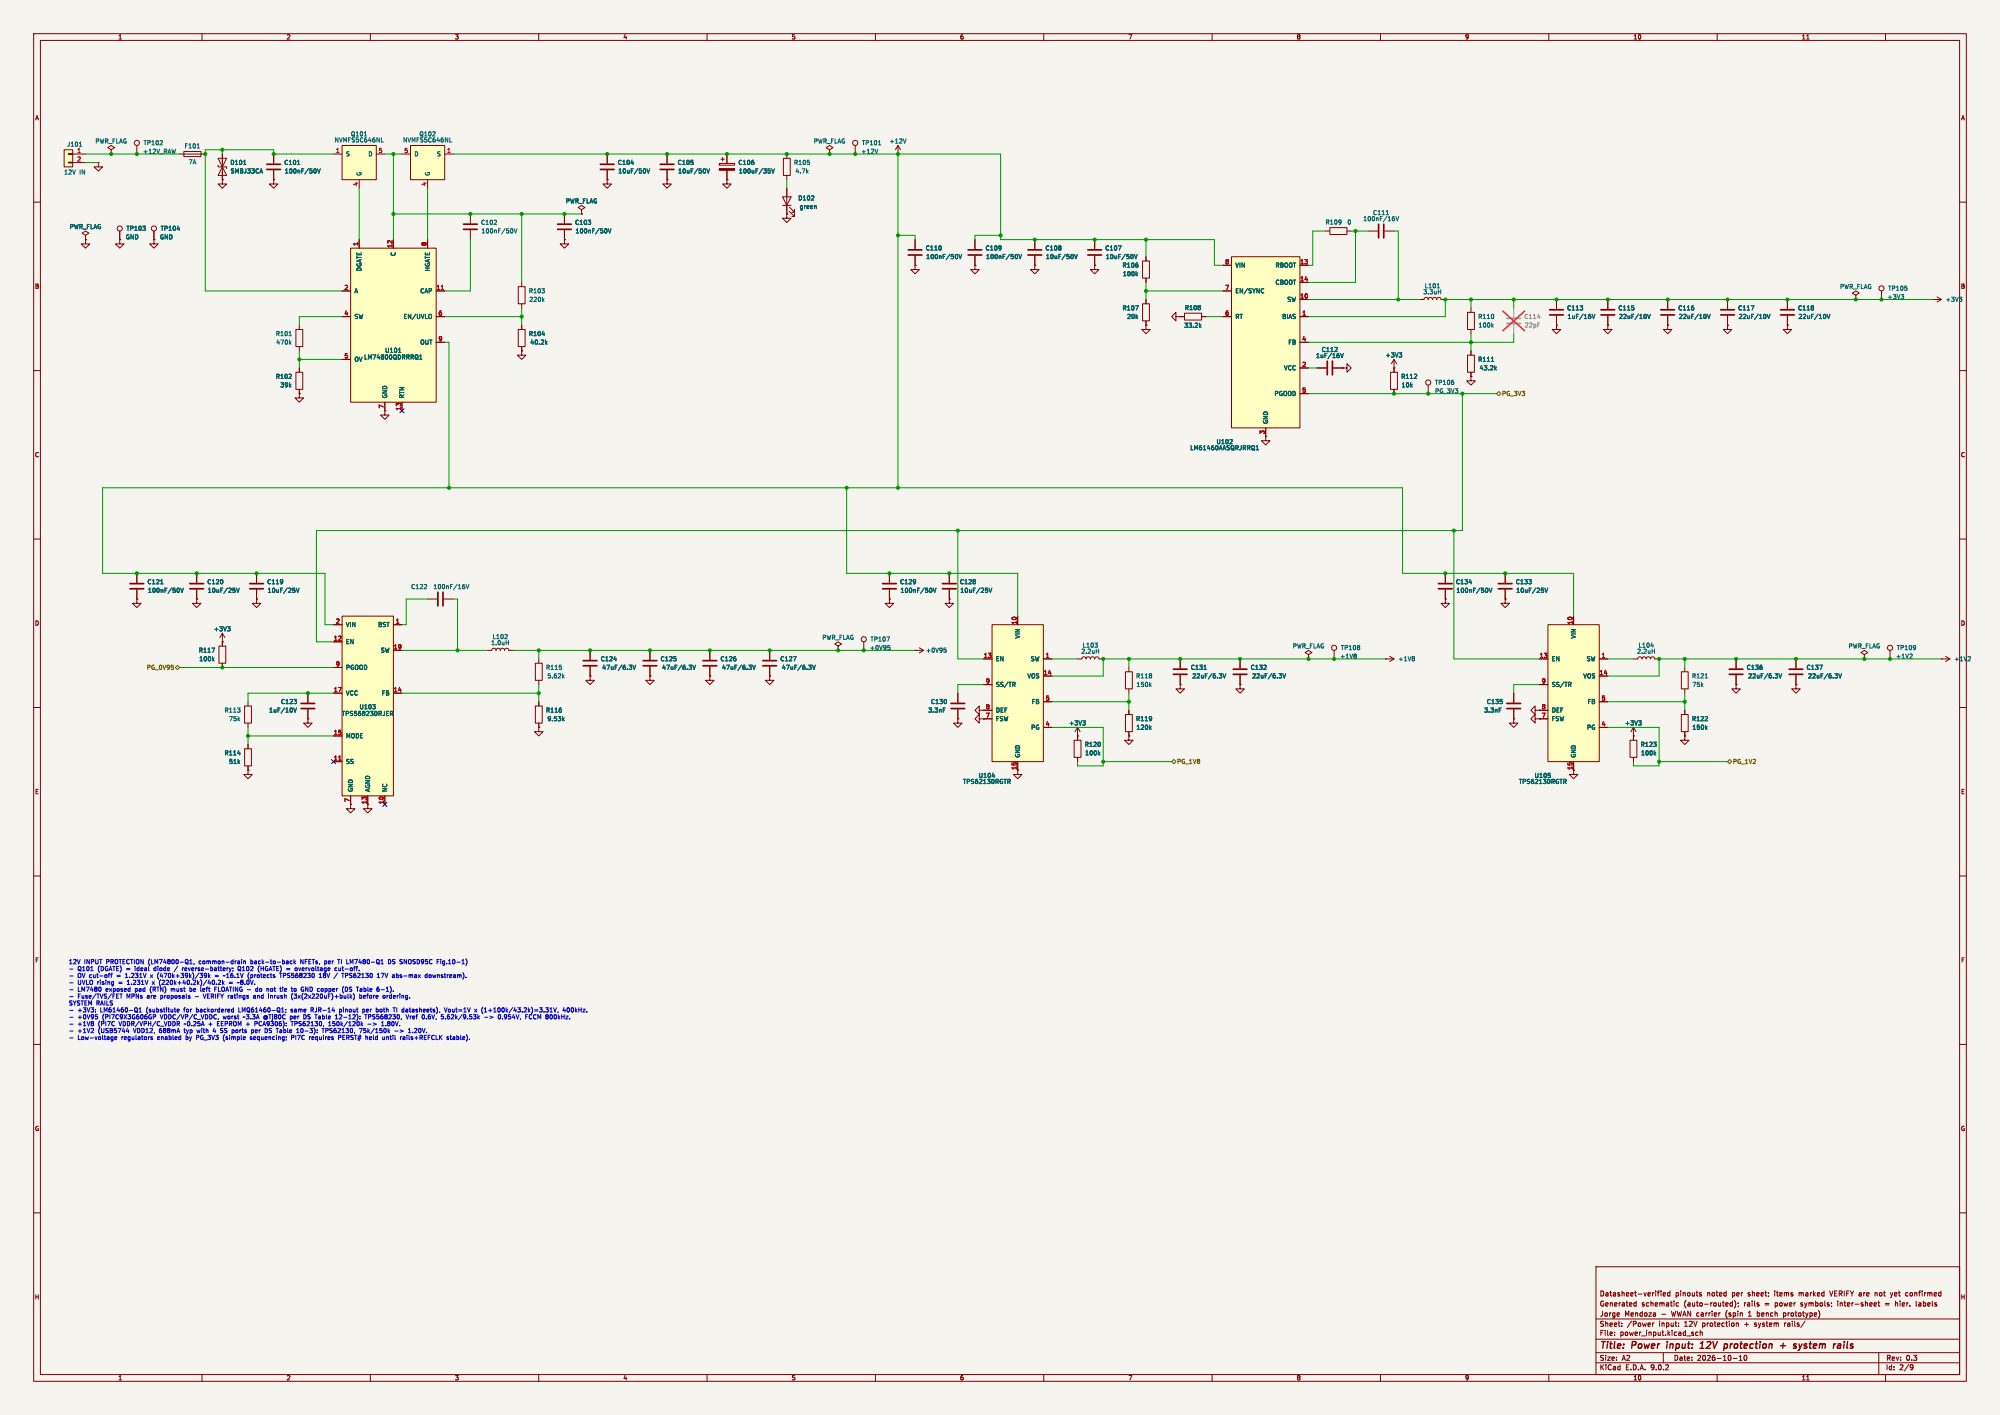
[picture p9: page 2]

8 CAP 11 EN/UVLO 6 OUT 9 C103

8 CAP 11 EN/UVLO 6 OUT 9 U101

+3V3 VIN 2 EN 12 PGOOD 9 VCC 17 MODE 15 SS 11 GND

VIN 2 EN 12 PGOOD 9 VCC 17 MODE 15 SS 11 GND

7 AGND 13 NC 10 BST 1 SW 19 FB 14 U103 TPS568230RJER

7 AGND 13 NC 10 BST 1 SW 19 FB 14

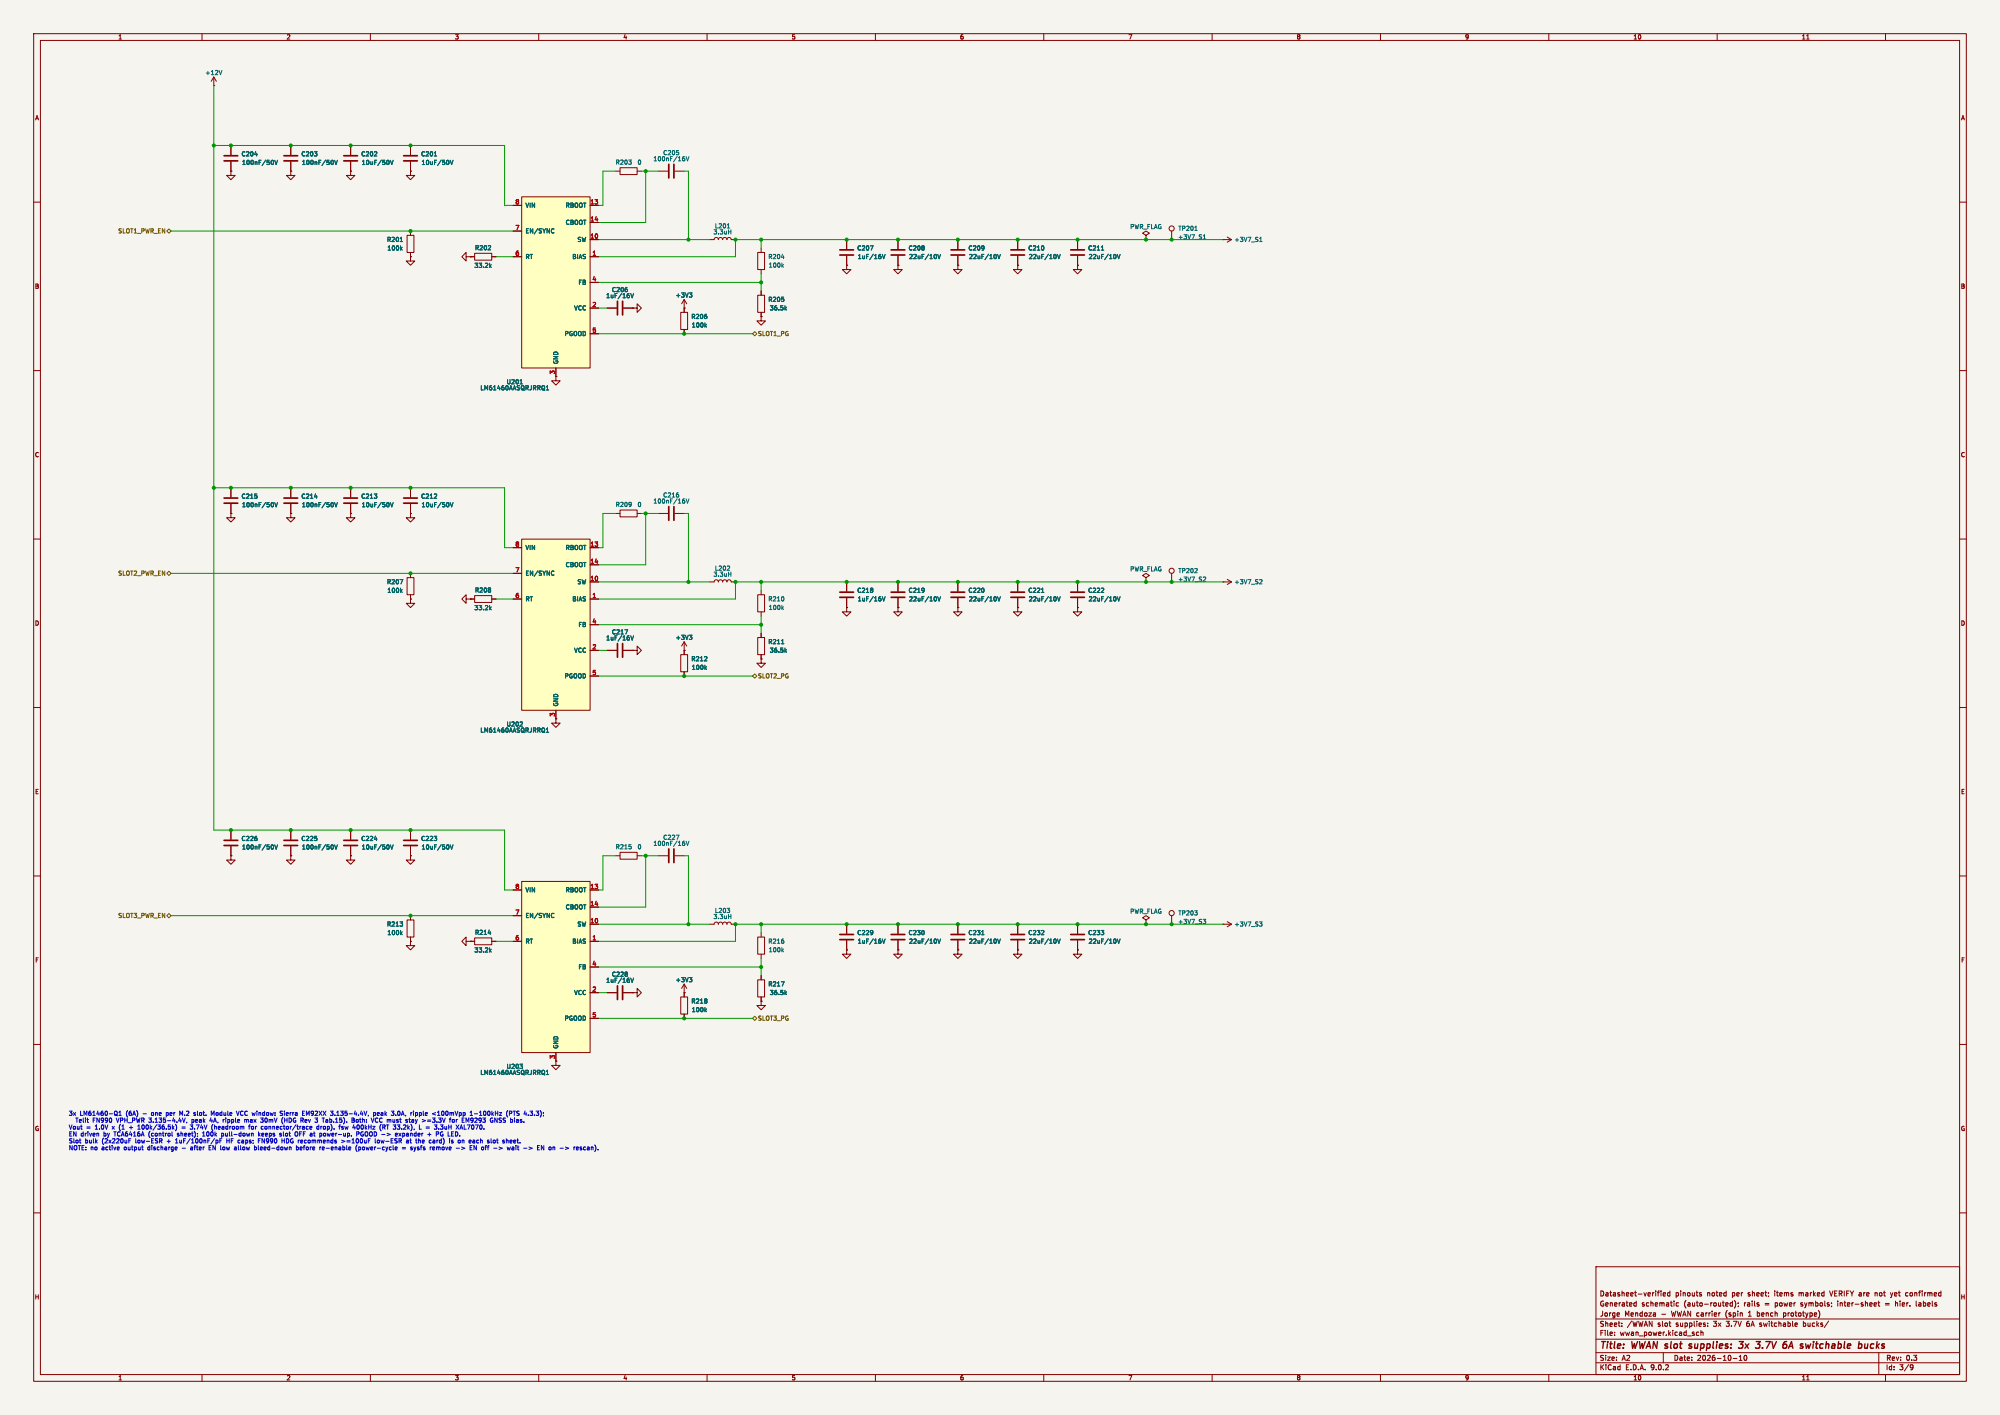
[picture p10: page 3]

3 RBOOT 13 CBOOT 14 SW 10 BIAS 1 FB 4 VCC 2 PGOOD 5 R207

3 RBOOT 13 CBOOT 14 SW 10 BIAS 1 FB 4 VCC 2 PGOOD 5 U201

3 RBOOT 13 CBOOT 14 SW 10 BIAS 1 FB 4 VCC 2 PGOOD 5 R208

3 RBOOT 13 CBOOT 14 SW 10 BIAS 1 FB 4 VCC 2 PGOOD 5 U202

3 RBOOT 13 CBOOT 14 SW 10 BIAS 1 FB 4 VCC 2 PGOOD 5 C226

3 RBOOT 13 CBOOT 14 SW 10 BIAS 1 FB 4 VCC 2 PGOOD 5 U203

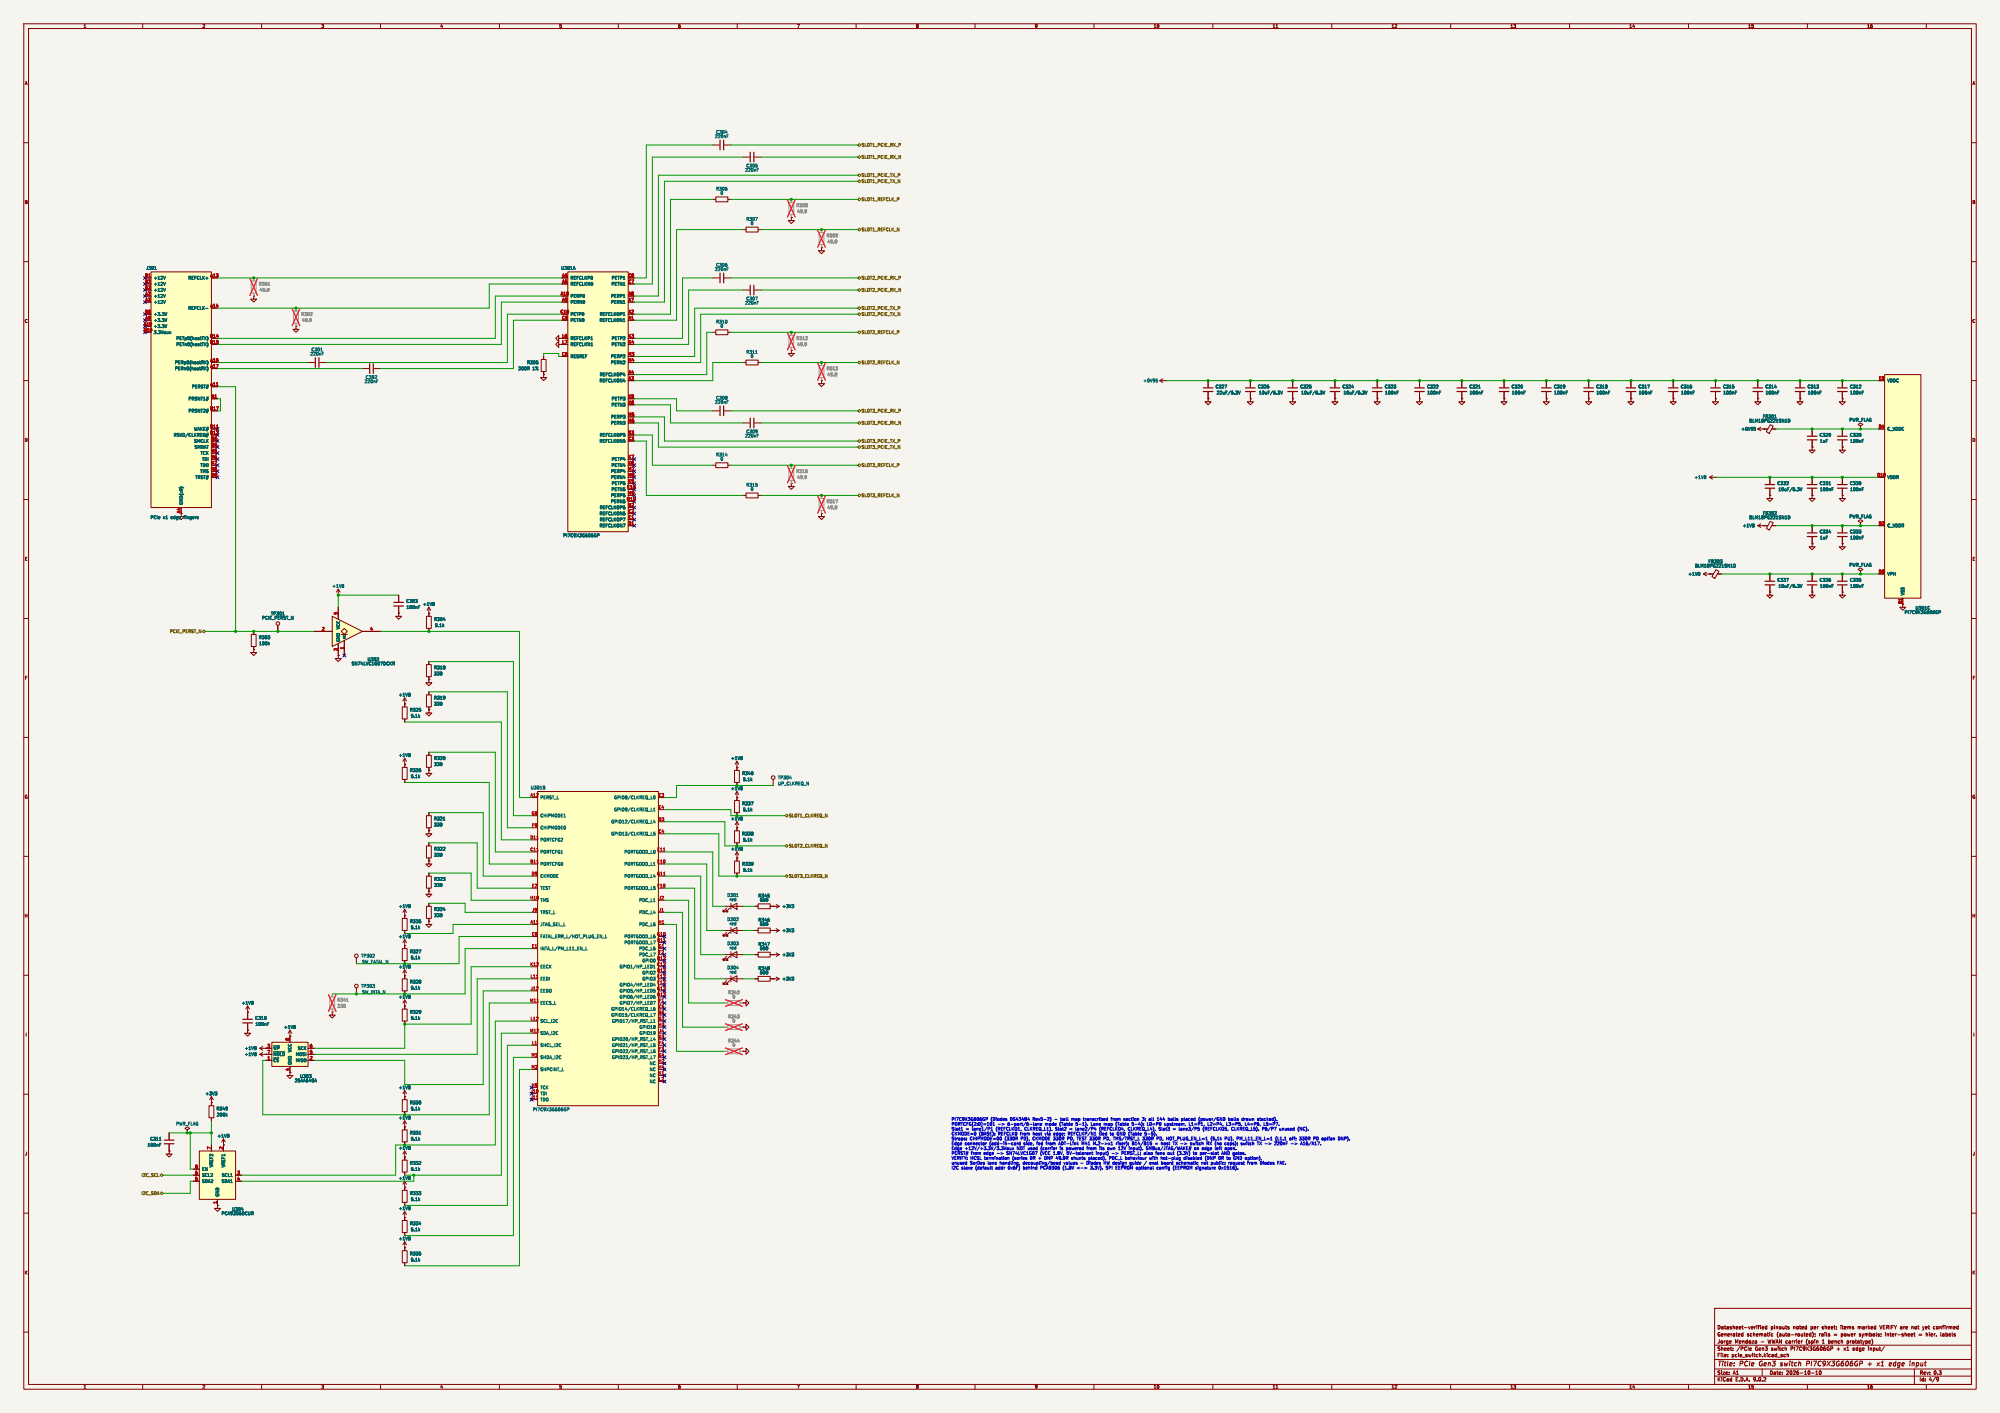
[picture p11: page 4]

INTA_L/PM_L11_EN_L E1 EECK K12 EEDI L11 EEDO J12 EECS_L M11 SCL_I2C L12 SDA_I2C M12 SHCL_I2C L1 SHDA_I2C M1 SHPCINT_L M2 TCK H9 TDI J10 TDO J11

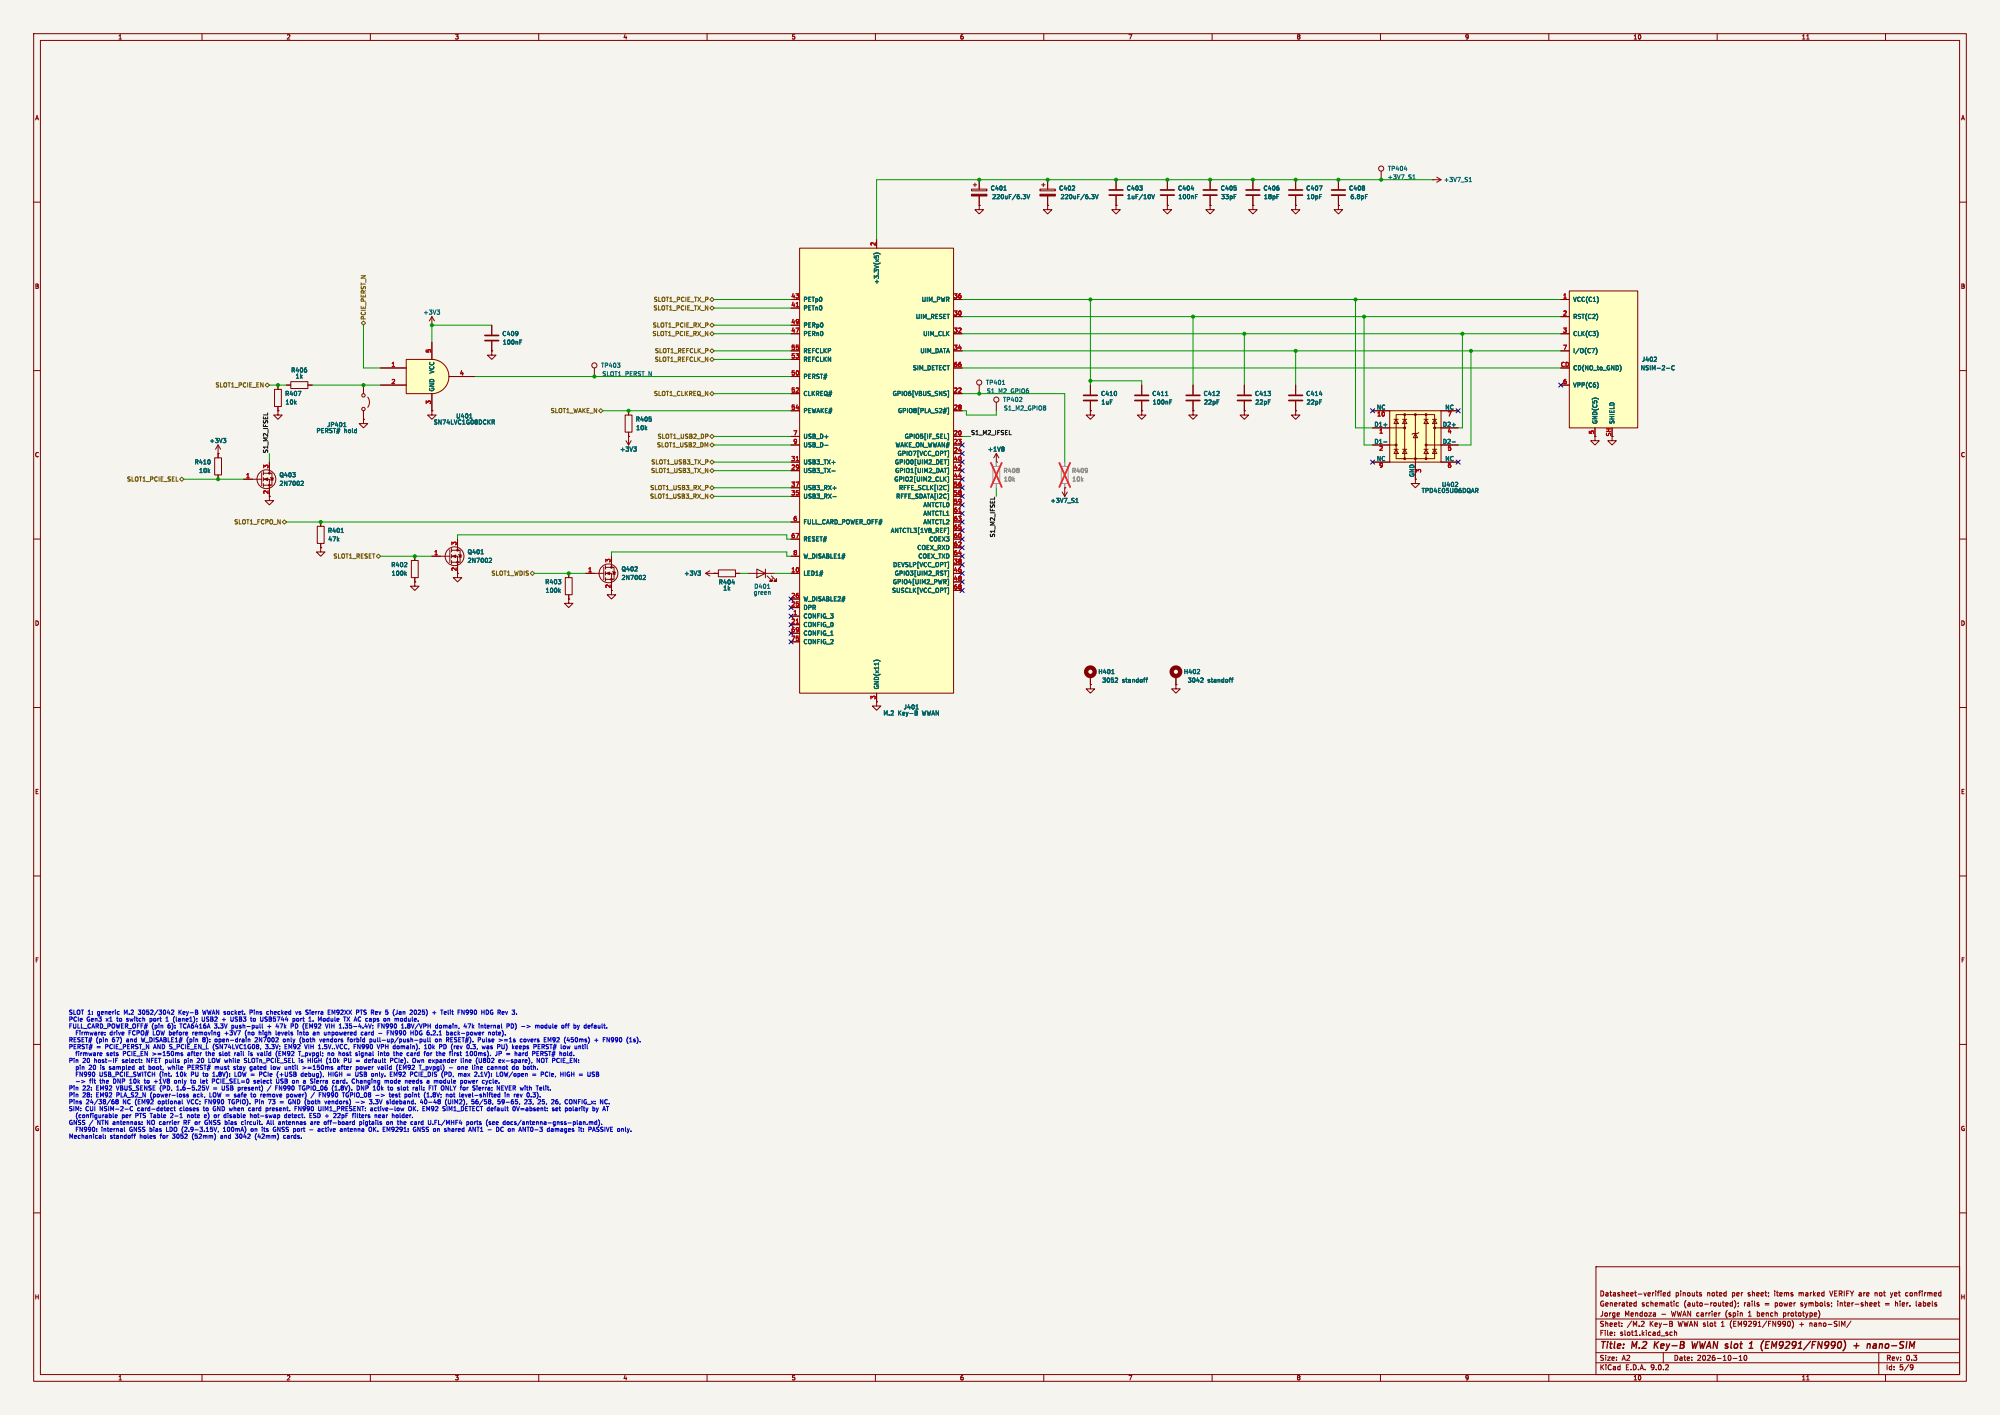
[picture p12: page 5]

PETp0 43 PETn0 41 PERp0 49 PERn0 47 REFCLKP 55 REFCLKN 53 PERST# 50 CLKREQ# 52 PEWAKE# 54 USB_D+ 7 USB_D- 9 USB3_TX+ 31 USB3_TX- 29 USB3_RX+ 37 USB3_RX- 35 FULL_CARD_POWER_OFF# 6 RESET# 67 W_DISABLE1# 8

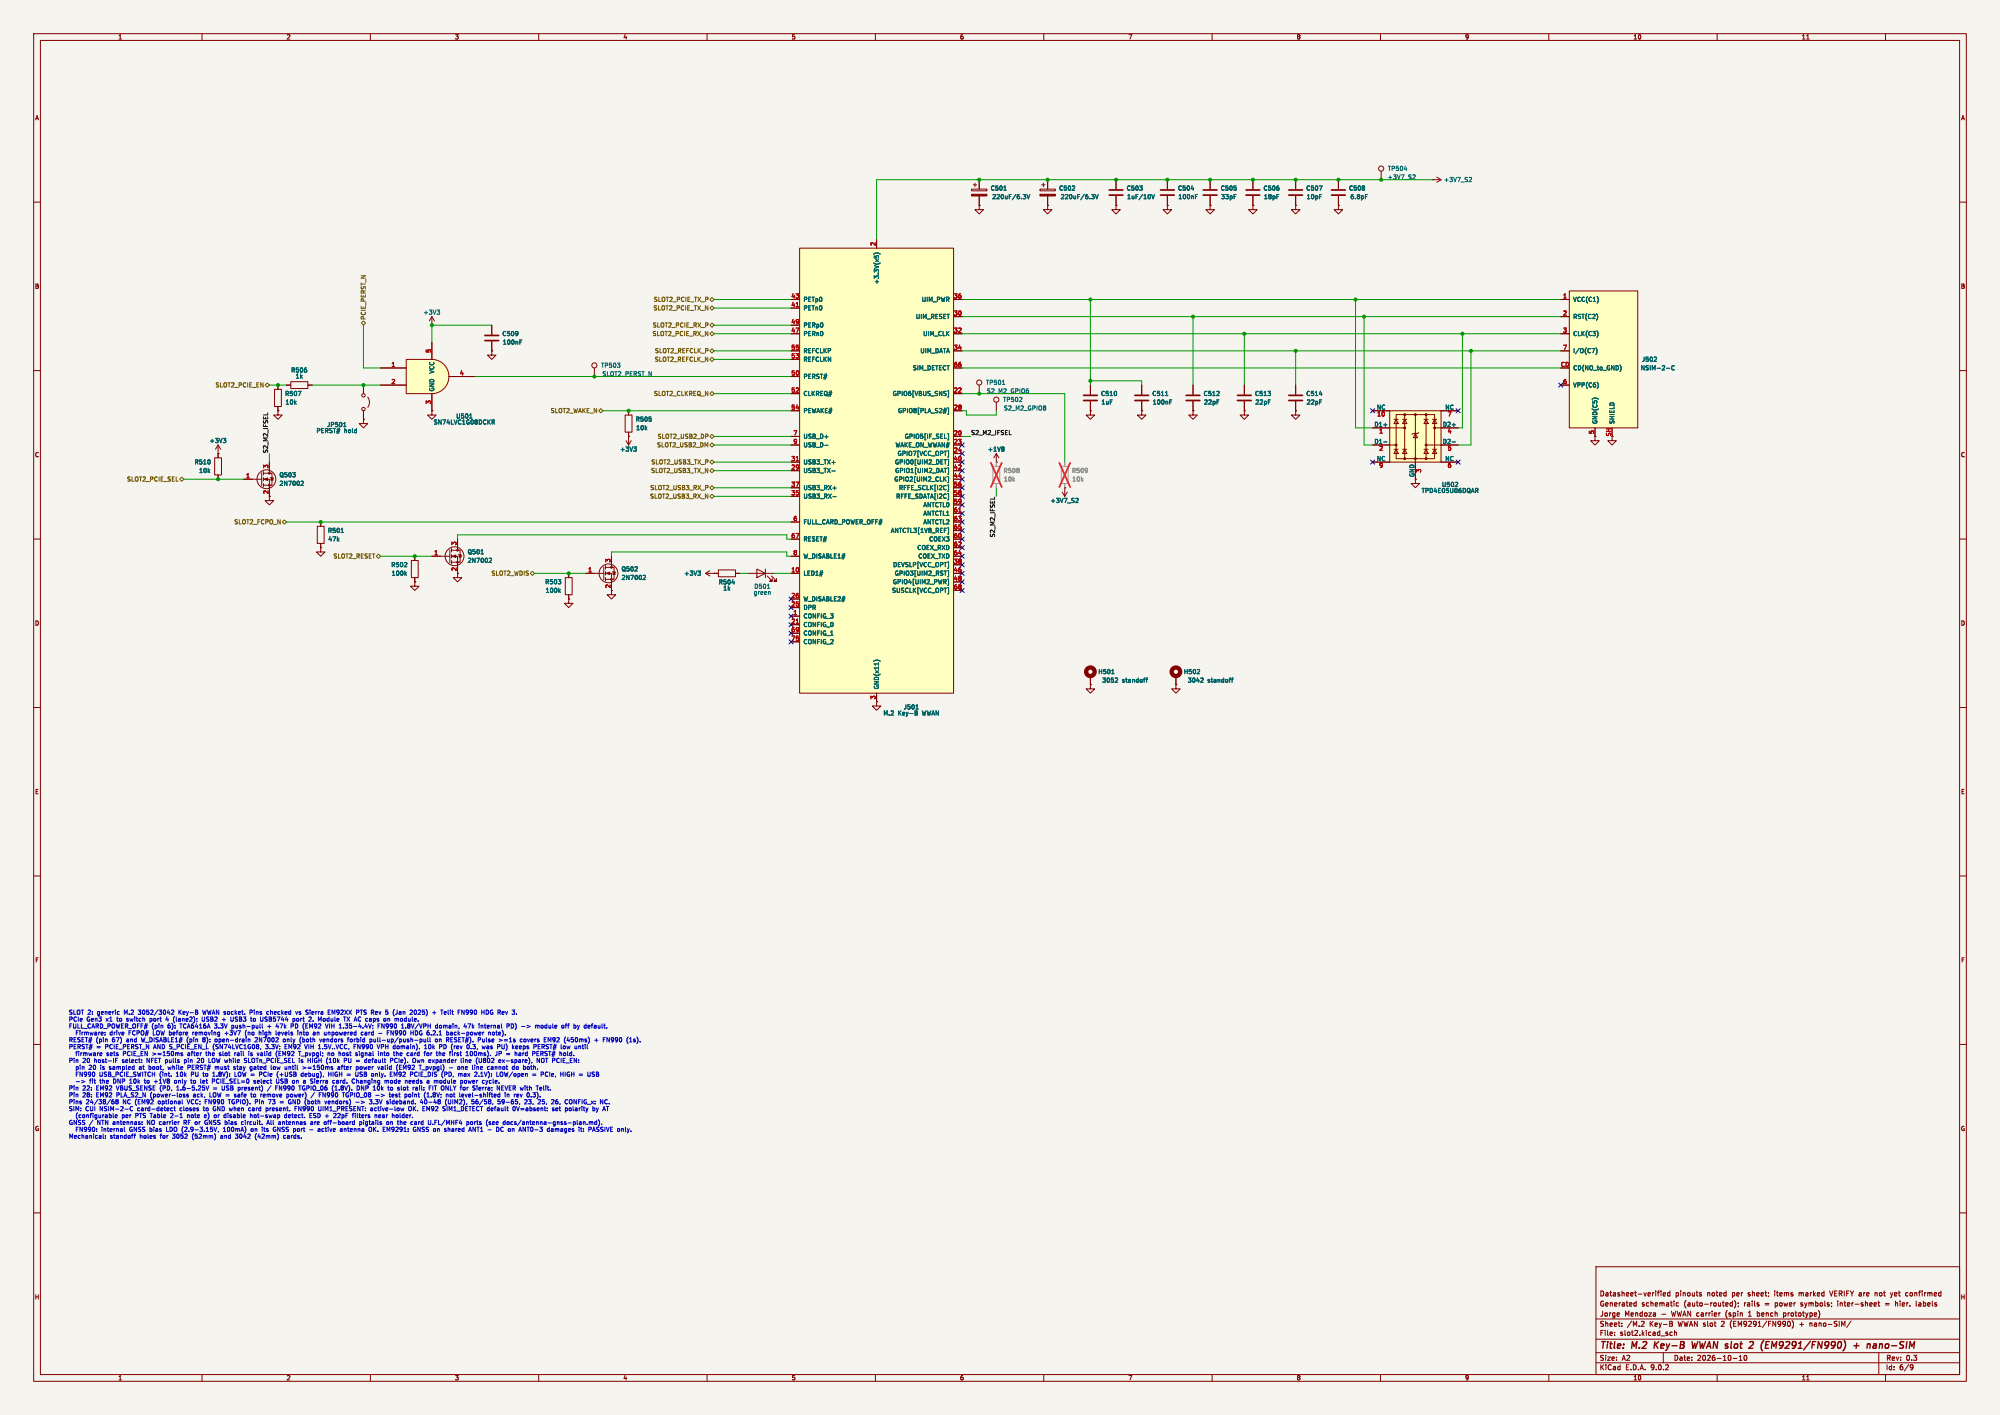
[picture p13: page 6]
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

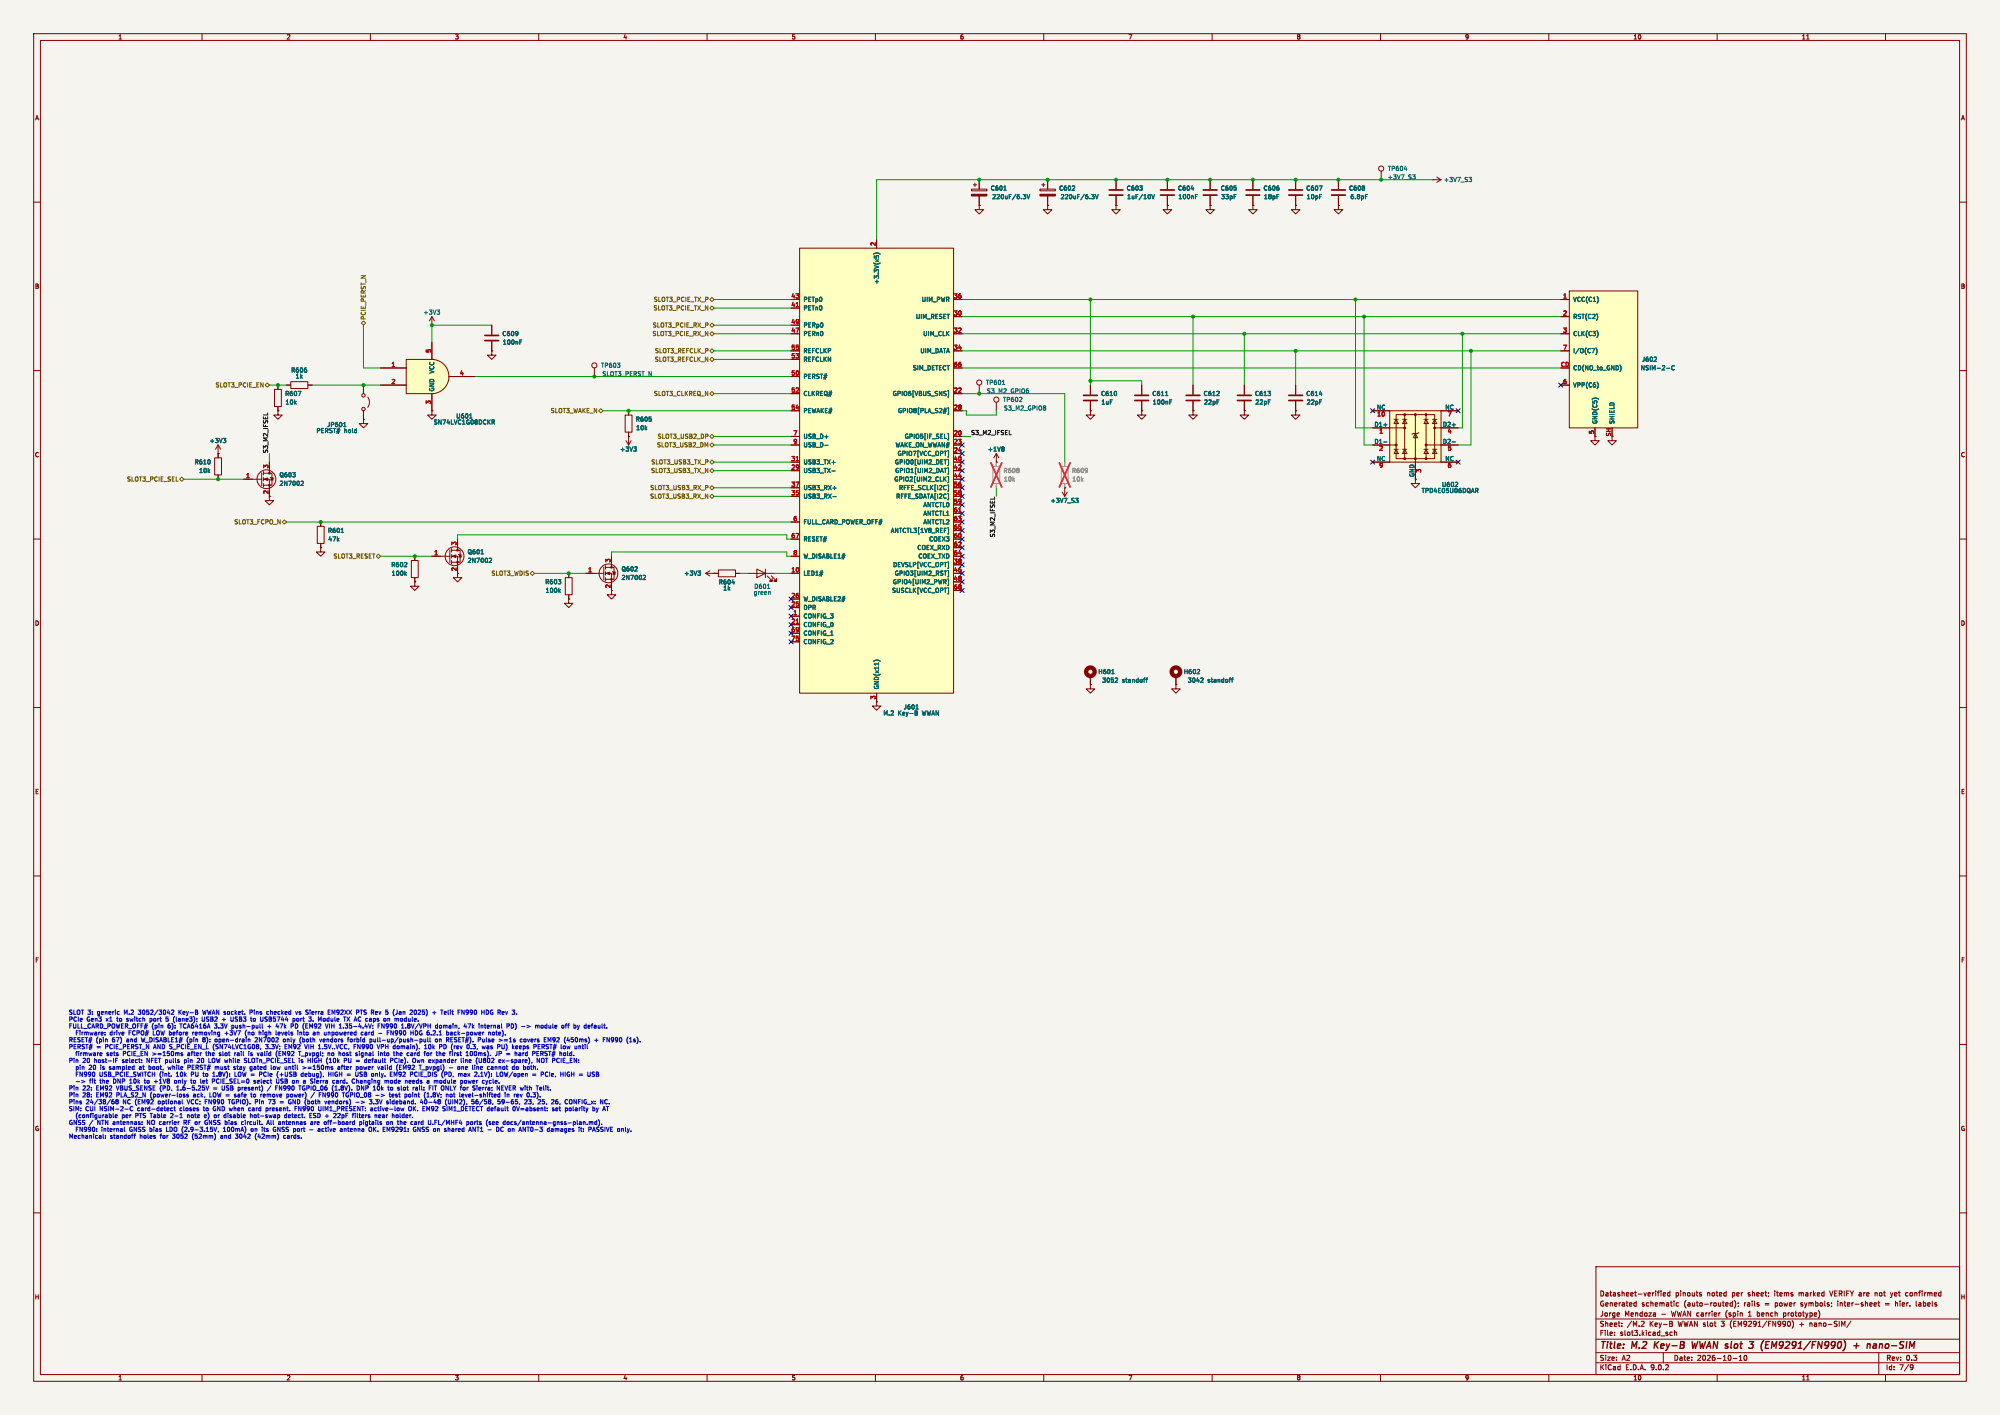
[picture p14: page 7]

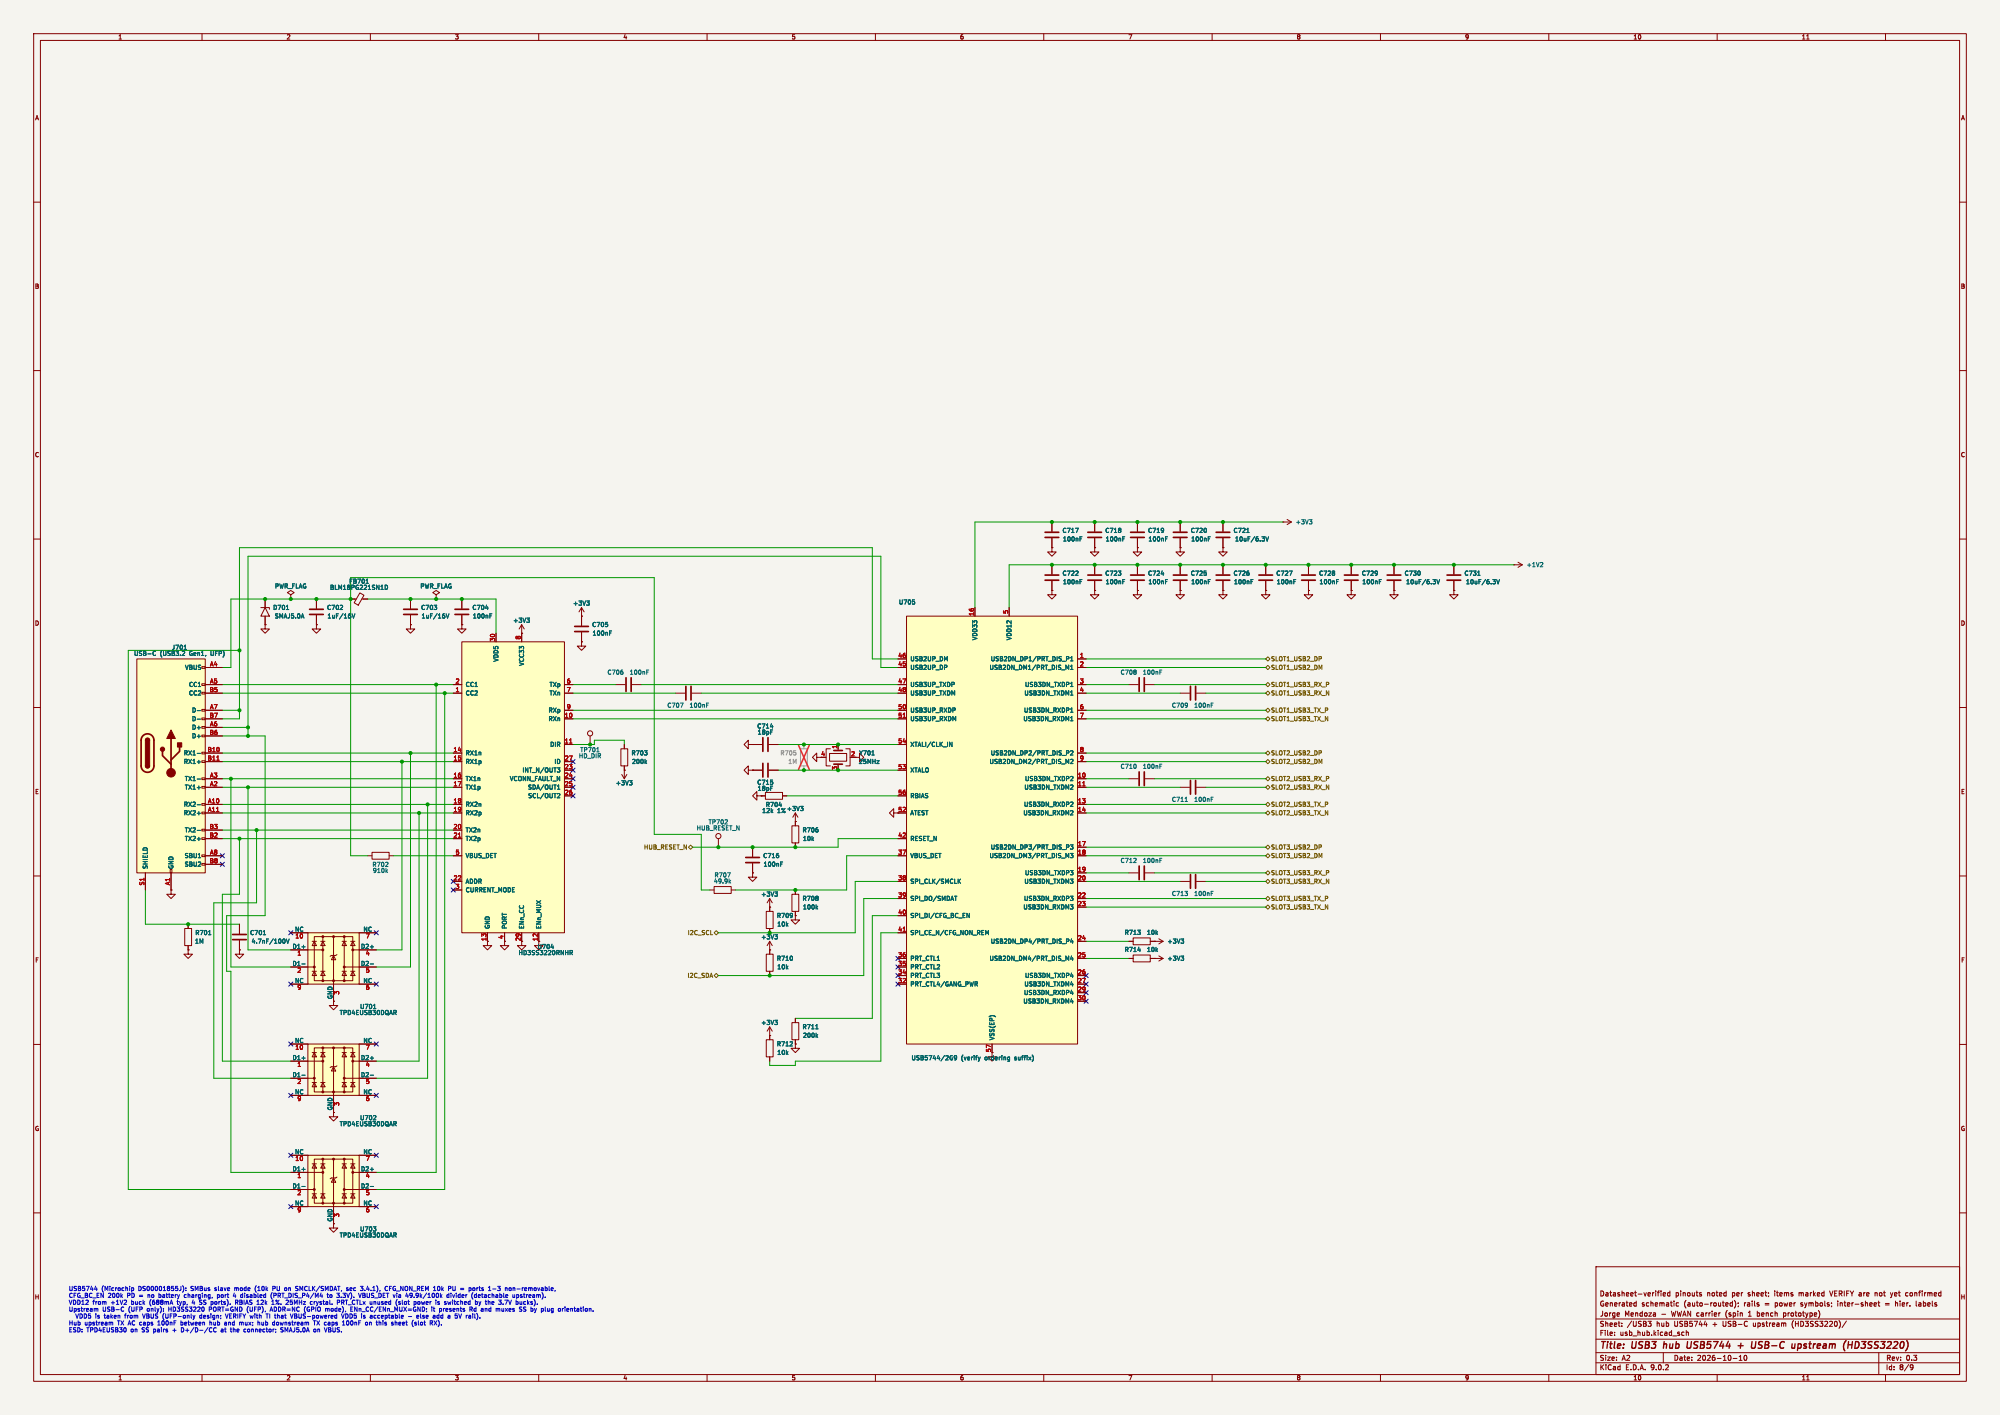
[picture p15: page 8]

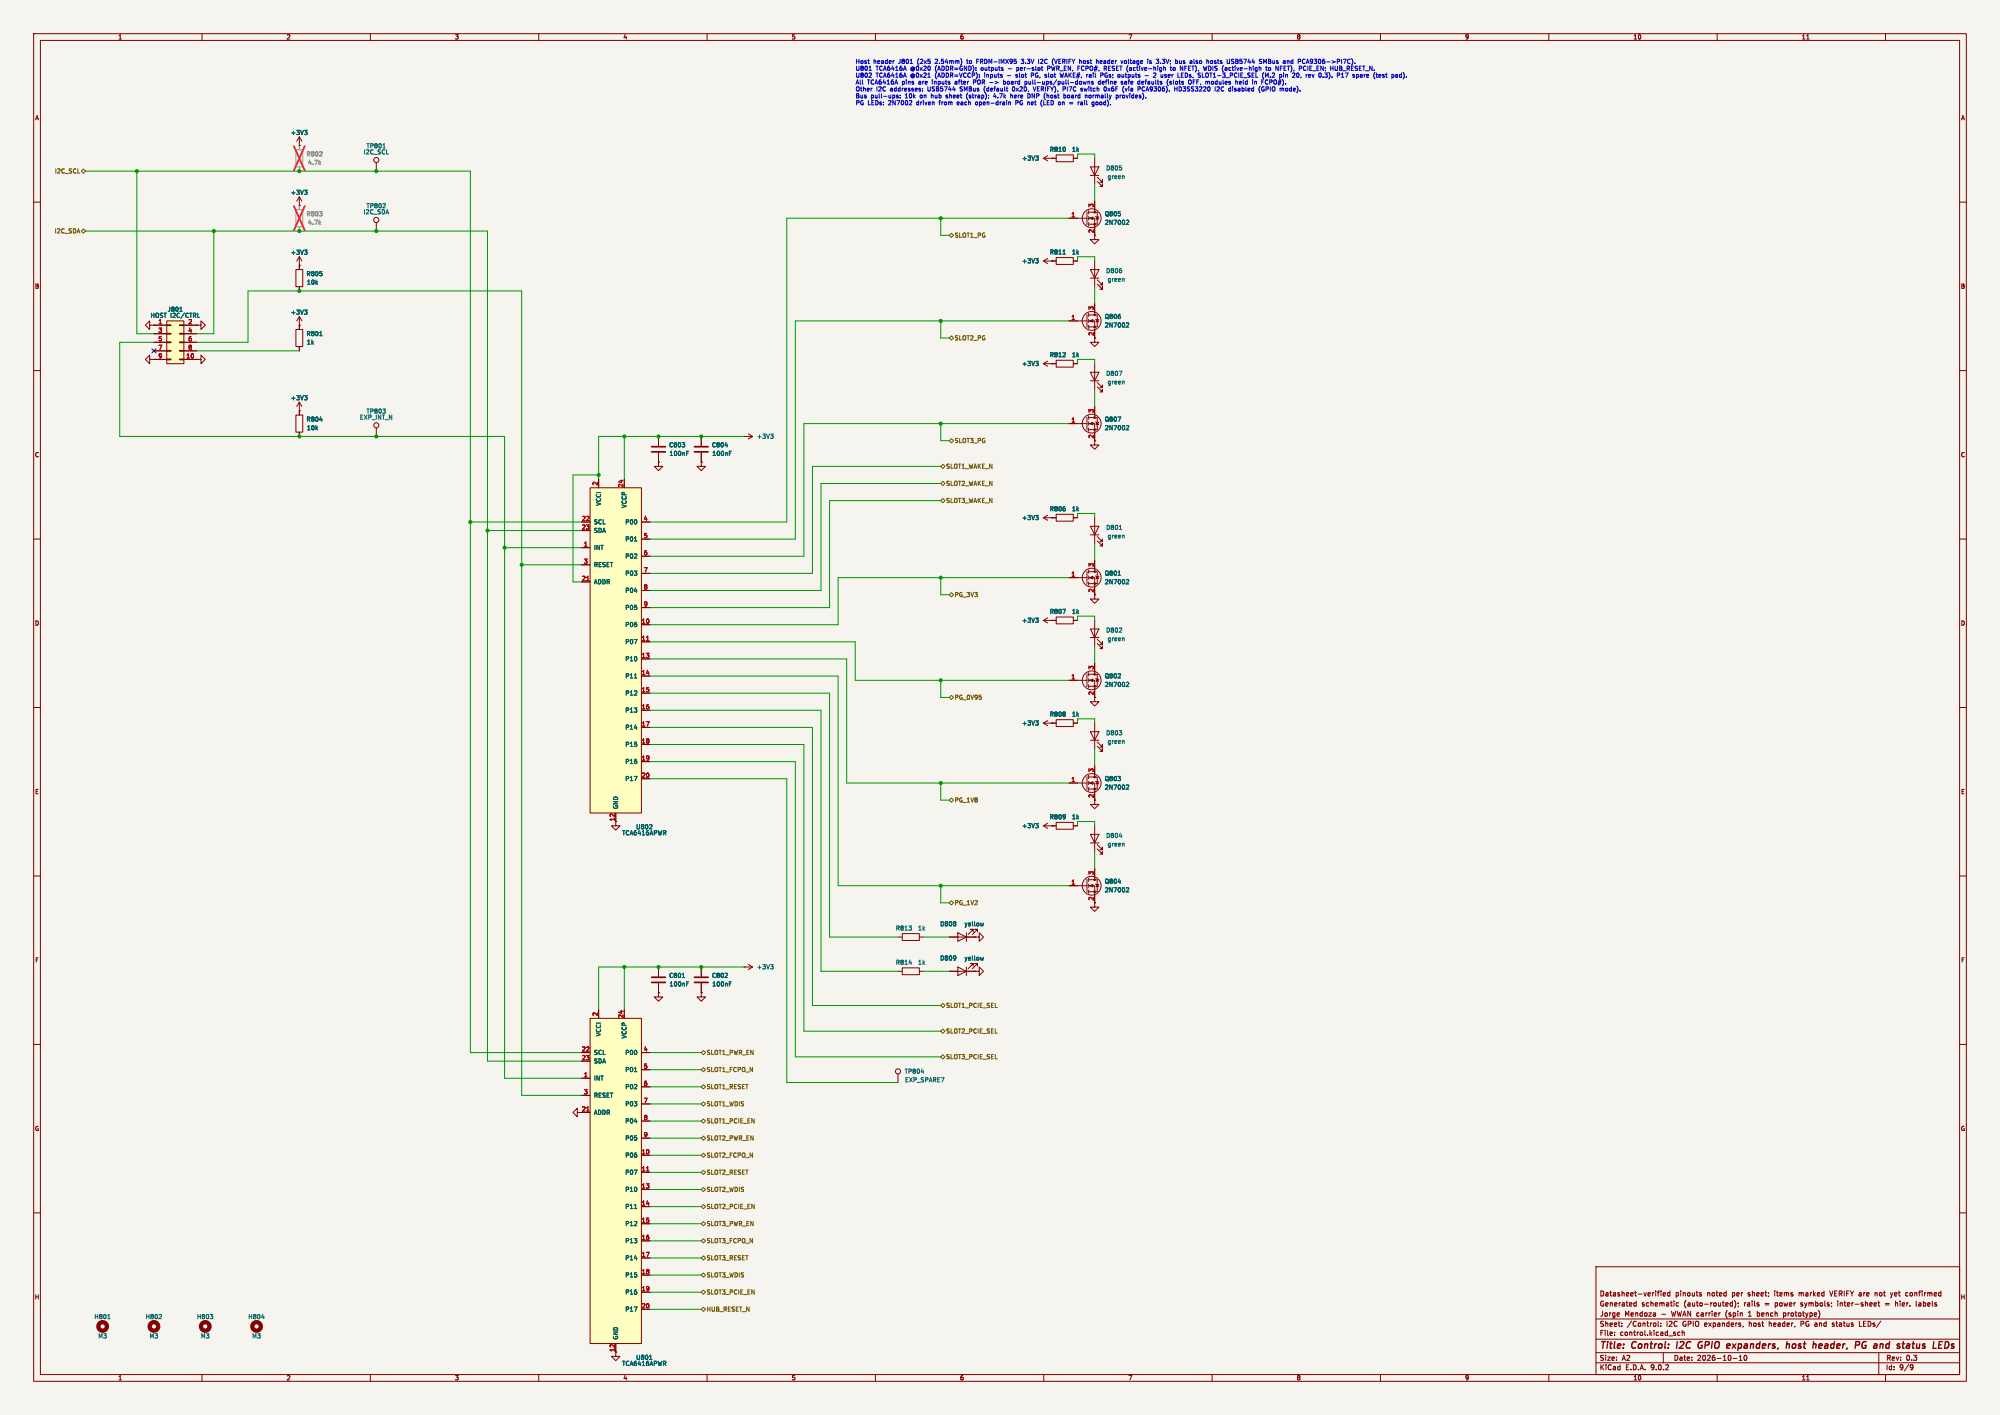
[picture p16: page 9]
