jmendoza-10/connectivity-module-public/hardware/kicad/control.kicad_sch

## KiCad design hardware/kicad/control.kicad_sch (2026-10-14)

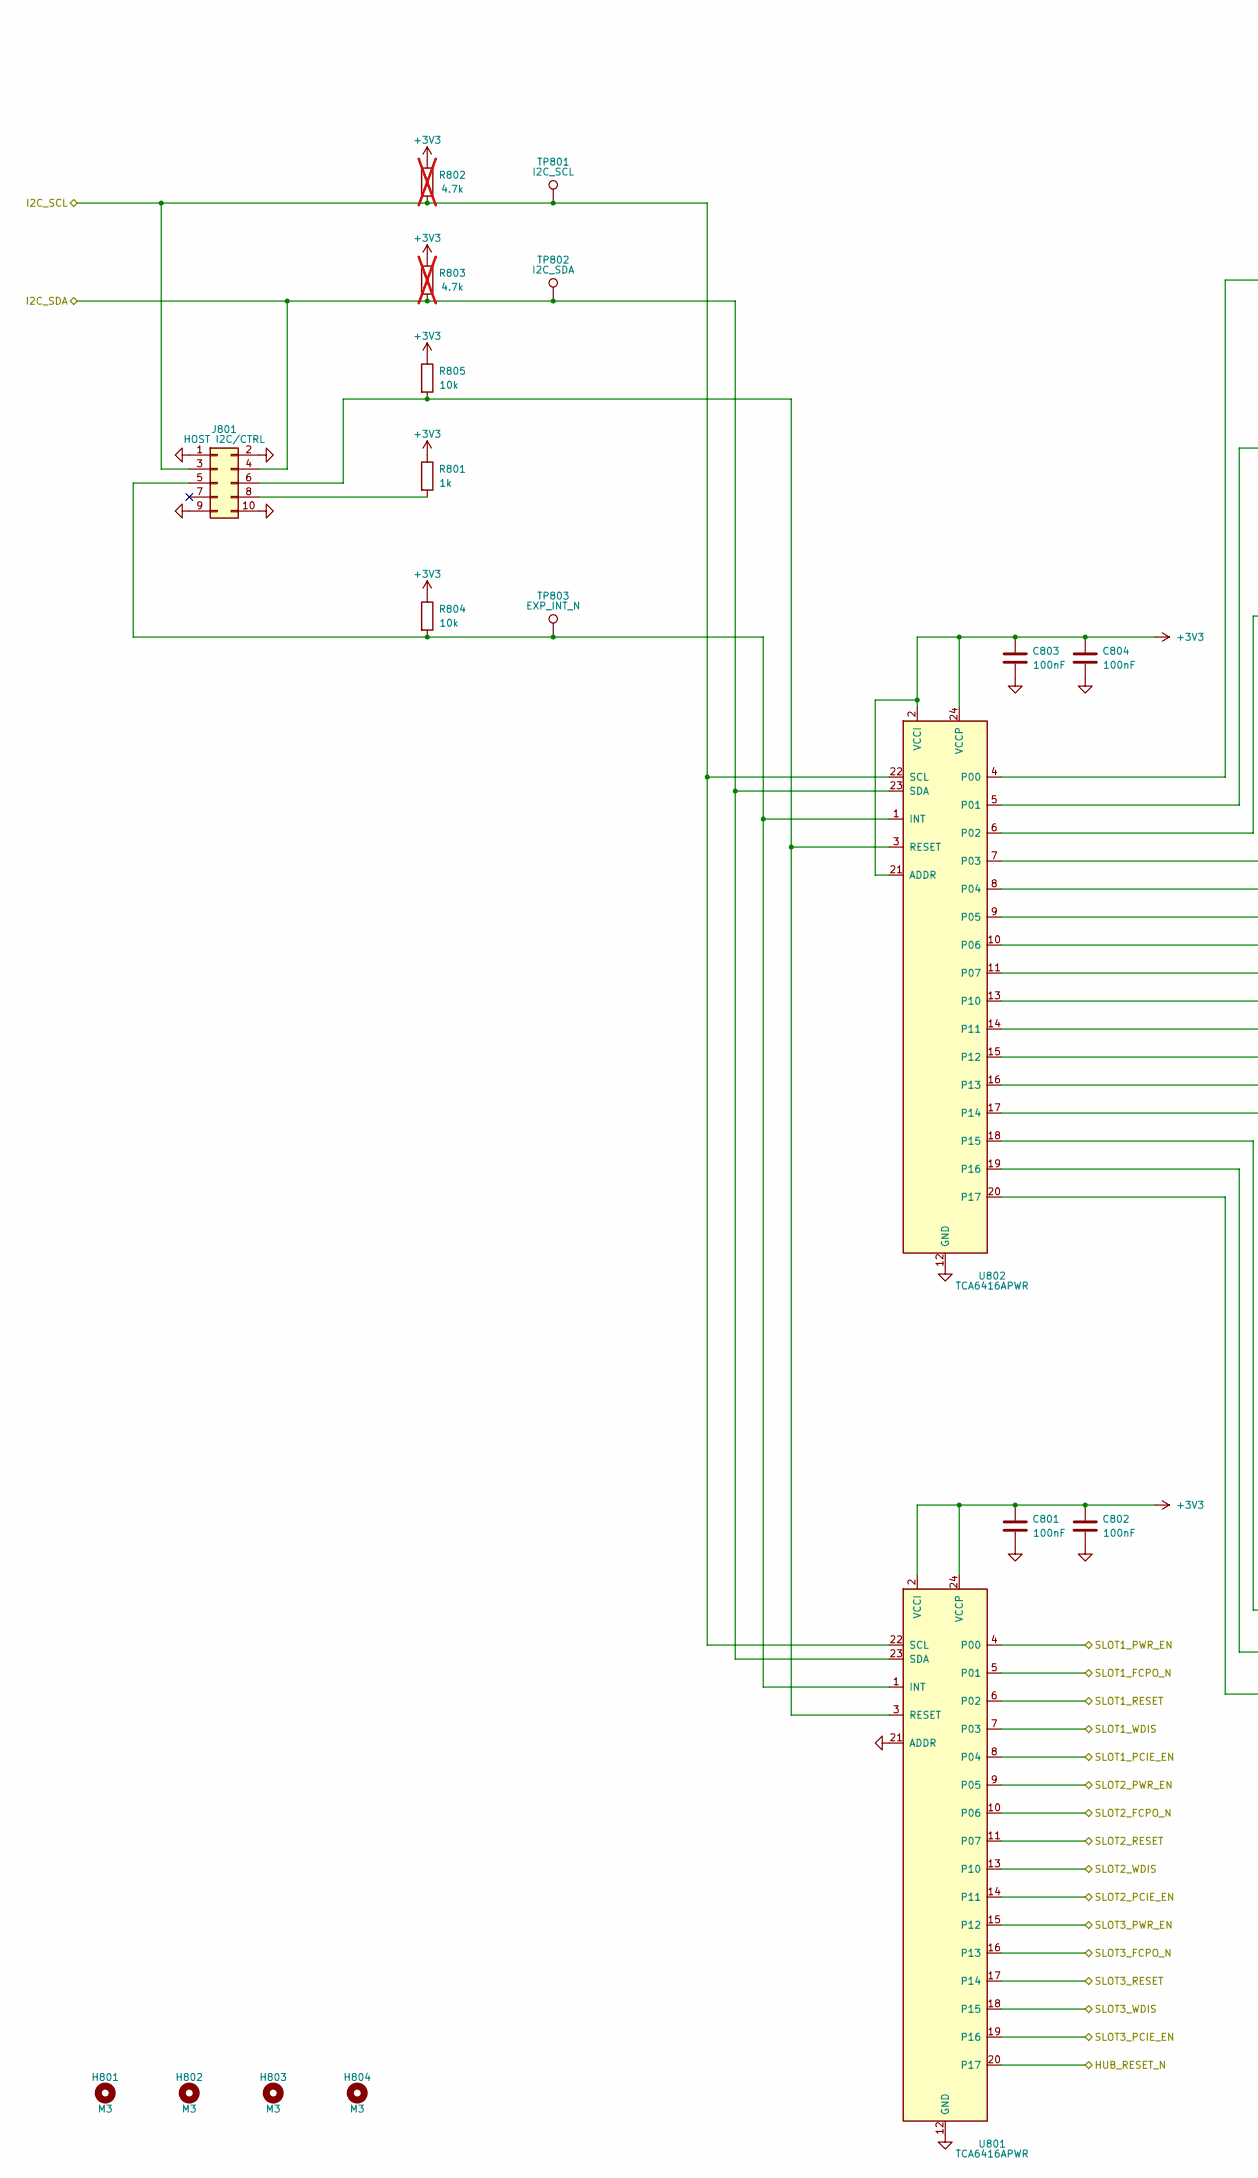
[picture p17: schematic control.kicad_sch, part in row 1, column 1]

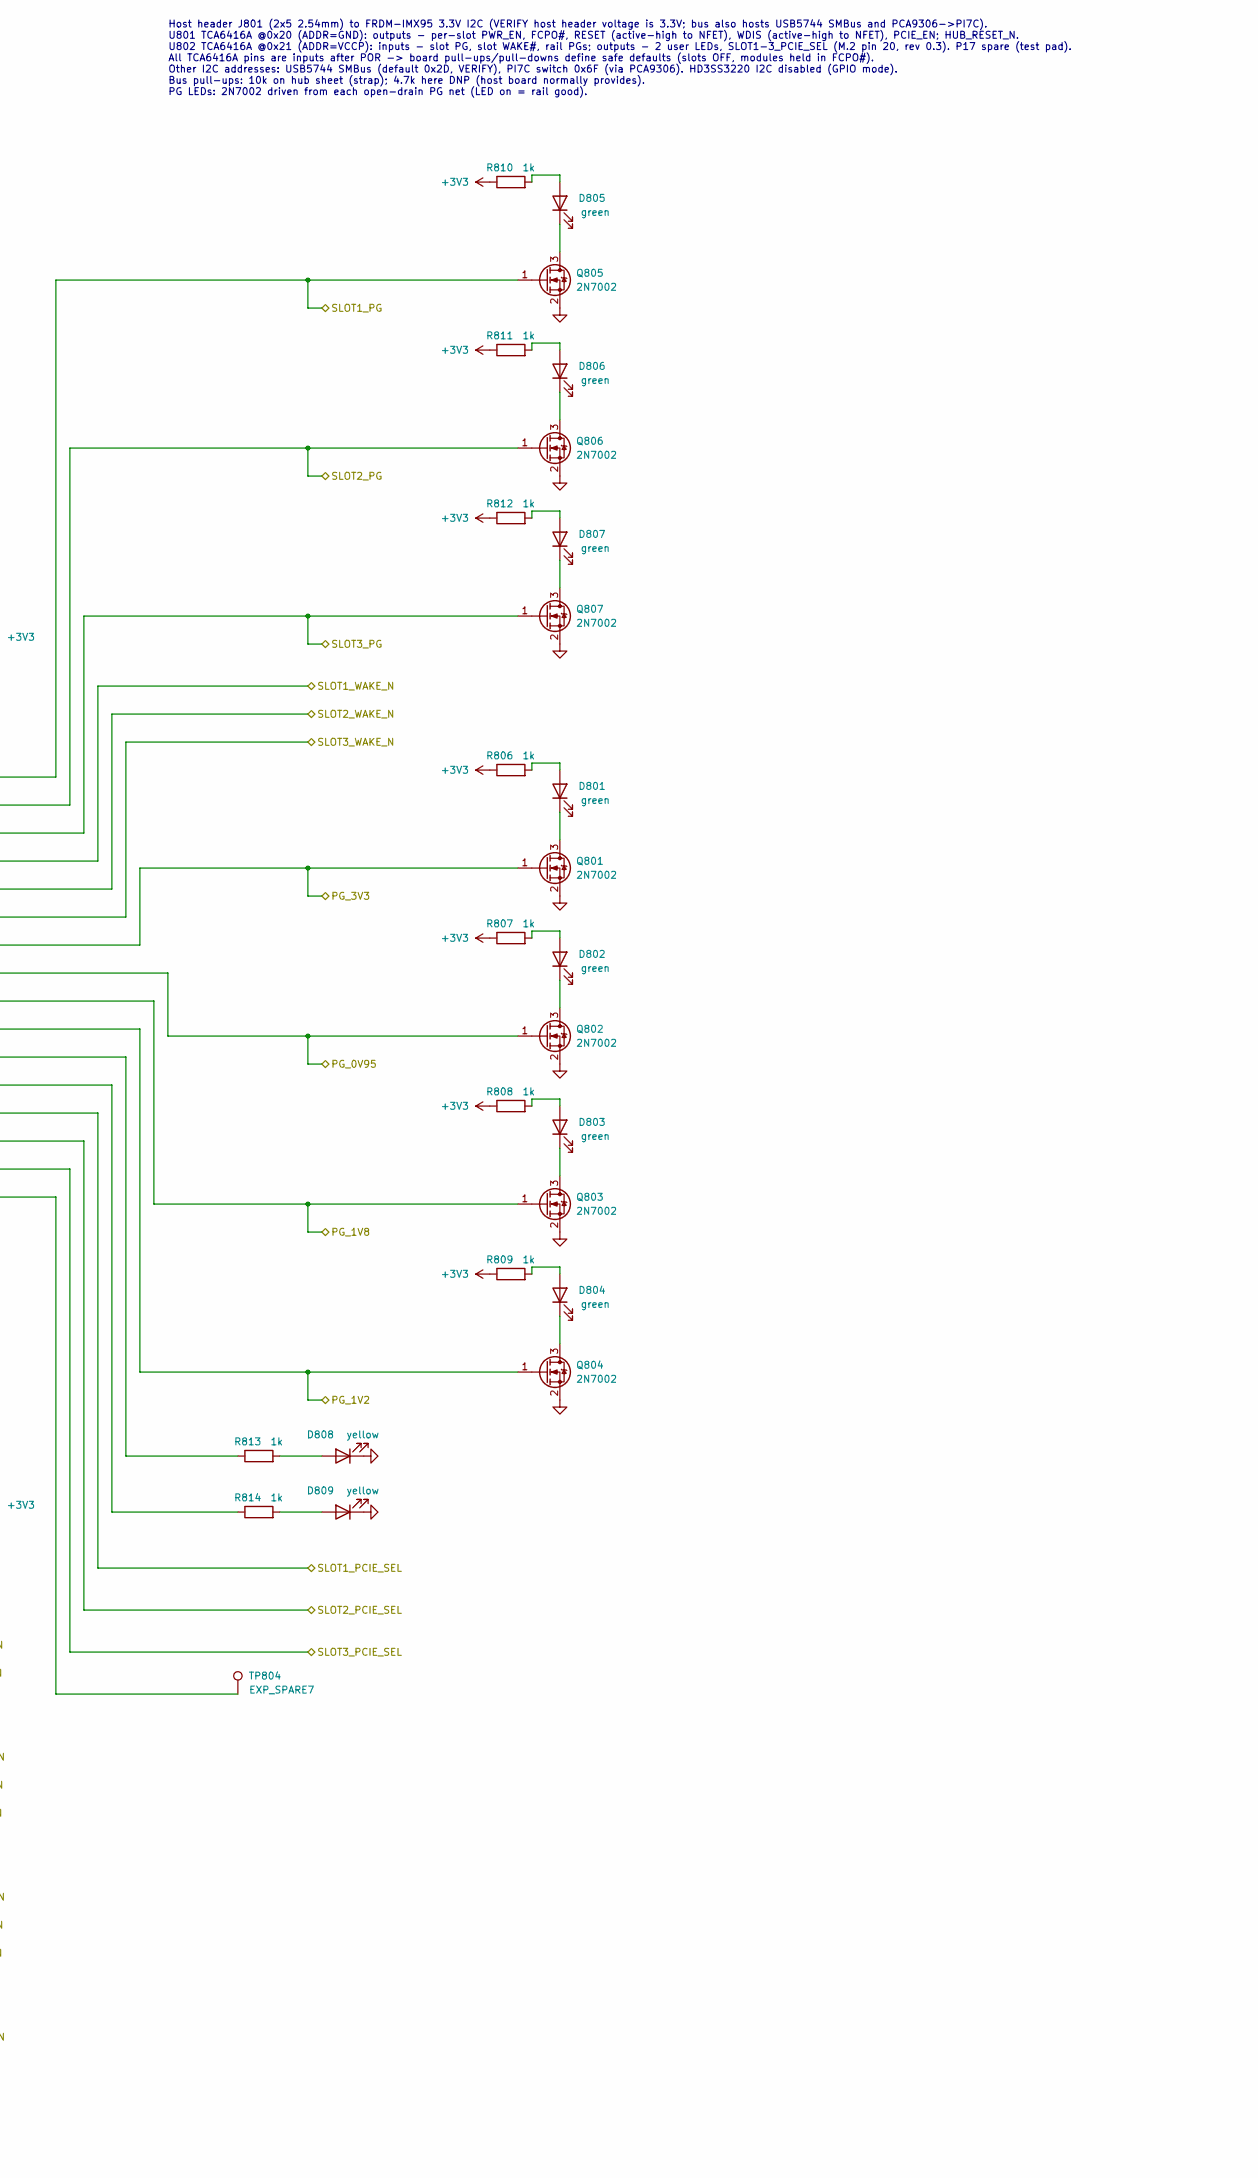
[picture p18: schematic control.kicad_sch, part in row 1, column 2]

Parts:
C801, C802, C803, C804: 100nF; C_0402_1005Metric; MPN Murata GRM/GCM, TDK C/CGA or KEMET (X7R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
D801, D802, D803, D804, D805, D806, D807: green; LED_0603_1608Metric; MPN Lite-On LTST-C191KGKT
D808, D809: yellow; LED_0603_1608Metric; MPN Lite-On LTST-C191KSKT
H801, H802, H803, H804: M3; MountingHole_3.2mm_M3; MPN M3 nylon/steel standoff (Wurth WA-SSTII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
J801: HOST I2C/CTRL; PinHeader_2x05_P2.54mm_Vertical; MPN Samtec TSW-105-07-G-D (or Wurth 6130102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
Q801, Q802, Q803, Q804, Q805, Q806, Q807: 2N7002; SOT-23; MPN Diodes Inc. 2N7002-7-F (AEC-Q101: onsem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
R801, R806, R807, R808, R809, R810, R811, R812, R813, R814: 1k; R_0402_1005Metric; MPN Yageo RC0402FR-071KL (alt Panasonic ERJ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
R802, R803: 4.7k; R_0402_1005Metric; MPN Yageo RC0402FR-074K7L (alt Panasonic ER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; not fitted
R804, R805: 10k; R_0402_1005Metric; MPN Yageo RC0402FR-0710KL (alt Panasonic ER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
TP801: I2C_SCL; TestPoint_Pad_D1.0mm
TP802: I2C_SDA; TestPoint_Pad_D1.0mm
TP803: EXP_INT_N; TestPoint_Pad_D1.0mm
TP804: EXP_SPARE7; TestPoint_Pad_D1.0mm
U801, U802: TCA6416APWR; TSSOP-24_4.4x7.8mm_P0.65mm; MPN TCA6416APWR (TCA6416ATPWRQ1 = AEC optio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

Connections:
+3V3: C801.1, C802.1, C803.1, C804.1, R801.1, R802.1, R803.1, R804.1, R805.1, R806.1, R807.1, R808.1, R809.1, R810.1, R811.1, R812.1, U801.2 (VCCI), U801.24 (VCCP), U802.2 (VCCI), U802.21 (ADDR), U802.24 (VCCP)
GND: C801.2, C802.2, C803.2, C804.2, D808.1 (K), D809.1 (K), J801.1, J801.2, J801.9, J801.10, Q801.2 (S), Q802.2 (S), Q803.2 (S), Q804.2 (S), Q805.2 (S), Q806.2 (S), Q807.2 (S), U801.12 (GND), U801.21 (ADDR), U802.12 (GND)
HUB_RESET_N: U801.20 (P17)
I2C_SCL: J801.3, R802.2, TP801.1, U801.22 (SCL), U802.22 (SCL)
I2C_SDA: J801.4, R803.2, TP802.1, U801.23 (SDA), U802.23 (SDA)
unnamed: D801.1 (K), Q801.3 (D)
unnamed: D801.2 (A), R806.2
unnamed: D802.1 (K), Q802.3 (D)
unnamed: D802.2 (A), R807.2
unnamed: D803.1 (K), Q803.3 (D)
unnamed: D803.2 (A), R808.2
unnamed: D804.1 (K), Q804.3 (D)
unnamed: D804.2 (A), R809.2
unnamed: D805.1 (K), Q805.3 (D)
unnamed: D805.2 (A), R810.2
unnamed: D806.1 (K), Q806.3 (D)
unnamed: D806.2 (A), R811.2
unnamed: D807.1 (K), Q807.3 (D)
unnamed: D807.2 (A), R812.2
unnamed: D808.2 (A), R813.2
unnamed: D809.2 (A), R814.2
unnamed: J801.5, R804.2, TP803.1, U801.1 (INT), U802.1 (INT)
unnamed: J801.6, R805.2, U801.3 (RESET), U802.3 (RESET)
unnamed: J801.8, R801.2
unnamed: R813.1, U802.15 (P12)
unnamed: R814.1, U802.16 (P13)
unnamed: TP804.1, U802.20 (P17)
PG_0V95: Q802.1 (G), U802.11 (P07)
PG_1V2: Q804.1 (G), U802.14 (P11)
PG_1V8: Q803.1 (G), U802.13 (P10)
PG_3V3: Q801.1 (G), U802.10 (P06)
SLOT1_FCPO_N: U801.5 (P01)
SLOT1_PCIE_EN: U801.8 (P04)
SLOT1_PCIE_SEL: U802.17 (P14)
SLOT1_PG: Q805.1 (G), U802.4 (P00)
SLOT1_PWR_EN: U801.4 (P00)
SLOT1_RESET: U801.6 (P02)
SLOT1_WAKE_N: U802.7 (P03)
SLOT1_WDIS: U801.7 (P03)
SLOT2_FCPO_N: U801.10 (P06)
SLOT2_PCIE_EN: U801.14 (P11)
SLOT2_PCIE_SEL: U802.18 (P15)
SLOT2_PG: Q806.1 (G), U802.5 (P01)
SLOT2_PWR_EN: U801.9 (P05)
SLOT2_RESET: U801.11 (P07)
SLOT2_WAKE_N: U802.8 (P04)
SLOT2_WDIS: U801.13 (P10)
SLOT3_FCPO_N: U801.16 (P13)
SLOT3_PCIE_EN: U801.19 (P16)
SLOT3_PCIE_SEL: U802.19 (P16)
SLOT3_PG: Q807.1 (G), U802.6 (P02)
SLOT3_PWR_EN: U801.15 (P12)
SLOT3_RESET: U801.17 (P14)
SLOT3_WAKE_N: U802.9 (P05)
SLOT3_WDIS: U801.18 (P15)

Notes on the sheet:
Host header J801 (2x5 2.54mm) to FRDM-IMX95 3.3V I2C (VERIFY host header voltage is 3.3V; bus also hosts USB5744 SMBus and PCA9306->PI7C). U801 TCA6416A @0x20 (ADDR=GND): outputs - per-slot PWR_EN, FCPO#, RESET (active-high to NFET), WDIS (active-high to NFET), PCIE_EN; HUB_RESET_N. U802 TCA6416A @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
