jmendoza-10/connectivity-module-public/hardware/kicad/pcie_switch.kicad_sch

## KiCad design hardware/kicad/pcie_switch.kicad_sch (2026-10-14)

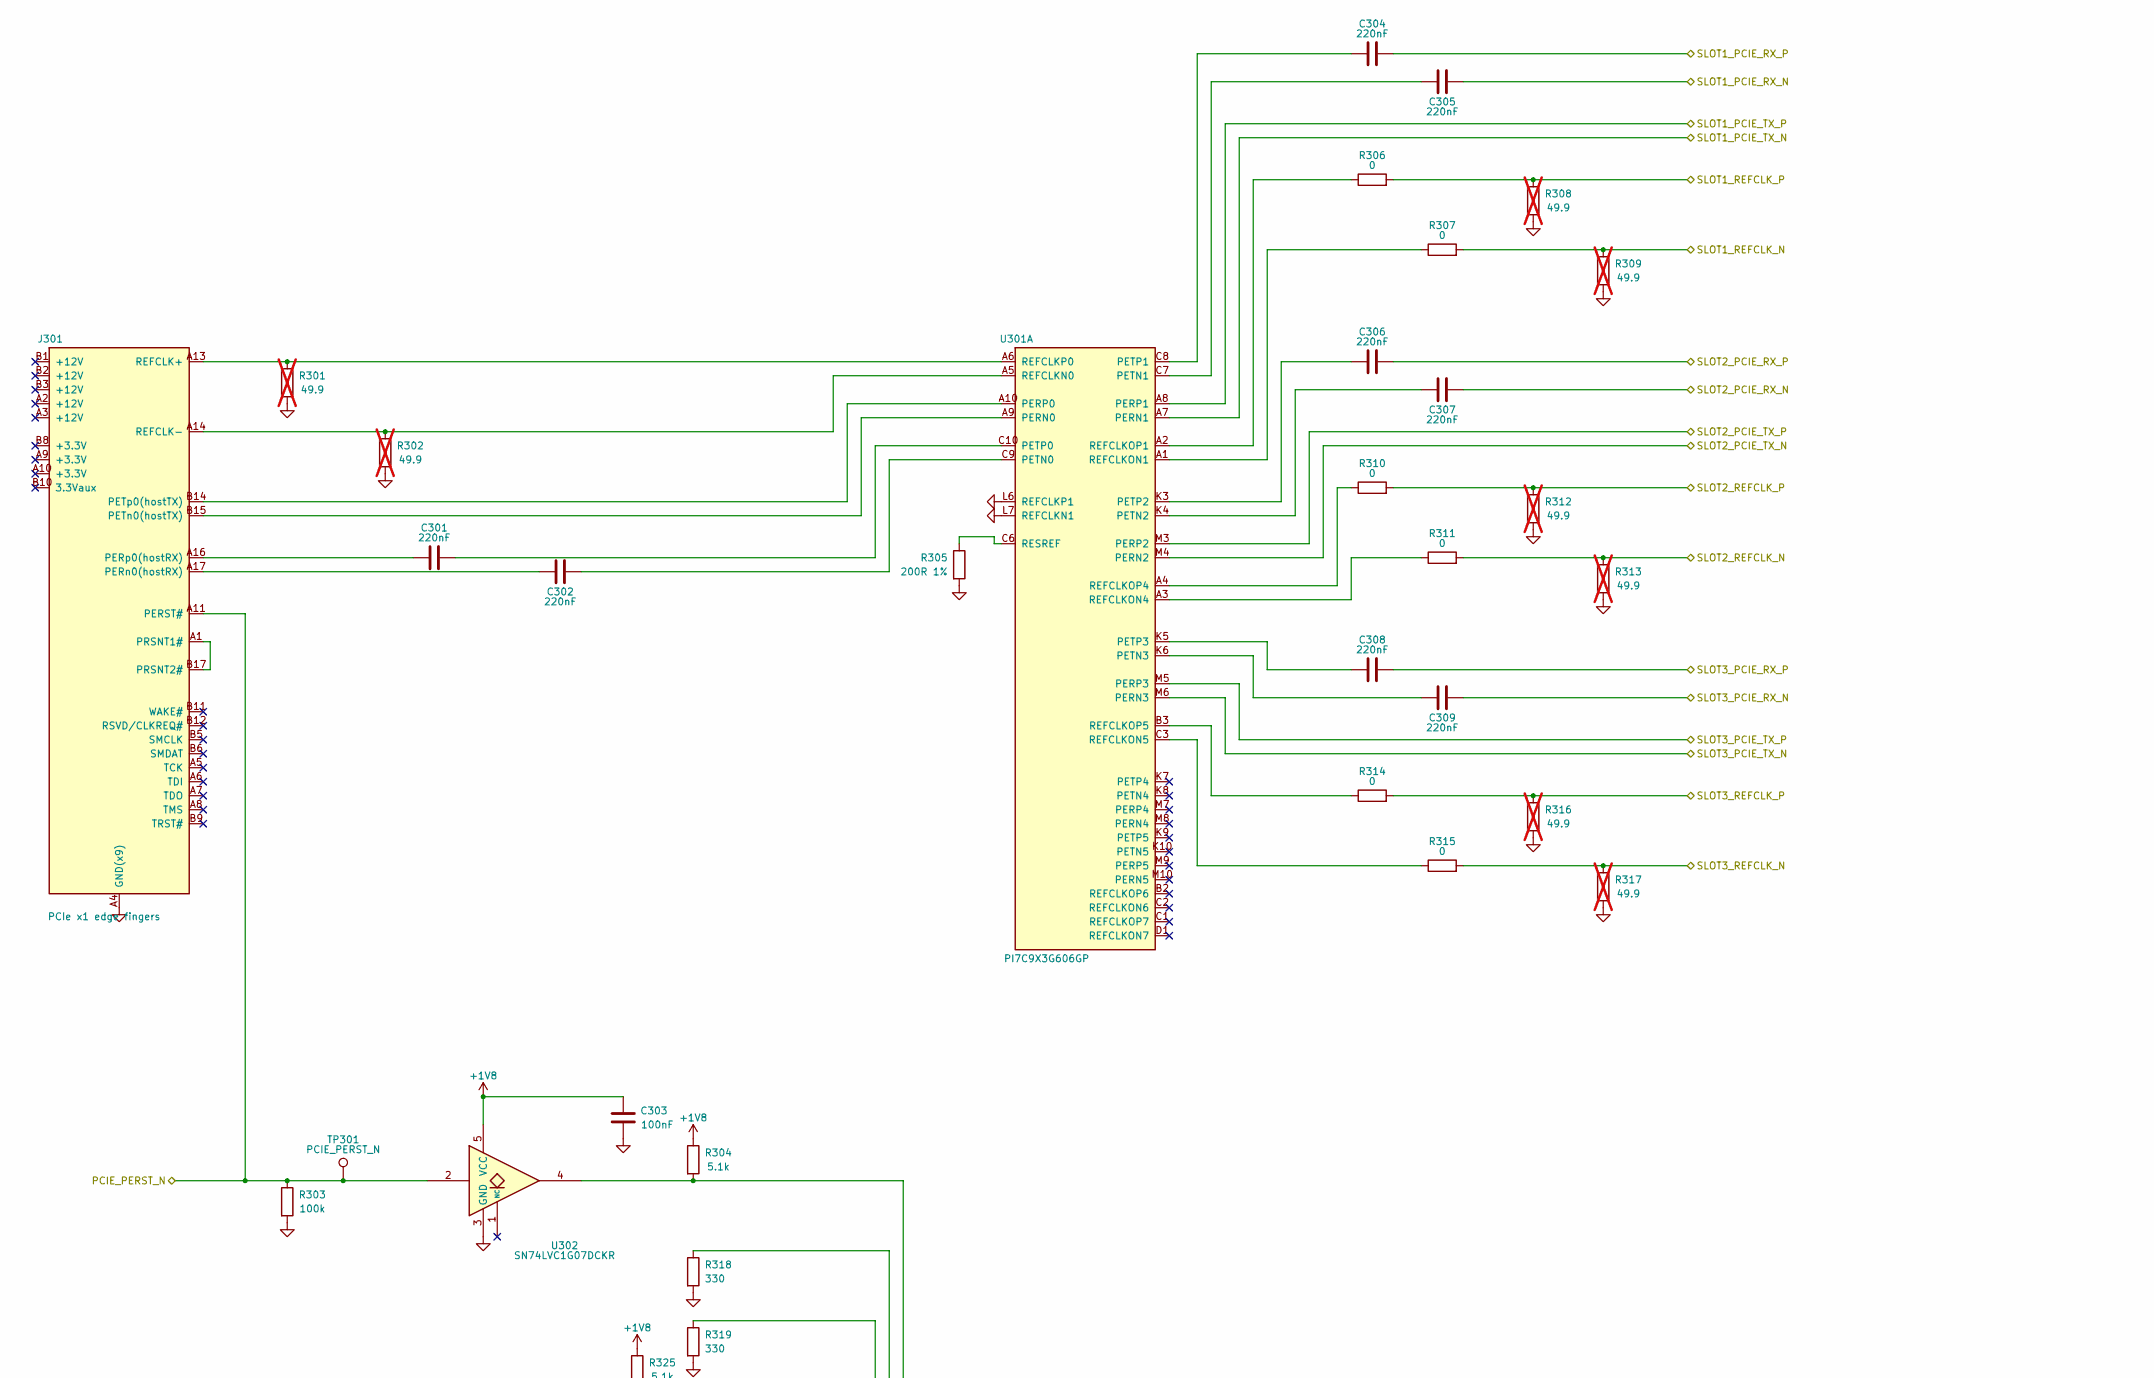
[picture p19: schematic pcie_switch.kicad_sch, part in row 1, column 1]

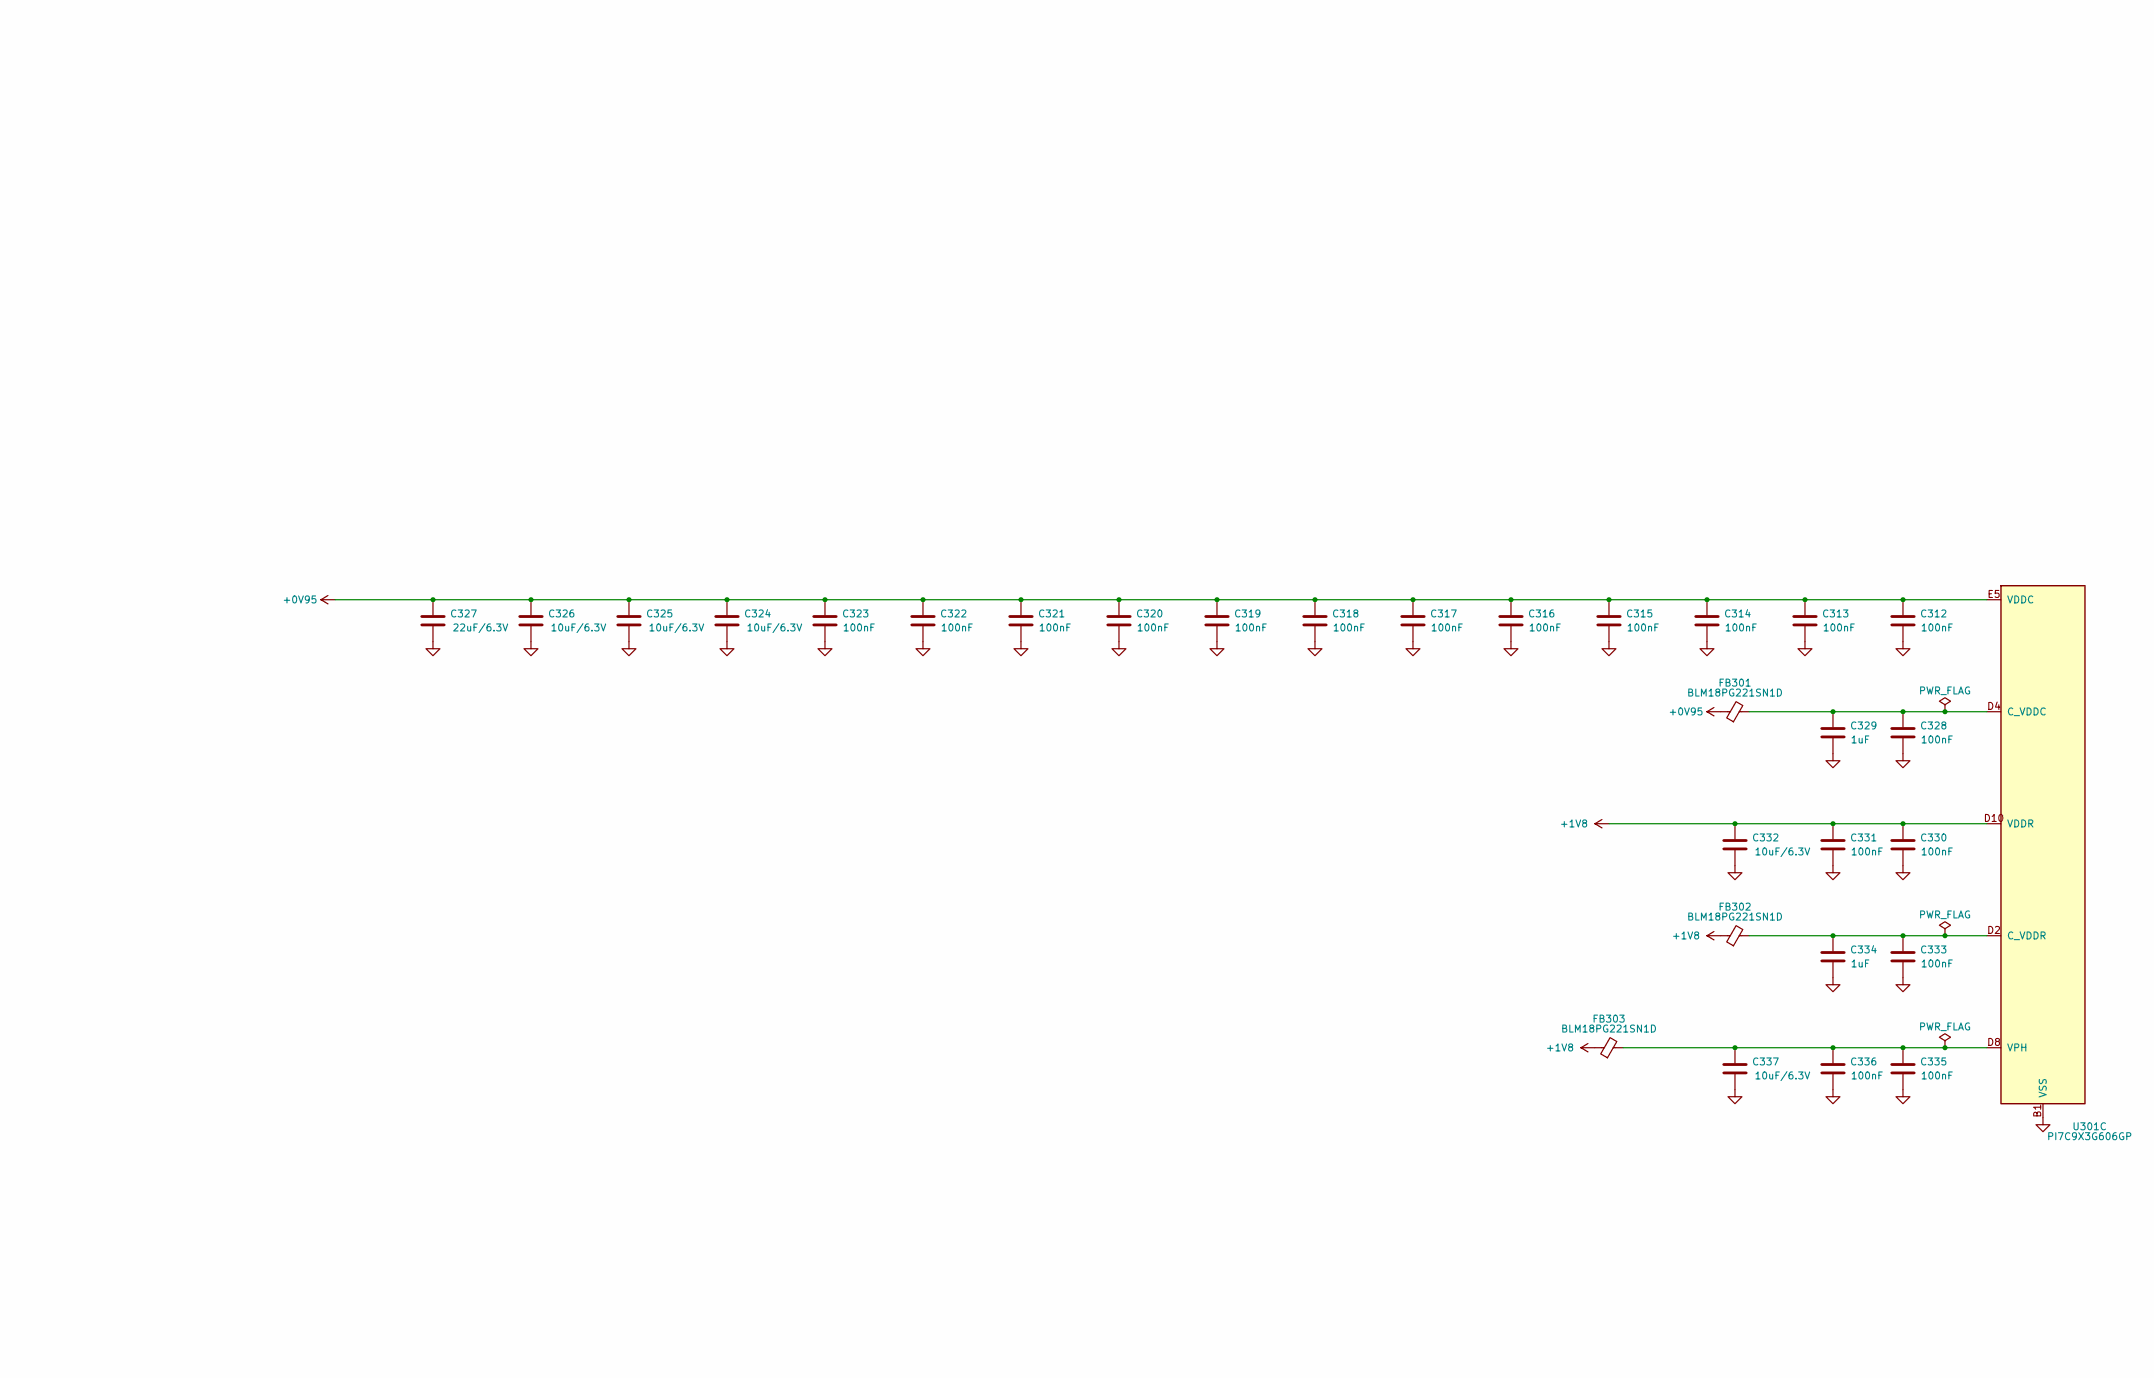
[picture p20: schematic pcie_switch.kicad_sch, part in row 1, column 2]

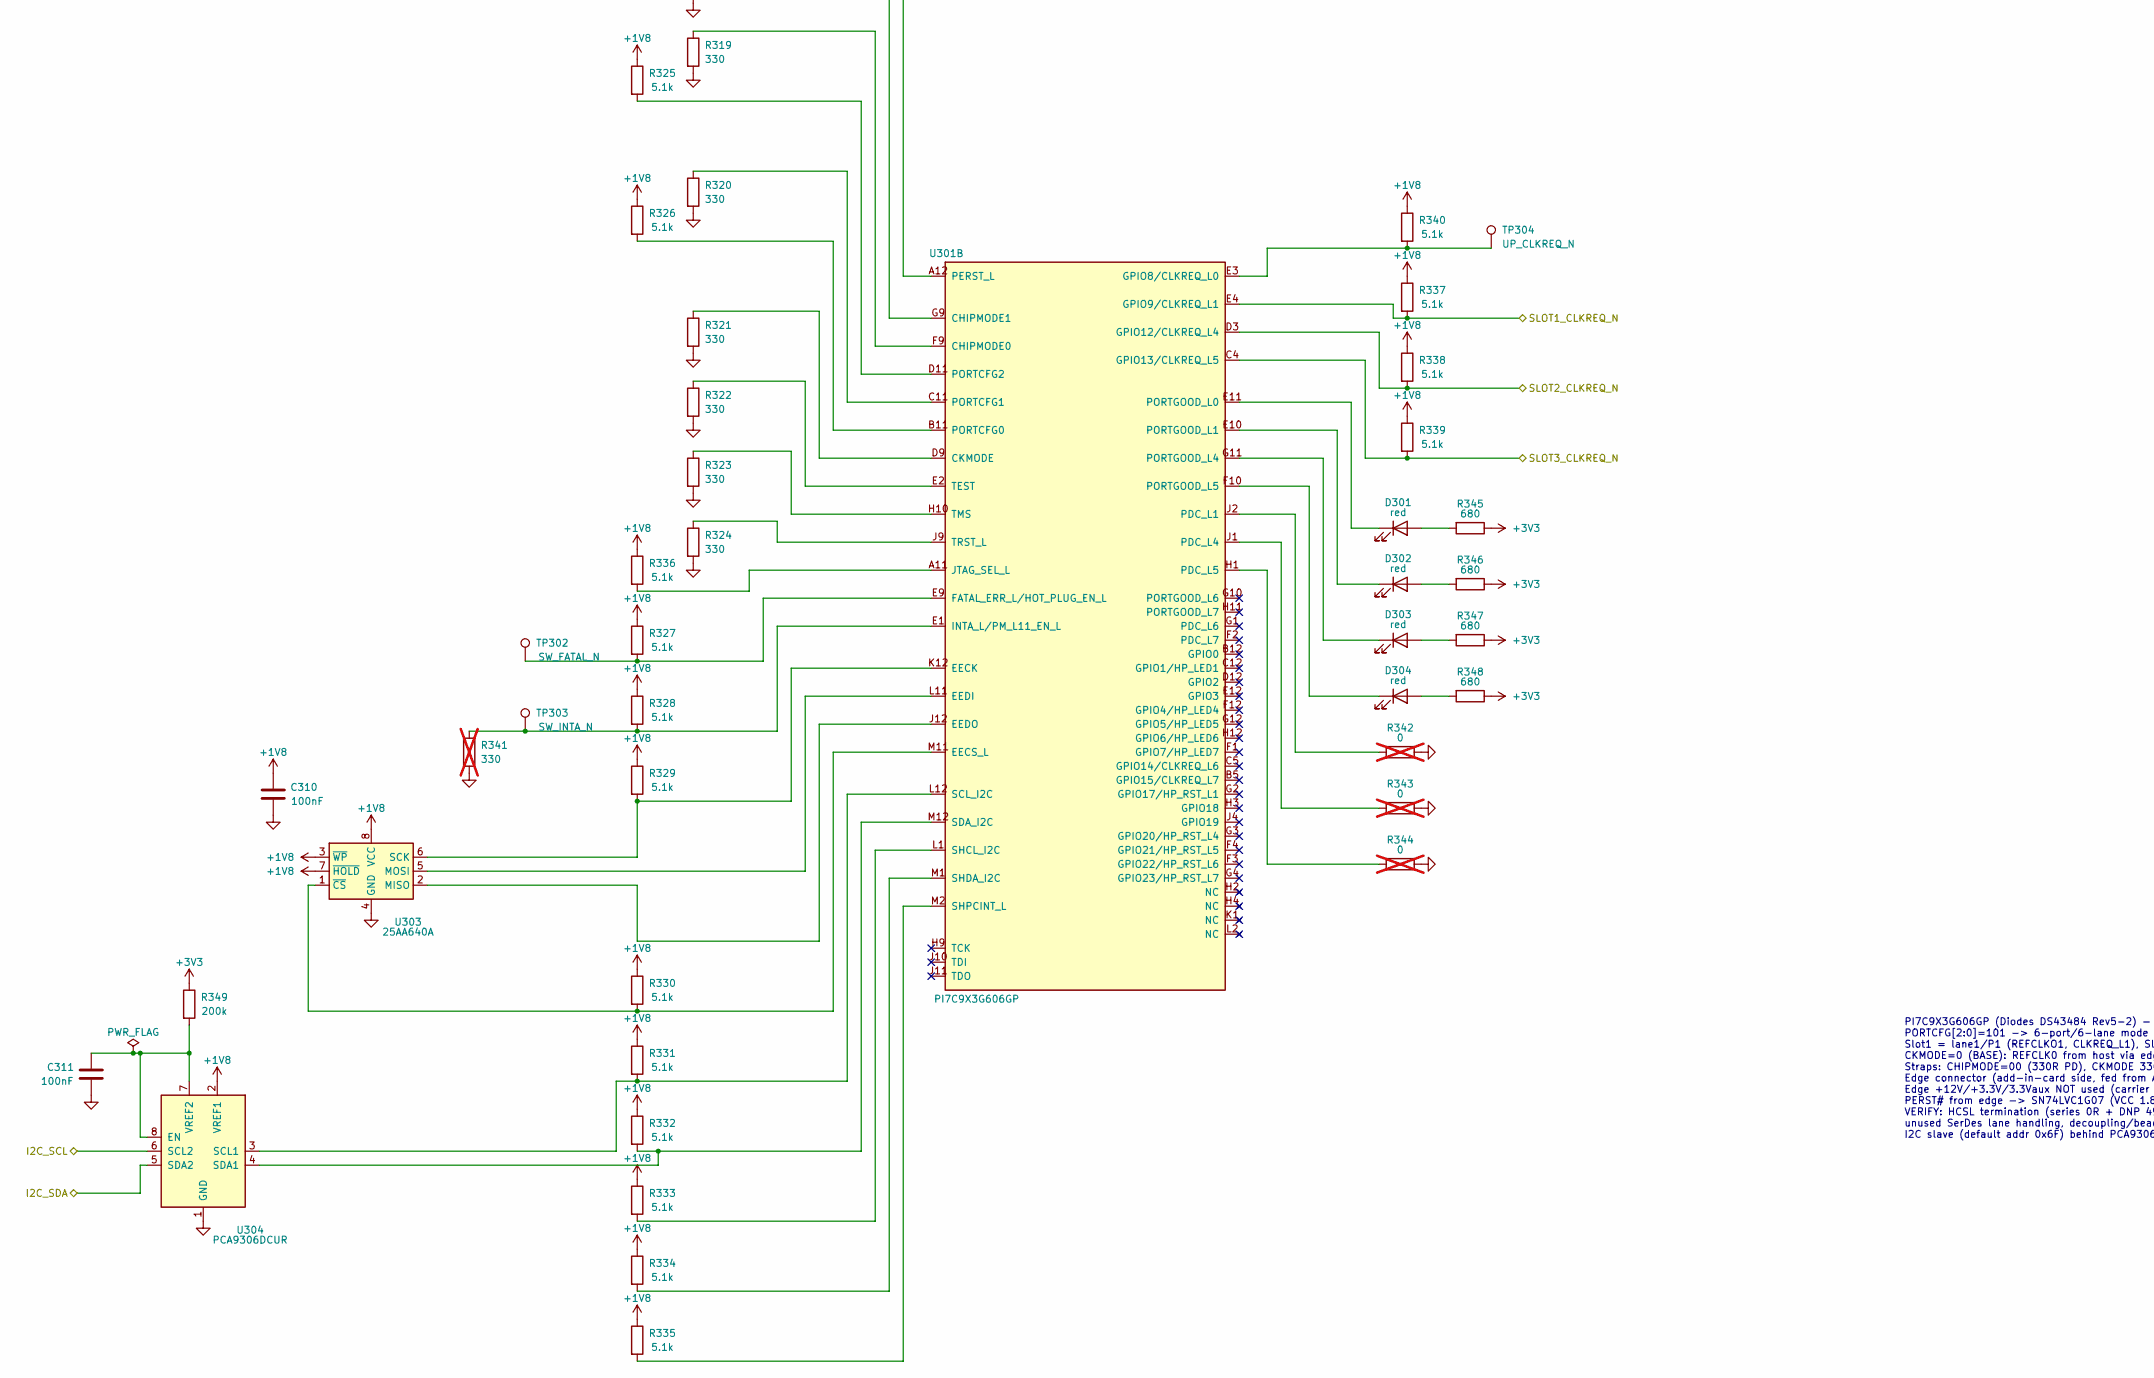
[picture p21: schematic pcie_switch.kicad_sch, part in row 2, column 1]

Parts:
C301, C302, C304, C305, C306, C307, C308, C309: 220nF; C_0201_0603Metric; MPN Murata GRM/GCM, TDK C/CGA or KEMET (X7R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
C303, C310, C311, C328, C330, C331, C333, C335, C336: 100nF; C_0402_1005Metric; MPN Murata GRM/GCM, TDK C/CGA or KEMET (X7R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
C312, C313, C314, C315, C316, C317, C318, C319, C320, C321, C322, C323: 100nF; C_0201_0603Metric; MPN Murata GRM/GCM, TDK C/CGA or KEMET (X7R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
C324, C325, C326: 10uF/6.3V; C_0603_1608Metric; MPN Murata GRM/GCM, TDK C/CGA or KEMET (X7R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
C327: 22uF/6.3V; C_0805_2012Metric; MPN Murata GRM/GCM, TDK C/CGA or KEMET (X7R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
C329, C334: 1uF; C_0402_1005Metric; MPN Murata GRM/GCM, TDK C/CGA or KEMET (X7R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
C332, C337: 10uF/6.3V; C_0402_1005Metric; MPN Murata GRM/GCM, TDK C/CGA or KEMET (X7R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
D301, D302, D303, D304: red; LED_0603_1608Metric; MPN Kingbright APHHS1005SURCK (low Vf red) 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
FB301, FB302, FB303: BLM18PG221SN1D; L_0603_1608Metric; MPN Murata BLM18PG221SN1D
J301: PCIe x1 edge fingers; BUS_PCIexpress_x1
R301, R302, R308, R309, R312, R313, R316, R317: 49.9; R_0402_1005Metric; MPN Yageo RC0402FR-0749R9L (alt Panasonic E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; not fitted
R303: 100k; R_0402_1005Metric; MPN Yageo RC0402FR-07100KL (alt Panasonic E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
R304, R325, R326, R327, R328, R329, R330, R331, R332, R333, R334, R335, R336, R337, R338, R339, R340: 5.1k; R_0402_1005Metric; MPN Yageo RC0402FR-075K1L (alt Panasonic ER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
R305: 200R 1%; R_0402_1005Metric; MPN Yageo RC0402FR-07200RL (alt Panasonic E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
R306, R307, R310, R311, R314, R315: 0; R_0402_1005Metric; MPN Yageo RC0402JR-070RL (0R jumper)
R318, R319, R320, R321, R322, R323, R324: 330; R_0402_1005Metric; MPN Yageo RC0402FR-07330RL (alt Panasonic E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
R341: 330; R_0402_1005Metric; MPN Yageo RC0402FR-07330RL (alt Panasonic E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; not fitted
R342, R343, R344: 0; R_0402_1005Metric; MPN Yageo RC0402JR-070RL (0R jumper); not fitted
R345, R346, R347, R348: 680; R_0402_1005Metric; MPN Yageo RC0402FR-07680RL (alt Panasonic E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
R349: 200k; R_0402_1005Metric; MPN Yageo RC0402FR-07200KL (alt Panasonic E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
TP301: PCIE_PERST_N; TestPoint_Pad_D1.0mm
TP302: SW_FATAL_N; TestPoint_Pad_D1.0mm
TP303: SW_INTA_N; TestPoint_Pad_D1.0mm
TP304: UP_CLKREQ_N; TestPoint_Pad_D1.0mm
U301: PI7C9X3G606GP; LFBGA-144_10x10mm_Layout12x12_P0.8mm; MPN PI7C9X3G606GPAEX (GPQ = AEC-Q100 option)
U302: SN74LVC1G07DCKR; SOT-353_SC-70-5; MPN TI SN74LVC1G07DCKR
U303: 25AA640A; SOIC-8_3.9x4.9mm_P1.27mm; MPN 25AA640A-I/SN (1.8V, 2-byte addr) VERIF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
U304: PCA9306DCUR; VSSOP-8_2.3x2mm_P0.5mm; MPN PCA9306DCUR

Connections:
+0V95: C312.1, C313.1, C314.1, C315.1, C316.1, C317.1, C318.1, C319.1, C320.1, C321.1, C322.1, C323.1, C324.1, C325.1, C326.1, C327.1, FB301.1, U301.D6 (VP), U301.D7 (VP), U301.E5 (VDDC), U301.E7 (VDDC), U301.F6 (VDDC), U301.F8 (VDDC), U301.G5 (VDDC), U301.G7 (VDDC), U301.H6 (VDDC), U301.H8 (VDDC), U301.J6 (VP), U301.J7 (VP)
+1V8: C303.1, C310.1, C330.1, C331.1, C332.1, FB302.1, FB303.1, R304.1, R325.1, R326.1, R327.1, R328.1, R329.1, R330.1, R331.1, R332.1, R333.1, R334.1, R335.1, R336.1, R337.1, R338.1, R339.1, R340.1, U301.D10 (VDDR), U301.J3 (VDDR), U302.5 (VCC), U303.3 (~WP), U303.7 (~HOLD), U303.8 (VCC), U304.2 (VREF1)
+3V3: R345.1, R346.1, R347.1, R348.1, R349.1
GND: C303.2, C310.2, C311.2, C312.2, C313.2, C314.2, C315.2, C316.2, C317.2, C318.2, C319.2, C320.2, C321.2, C322.2, C323.2, C324.2, C325.2, C326.2, C327.2, C328.2, C329.2, C330.2, C331.2, C332.2, C333.2, C334.2, C335.2, C336.2, C337.2, J301.A4 (GND(x9)), J301.A12 (GND(x9)), J301.A15 (GND(x9)), J301.A18 (GND(x9)), J301.B4 (GND(x9)), J301.B7 (GND(x9)), J301.B13 (GND(x9)), J301.B16 (GND(x9)), J301.B18 (GND(x9)), R301.2, R302.2, R303.2, R305.2, R308.2, R309.2, R312.2, R313.2, R316.2, R317.2, R318.2, R319.2, R320.2, R321.2, R322.2, R323.2, R324.2, R341.2, R342.2, R343.2, R344.2, U301.B1 (VSS), U301.B4 (VSS), U301.B6 (VSS), U301.B7 (VSS), U301.B8 (VSS), U301.B9 (VSS), U301.B10 (VSS), U301.D5 (VSS), U301.E6 (VSS), U301.E8 (VSS), U301.F5 (VSS), U301.F7 (VSS), U301.F11 (VSS), U301.G6 (VSS), U301.G8 (VSS), U301.H5 (VSS), U301.H7 (VSS), U301.J8 (VSS), U301.K2 (VSS), U301.K11 (VSS), U301.L3 (VSS), U301.L4 (VSS), U301.L5 (VSS), U301.L6 (REFCLKP1), U301.L7 (REFCLKN1), U301.L8 (VSS), U301.L9 (VSS), U301.L10 (VSS), U302.3 (GND), U303.4 (GND), U304.1 (GND)
I2C_SCL: U304.6 (SCL2)
I2C_SDA: U304.5 (SDA2)
unnamed: C301.1, U301.C10 (PETP0)
unnamed: C301.2, J301.A16 (PERp0(hostRX))
unnamed: C302.1, U301.C9 (PETN0)
unnamed: C302.2, J301.A17 (PERn0(hostRX))
unnamed: C304.1, U301.C8 (PETP1)
unnamed: C305.1, U301.C7 (PETN1)
unnamed: C306.1, U301.K3 (PETP2)
unnamed: C307.1, U301.K4 (PETN2)
unnamed: C308.1, U301.K5 (PETP3)
unnamed: C309.1, U301.K6 (PETN3)
unnamed: C311.1, R349.2, U304.7 (VREF2), U304.8 (EN)
unnamed: C328.1, C329.1, FB301.2, U301.D4 (C_VDDC)
unnamed: C333.1, C334.1, FB302.2, U301.D2 (C_VDDR)
unnamed: C335.1, C336.1, C337.1, FB303.2, U301.D8 (VPH), U301.J5 (VPH)
unnamed: D301.1 (K), U301.E11 (PORTGOOD_L0)
unnamed: D301.2 (A), R345.2
unnamed: D302.1 (K), U301.E10 (PORTGOOD_L1)
unnamed: D302.2 (A), R346.2
unnamed: D303.1 (K), U301.G11 (PORTGOOD_L4)
unnamed: D303.2 (A), R347.2
unnamed: D304.1 (K), U301.F10 (PORTGOOD_L5)
unnamed: D304.2 (A), R348.2
unnamed: J301.A1 (PRSNT1#), J301.B17 (PRSNT2#)
unnamed: J301.A13 (REFCLK+), R301.1, U301.A6 (REFCLKP0)
unnamed: J301.A14 (REFCLK-), R302.1, U301.A5 (REFCLKN0)
unnamed: J301.B14 (PETp0(hostTX)), U301.A10 (PERP0)
unnamed: J301.B15 (PETn0(hostTX)), U301.A9 (PERN0)
unnamed: R304.2, U301.A12 (PERST_L), U302.4
unnamed: R305.1, U301.C6 (RESREF)
unnamed: R306.1, U301.A2 (REFCLKOP1)
unnamed: R307.1, U301.A1 (REFCLKON1)
unnamed: R310.1, U301.A4 (REFCLKOP4)
unnamed: R311.1, U301.A3 (REFCLKON4)
unnamed: R314.1, U301.B3 (REFCLKOP5)
unnamed: R315.1, U301.C3 (REFCLKON5)
unnamed: R318.1, U301.G9 (CHIPMODE1)
unnamed: R319.1, U301.F9 (CHIPMODE0)
unnamed: R320.1, U301.C11 (PORTCFG1)
unnamed: R321.1, U301.D9 (CKMODE)
unnamed: R322.1, U301.E2 (TEST)
unnamed: R323.1, U301.H10 (TMS)
unnamed: R324.1, U301.J9 (TRST_L)
unnamed: R325.2, U301.D11 (PORTCFG2)
unnamed: R326.2, U301.B11 (PORTCFG0)
unnamed: R327.2, TP302.1, U301.E9 (FATAL_ERR_L/HOT_PLUG_EN_L)
unnamed: R328.2, R341.1, TP303.1, U301.E1 (INTA_L/PM_L11_EN_L)
unnamed: R329.2, U301.K12 (EECK), U303.6 (SCK)
unnamed: R330.2, U301.M11 (EECS_L), U303.1 (~CS)
unnamed: R331.2, U301.L12 (SCL_I2C), U304.3 (SCL1)
unnamed: R332.2, U301.M12 (SDA_I2C), U304.4 (SDA1)
unnamed: R333.2, U301.L1 (SHCL_I2C)
unnamed: R334.2, U301.M1 (SHDA_I2C)
unnamed: R335.2, U301.M2 (SHPCINT_L)
unnamed: R336.2, U301.A11 (JTAG_SEL_L)
unnamed: R340.2, TP304.1, U301.E3 (GPIO8/CLKREQ_L0)
unnamed: R342.1, U301.J2 (PDC_L1)
unnamed: R343.1, U301.J1 (PDC_L4)
unnamed: R344.1, U301.H1 (PDC_L5)
unnamed: U301.J12 (EEDO), U303.2 (MISO)
unnamed: U301.L11 (EEDI), U303.5 (MOSI)
PCIE_PERST_N: J301.A11 (PERST#), R303.1, TP301.1, U302.2
SLOT1_CLKREQ_N: R337.2, U301.E4 (GPIO9/CLKREQ_L1)
SLOT1_PCIE_RX_N: C305.2
SLOT1_PCIE_RX_P: C304.2
SLOT1_PCIE_TX_N: U301.A7 (PERN1)
SLOT1_PCIE_TX_P: U301.A8 (PERP1)
SLOT1_REFCLK_N: R307.2, R309.1
SLOT1_REFCLK_P: R306.2, R308.1
SLOT2_CLKREQ_N: R338.2, U301.D3 (GPIO12/CLKREQ_L4)
SLOT2_PCIE_RX_N: C307.2
SLOT2_PCIE_RX_P: C306.2
SLOT2_PCIE_TX_N: U301.M4 (PERN2)
SLOT2_PCIE_TX_P: U301.M3 (PERP2)
SLOT2_REFCLK_N: R311.2, R313.1
SLOT2_REFCLK_P: R310.2, R312.1
SLOT3_CLKREQ_N: R339.2, U301.C4 (GPIO13/CLKREQ_L5)
SLOT3_PCIE_RX_N: C309.2
SLOT3_PCIE_RX_P: C308.2
SLOT3_PCIE_TX_N: U301.M6 (PERN3)
SLOT3_PCIE_TX_P: U301.M5 (PERP3)
SLOT3_REFCLK_N: R315.2, R317.1
SLOT3_REFCLK_P: R314.2, R316.1

Notes on the sheet:
PI7C9X3G606GP (Diodes DS43484 Rev5-2) - ball map transcribed from section 3; all 144 balls placed (power/GND balls drawn stacked). PORTCFG[2:0]=101 -> 6-port/6-lane mode (Table 5-1). Lane map (Table 5-4): L0=P0 upstream, L1=P1, L2=P4, L3=P5, L4=P6, L5=P7. Slot1 = lane1/P1 (REFCLKO1, CLKREQ_L1), Slo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
