jmendoza-10/connectivity-module-public/hardware/kicad/power_input.kicad_sch

## KiCad design hardware/kicad/power_input.kicad_sch (2026-10-14)

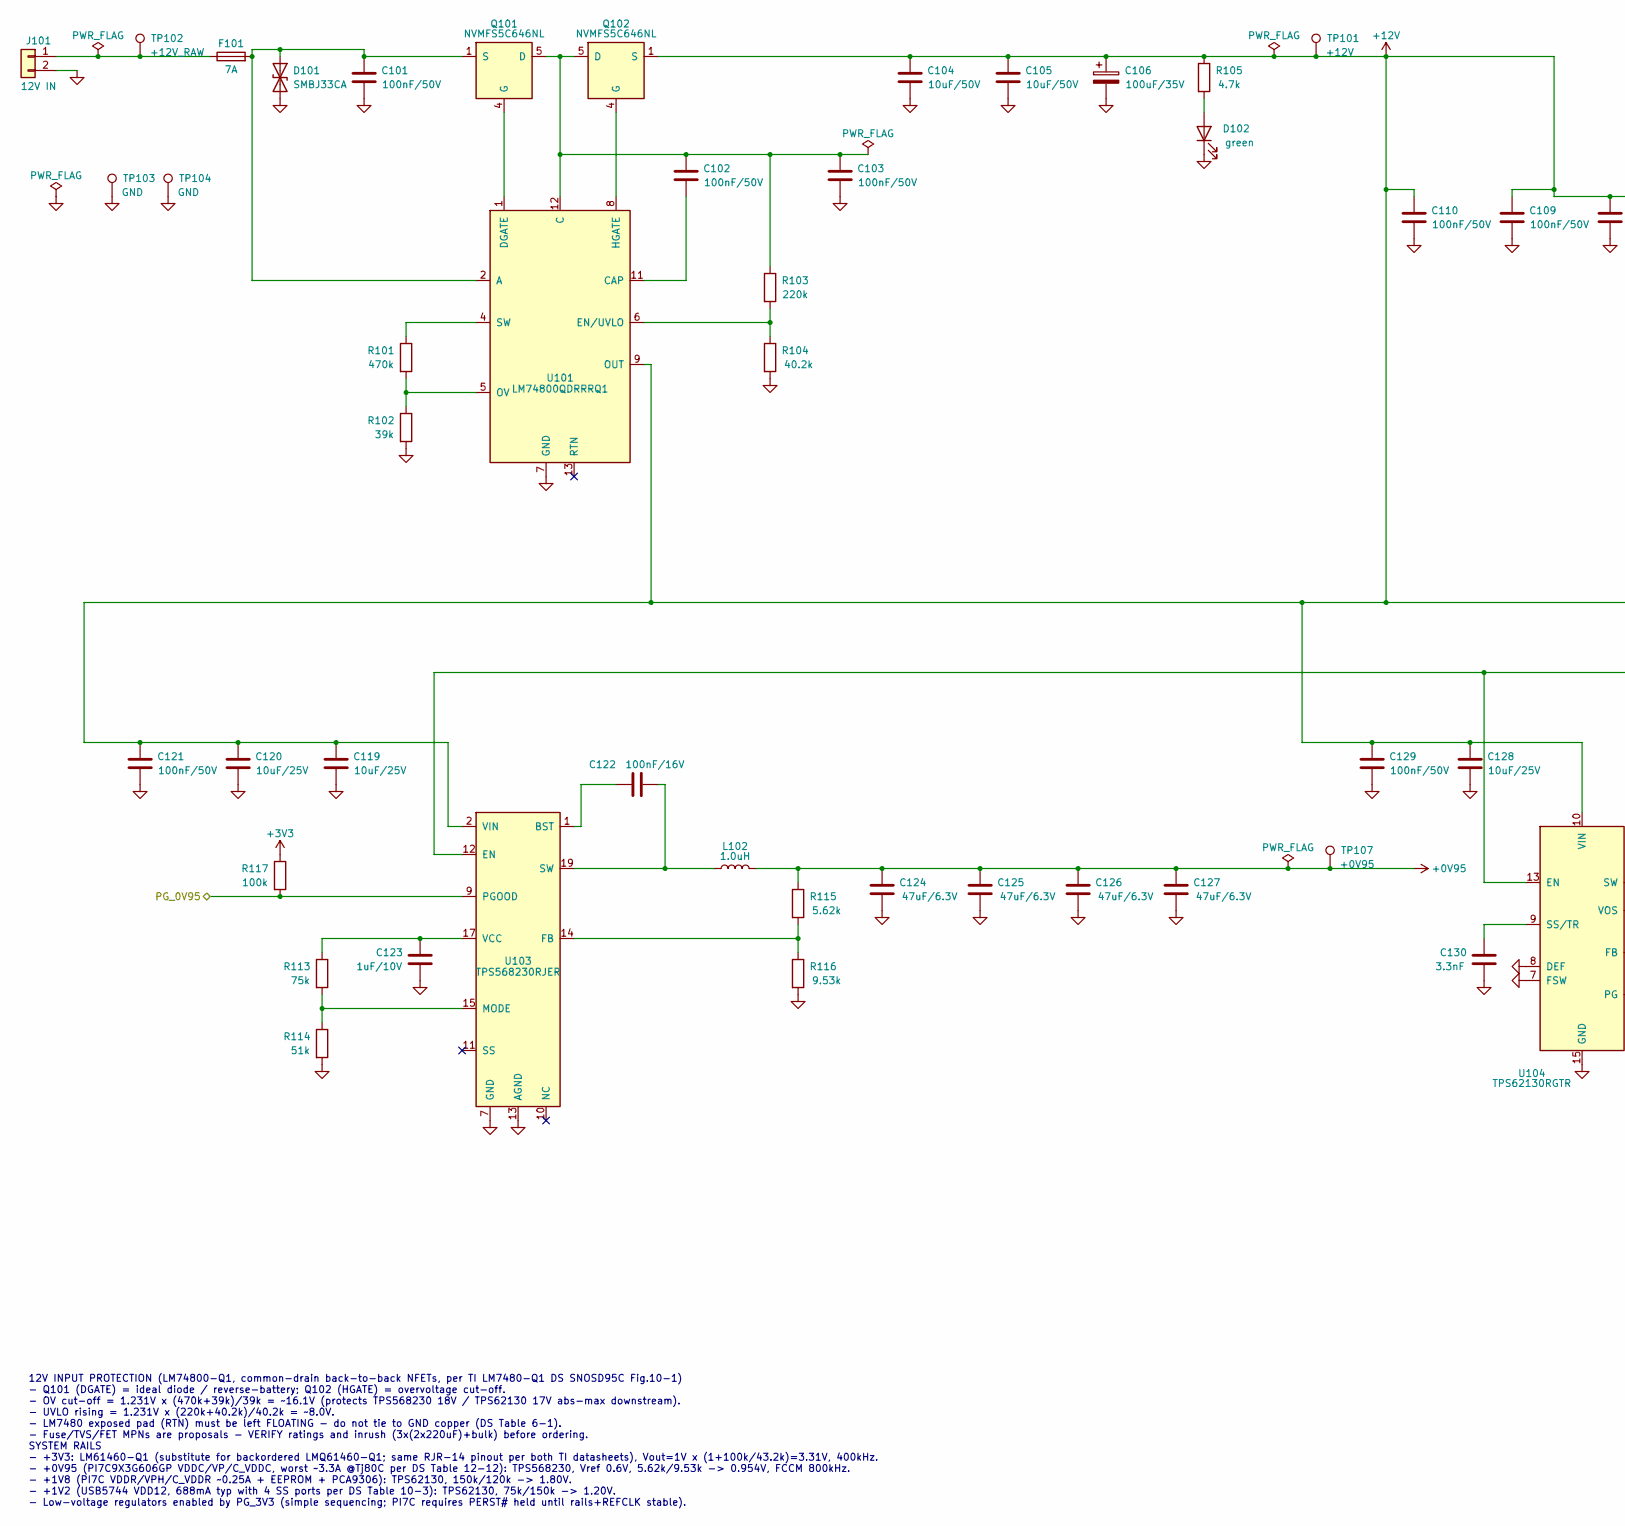
[picture p22: schematic power_input.kicad_sch, part in row 1, column 1]

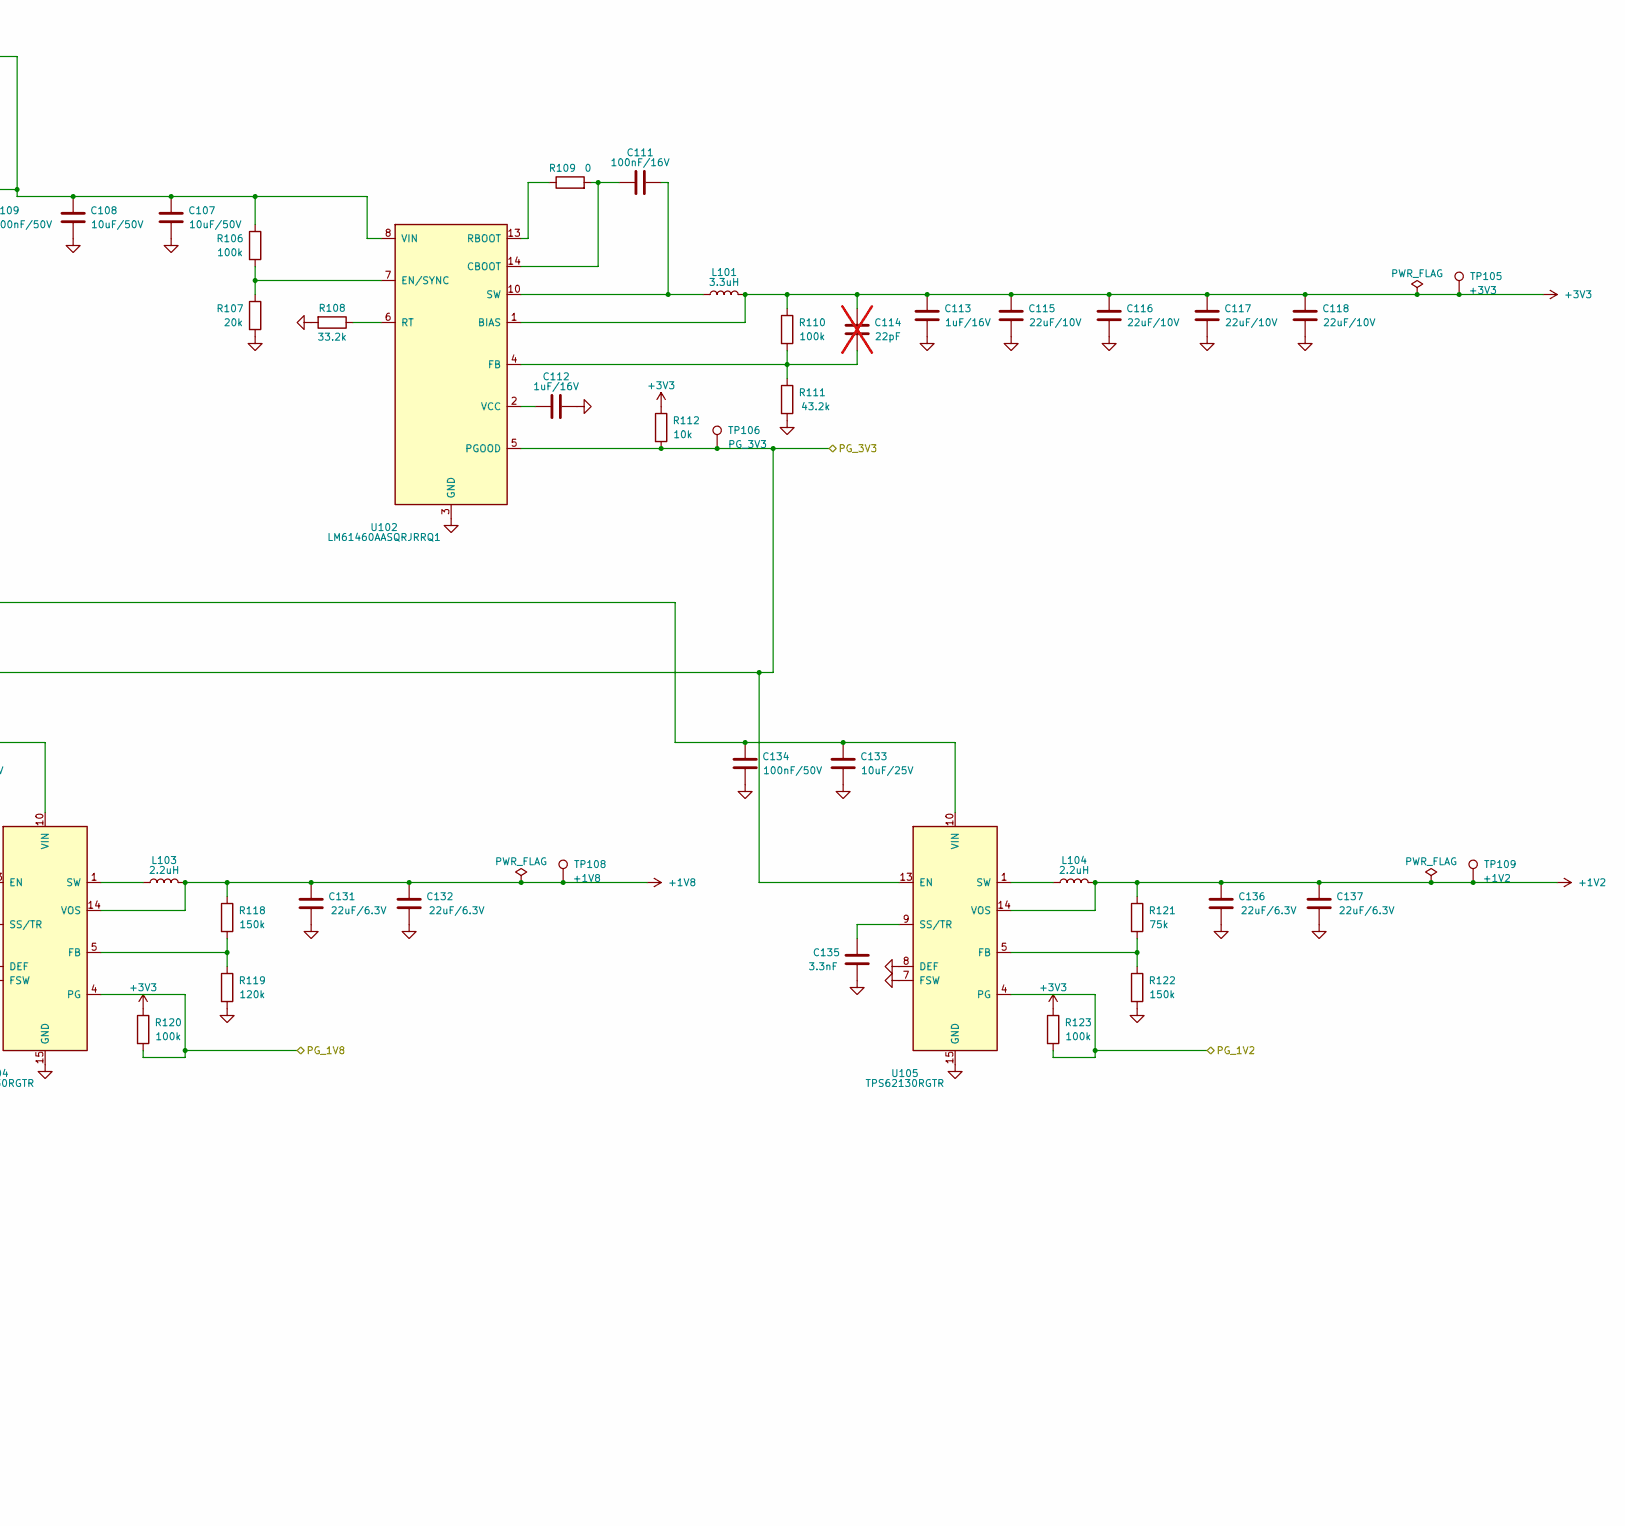
[picture p23: schematic power_input.kicad_sch, part in row 1, column 2]

Parts:
C101, C102, C103: 100nF/50V; C_0603_1608Metric; MPN Murata GRM/GCM, TDK C/CGA or KEMET (X7R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
C104, C105, C107, C108: 10uF/50V; C_1210_3225Metric; MPN Murata GRM/GCM, TDK C/CGA or KEMET (X7R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
C106: 100uF/35V; CP_Elec_6.3x7.7; MPN Panasonic EEE-FK1V101P (AEC-Q200) VERIFY
C109, C110, C121, C129, C134: 100nF/50V; C_0402_1005Metric; MPN Murata GRM/GCM, TDK C/CGA or KEMET (X7R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
C111, C122: 100nF/16V; C_0402_1005Metric; MPN Murata GRM/GCM, TDK C/CGA or KEMET (X7R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
C112, C113: 1uF/16V; C_0402_1005Metric; MPN Murata GRM/GCM, TDK C/CGA or KEMET (X7R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
C114: 22pF; C_0402_1005Metric; MPN Murata GRM/GCM, TDK C/CGA or KEMET (X7R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; not fitted
C115, C116, C117, C118: 22uF/10V; C_1210_3225Metric; MPN Murata GRM/GCM, TDK C/CGA or KEMET (X7R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
C119, C120: 10uF/25V; C_1206_3216Metric; MPN Murata GRM/GCM, TDK C/CGA or KEMET (X7R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
C123: 1uF/10V; C_0402_1005Metric; MPN Murata GRM/GCM, TDK C/CGA or KEMET (X7R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
C124, C125, C126, C127: 47uF/6.3V; C_1206_3216Metric; MPN Murata GRM/GCM, TDK C/CGA or KEMET (X7R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
C128, C133: 10uF/25V; C_0805_2012Metric; MPN Murata GRM/GCM, TDK C/CGA or KEMET (X7R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
C130, C135: 3.3nF; C_0402_1005Metric; MPN Murata GRM/GCM, TDK C/CGA or KEMET (X7R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
C131, C132, C136, C137: 22uF/6.3V; C_0805_2012Metric; MPN Murata GRM/GCM, TDK C/CGA or KEMET (X7R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
D101: SMBJ33CA; D_SMB; MPN Littelfuse SMBJ33CA (bidirectional, per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
D102: green; LED_0603_1608Metric; MPN Lite-On LTST-C191KGKT
F101: 7A; Fuse_1206_3216Metric; MPN Littelfuse 0466007.NR (VERIFY I2t vs in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
J101: 12V IN; Molex_Micro-Fit_3.0_43650-0200_1x02_P3.00mm_Horizontal; MPN Molex 43650-0200
L101: 3.3uH; L_Coilcraft_XAL7070-XXX; MPN XAL7070-332MEB
L102: 1.0uH; L_Coilcraft_XAL5030-XXX; MPN XAL5030-102MEB
L103, L104: 2.2uH; L_Coilcraft_XAL4020-XXX; MPN XAL4020-222MEB
Q101, Q102: NVMFS5C646NL; ONSemi_SO-8FL_488AA; MPN onsemi NVMFS5C646NLAFT1G (60V, 4.7mOhm@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
R101: 470k; R_0402_1005Metric; MPN Yageo RC0402FR-07470KL (alt Panasonic E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
R102: 39k; R_0402_1005Metric; MPN Yageo RC0402FR-0739KL (alt Panasonic ER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
R103: 220k; R_0402_1005Metric; MPN Yageo RC0402FR-07220KL (alt Panasonic E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
R104: 40.2k; R_0402_1005Metric; MPN Yageo RC0402FR-0740K2L (alt Panasonic E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
R105: 4.7k; R_0402_1005Metric; MPN Yageo RC0402FR-074K7L (alt Panasonic ER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
R106, R110, R117, R120, R123: 100k; R_0402_1005Metric; MPN Yageo RC0402FR-07100KL (alt Panasonic E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
R107: 20k; R_0402_1005Metric; MPN Yageo RC0402FR-0720KL (alt Panasonic ER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
R108: 33.2k; R_0402_1005Metric; MPN Yageo RC0402FR-0733K2L (alt Panasonic E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
R109: 0; R_0402_1005Metric; MPN Yageo RC0402JR-070RL (0R jumper)
R111: 43.2k; R_0402_1005Metric; MPN Yageo RC0402FR-0743K2L (alt Panasonic E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
R112: 10k; R_0402_1005Metric; MPN Yageo RC0402FR-0710KL (alt Panasonic ER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
R113, R121: 75k; R_0402_1005Metric; MPN Yageo RC0402FR-0775KL (alt Panasonic ER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
R114: 51k; R_0402_1005Metric; MPN Yageo RC0402FR-0751KL (alt Panasonic ER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
R115: 5.62k; R_0402_1005Metric; MPN Yageo RC0402FR-075K62L (alt Panasonic E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
R116: 9.53k; R_0402_1005Metric; MPN Yageo RC0402FR-079K53L (alt Panasonic E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
R118, R122: 150k; R_0402_1005Metric; MPN Yageo RC0402FR-07150KL (alt Panasonic E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
R119: 120k; R_0402_1005Metric; MPN Yageo RC0402FR-07120KL (alt Panasonic E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
TP101: +12V; TestPoint_Pad_D1.0mm
TP102: +12V_RAW; TestPoint_Pad_D1.0mm
TP103, TP104: GND; TestPoint_Pad_D1.0mm
TP105: +3V3; TestPoint_Pad_D1.0mm
TP106: PG_3V3; TestPoint_Pad_D1.0mm
TP107: +0V95; TestPoint_Pad_D1.0mm
TP108: +1V8; TestPoint_Pad_D1.0mm
TP109: +1V2; TestPoint_Pad_D1.0mm
U101: LM74800QDRRRQ1; WSON-12-1EP_3x3mm_P0.5mm_EP1.5x2.5mm
U102: LM61460AASQRJRRQ1; MPN LM61460AASQRJRRQ1
U103: TPS568230RJER; Texas_RJE0020A_VQFN-20-1EP_3x3mm_P0.45mm_EP0.675x0.76mm; MPN TPS568230RJER
U104, U105: TPS62130RGTR; VQFN-16-1EP_3x3mm_P0.5mm_EP1.68x1.68mm_ThermalVias; MPN TPS62130RGTR (TPS62130AQRGTRQ1 = AEC op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

Connections:
+0V95: C124.1, C125.1, C126.1, C127.1, L102.2, R115.1, TP107.1
+1V2: C136.1, C137.1, L104.2, R121.1, TP109.1, U105.14 (VOS)
+1V8: C131.1, C132.1, L103.2, R118.1, TP108.1, U104.14 (VOS)
+3V3: C113.1, C114.1, C115.1, C116.1, C117.1, C118.1, L101.2, R110.1, R112.1, R117.1, R120.1, R123.1, TP105.1, U102.1 (BIAS)
+12V: C104.1, C105.1, C106.1, C107.1, C108.1, C109.1, C110.1, C119.1, C120.1, C121.1, C128.1, C129.1, C133.1, C134.1, Q102.1 (S), Q102.2 (S), Q102.3 (S), R105.1, R106.1, TP101.1, U101.9 (OUT), U102.8 (VIN), U102.12 (VIN), U103.2 (VIN), U103.3 (VIN), U103.4 (VIN), U103.5 (VIN), U104.10 (VIN), U104.11 (VIN), U104.12 (VIN), U105.10 (VIN), U105.11 (VIN), U105.12 (VIN)
GND: C101.2, C103.2, C104.2, C105.2, C106.2, C107.2, C108.2, C109.2, C110.2, C112.2, C113.2, C115.2, C116.2, C117.2, C118.2, C119.2, C120.2, C121.2, C123.2, C124.2, C125.2, C126.2, C127.2, C128.2, C129.2, C130.2, C131.2, C132.2, C133.2, C134.2, C135.2, C136.2, C137.2, D101.2 (A2), D102.1 (K), J101.2, R102.2, R104.2, R107.2, R108.2, R111.2, R114.2, R116.2, R119.2, R122.2, TP103.1, TP104.1, U101.7 (GND), U102.3 (GND), U102.9 (GND), U102.11 (GND), U103.7 (GND), U103.8 (GND), U103.13 (AGND), U103.18 (GND), U103.21 (GND), U104.6 (GND), U104.7 (FSW), U104.8 (DEF), U104.15 (GND), U104.16 (GND), U104.17 (GND), U105.6 (GND), U105.7 (FSW), U105.8 (DEF), U105.15 (GND), U105.16 (GND), U105.17 (GND)
unnamed: C101.1, D101.1 (A1), F101.2, Q101.1 (S), Q101.2 (S), Q101.3 (S), U101.2 (A)
unnamed: C102.1, U101.11 (CAP)
unnamed: C102.2, C103.1, Q101.5 (D), Q102.5 (D), R103.1, U101.3 (VSNS), U101.10 (VS), U101.12 (C)
unnamed: C111.1, R109.2, U102.14 (CBOOT)
unnamed: C111.2, L101.1, U102.10 (SW)
unnamed: C112.1, U102.2 (VCC)
unnamed: C114.2, R110.2, R111.1, U102.4 (FB)
unnamed: C122.1, U103.1 (BST)
unnamed: C122.2, L102.1, U103.6 (SW), U103.19 (SW), U103.20 (SW)
unnamed: C123.1, R113.1, U103.17 (VCC)
unnamed: C130.1, U104.9 (SS/TR)
unnamed: C135.1, U105.9 (SS/TR)
unnamed: D102.2 (A), R105.2
unnamed: F101.1, J101.1, TP102.1
unnamed: L103.1, U104.1 (SW), U104.2 (SW), U104.3 (SW)
unnamed: L104.1, U105.1 (SW), U105.2 (SW), U105.3 (SW)
unnamed: Q101.4 (G), U101.1 (DGATE)
unnamed: Q102.4 (G), U101.8 (HGATE)
unnamed: R101.1, U101.4 (SW)
unnamed: R101.2, R102.1, U101.5 (OV)
unnamed: R103.2, R104.1, U101.6 (EN/UVLO)
unnamed: R106.2, R107.1, U102.7 (EN/SYNC)
unnamed: R108.1, U102.6 (RT)
unnamed: R109.1, U102.13 (RBOOT)
unnamed: R113.2, R114.1, U103.15 (MODE)
unnamed: R115.2, R116.1, U103.14 (FB)
unnamed: R118.2, R119.1, U104.5 (FB)
unnamed: R121.2, R122.1, U105.5 (FB)
unnamed: U103.10 (NC), U103.16 (NC)
PG_0V95: R117.2, U103.9 (PGOOD)
PG_1V2: R123.2, U105.4 (PG)
PG_1V8: R120.2, U104.4 (PG)
PG_3V3: R112.2, TP106.1, U102.5 (PGOOD), U103.12 (EN), U104.13 (EN), U105.13 (EN)

Notes on the sheet:
12V INPUT PROTECTION (LM74800-Q1, common-drain back-to-back NFETs, per TI LM7480-Q1 DS SNOSD95C Fig.10-1) - Q101 (DGATE) = ideal diode / reverse-battery; Q102 (HGATE) = overvoltage cut-off. - OV cut-off = 1.231V x (470k+39k)/39k = ~16.1V (protects TPS568230 18V / TPS62130 17V abs-max downstream). -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
