jmendoza-10/connectivity-module-public/hardware/kicad/slot1.kicad_sch

## KiCad design hardware/kicad/slot1.kicad_sch (2026-10-14)

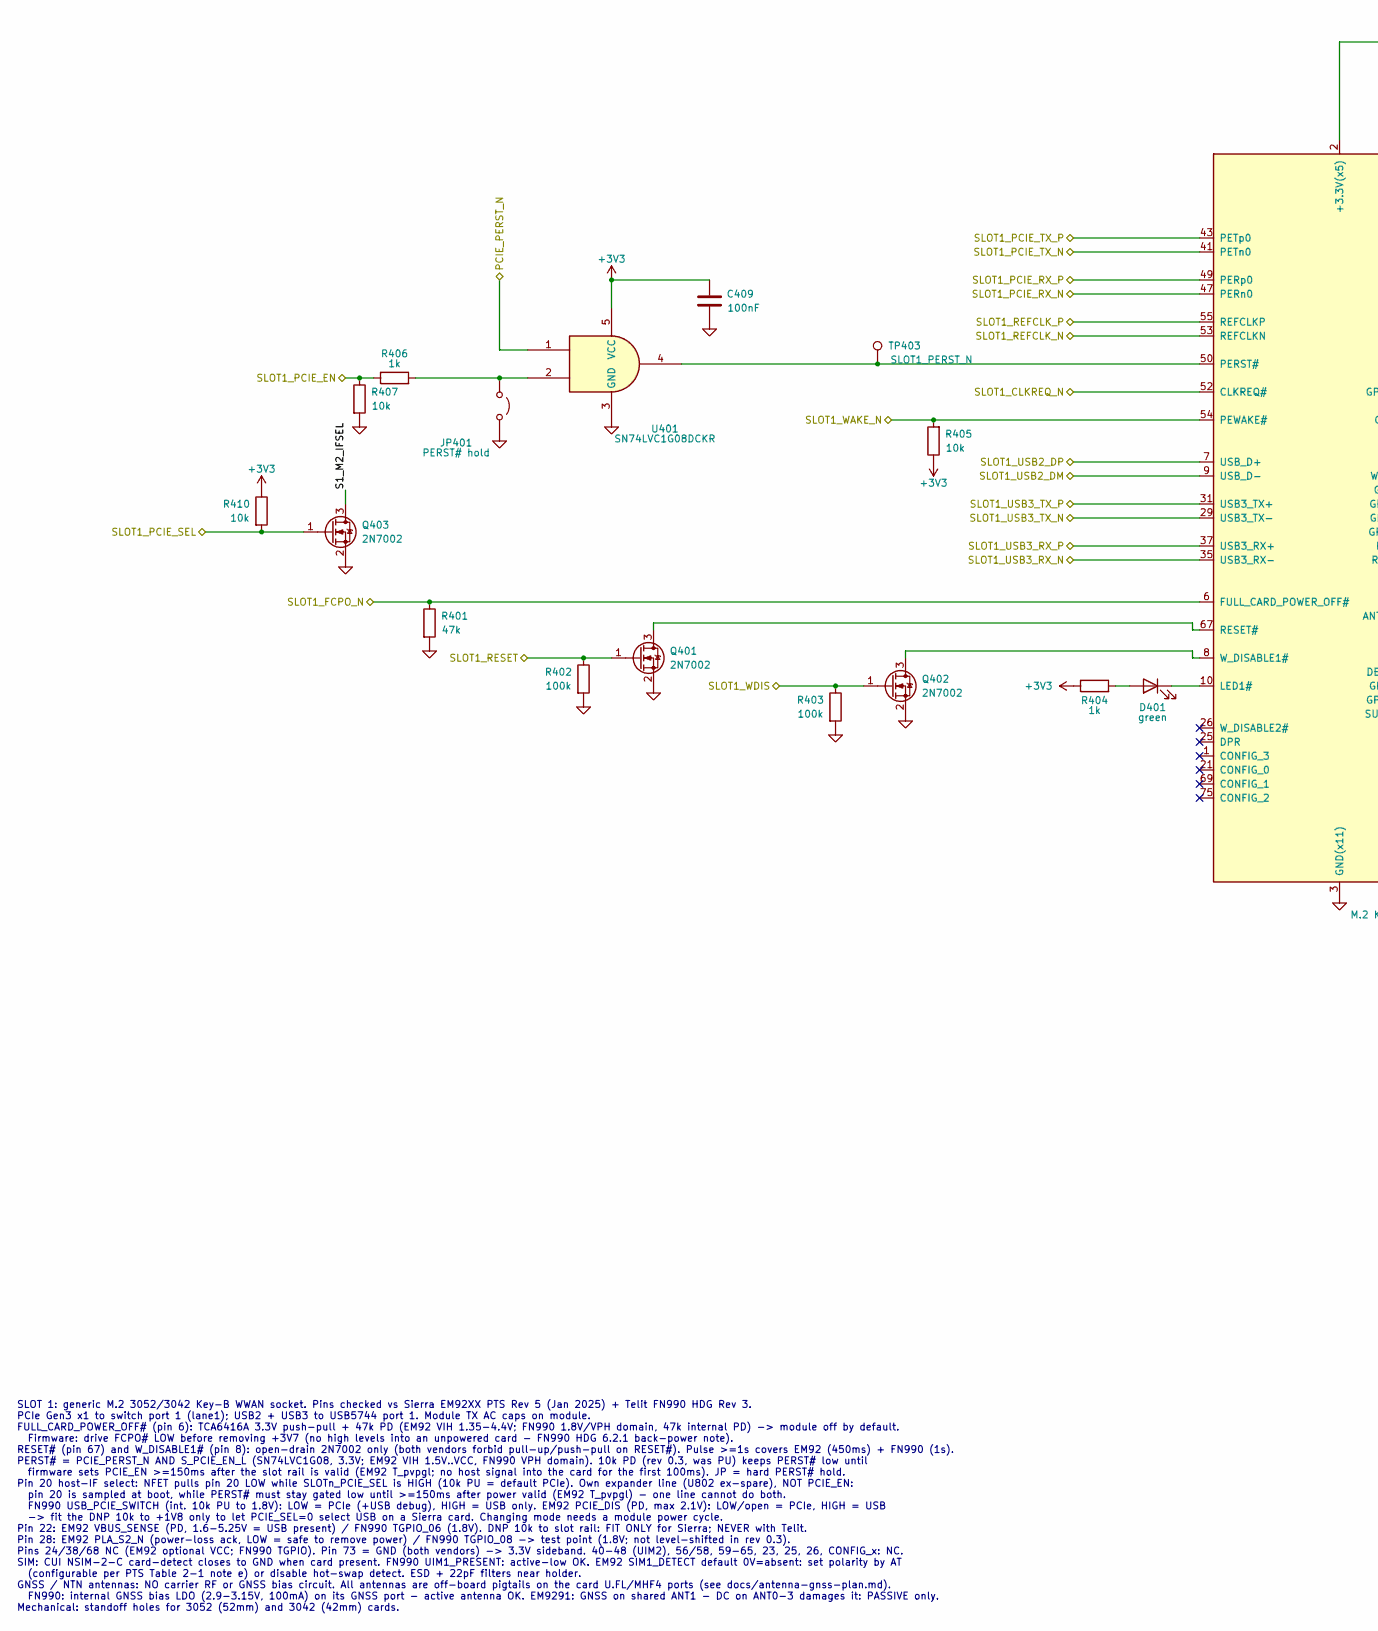
[picture p24: schematic slot1.kicad_sch, part in row 1, column 1]

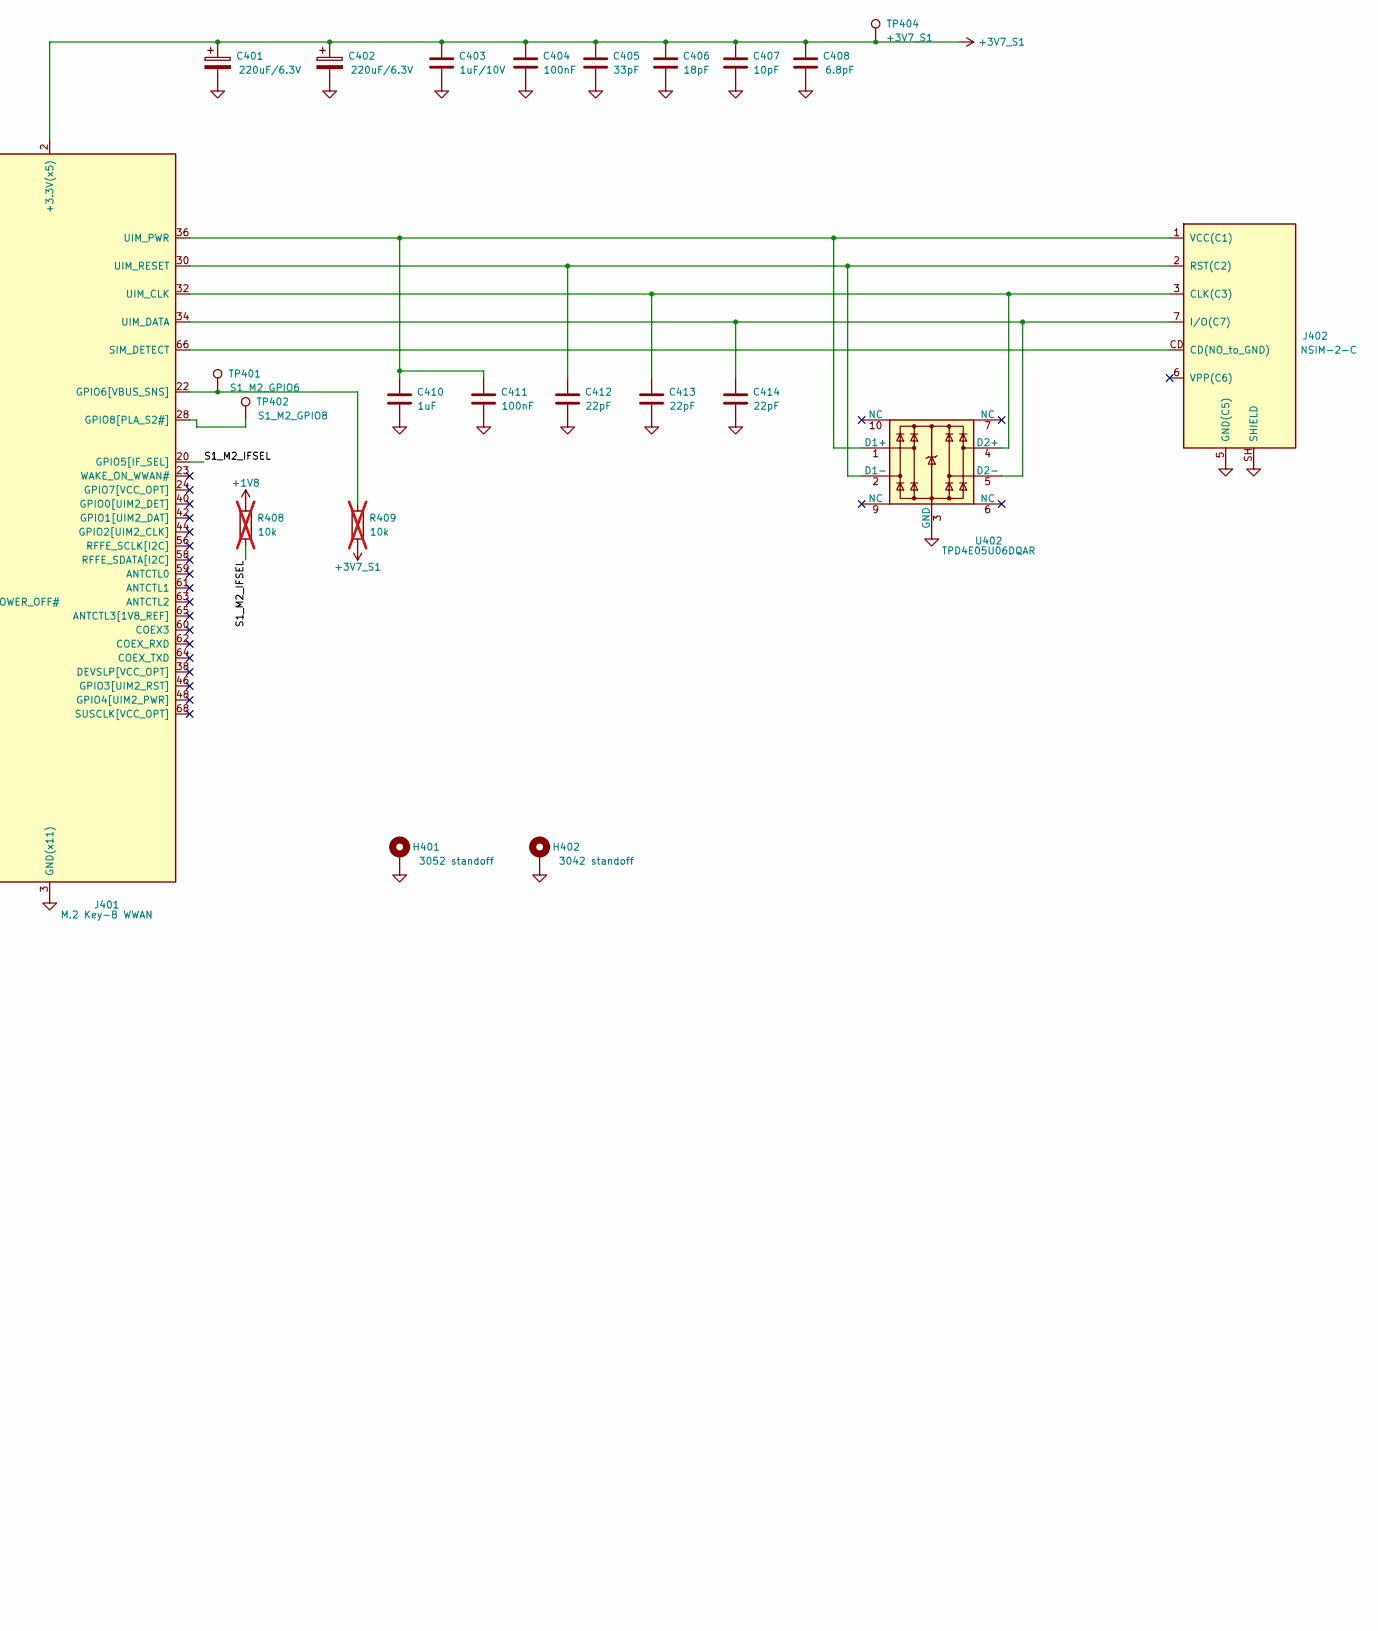
[picture p25: schematic slot1.kicad_sch, part in row 1, column 2]

Parts:
C401, C402: 220uF/6.3V; CP_EIA-7343-31_Kemet-D; MPN KEMET T520D227M006ATE015 (low ESR polym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
C403: 1uF/10V; C_0402_1005Metric; MPN Murata GRM/GCM, TDK C/CGA or KEMET (X7R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
C404, C409, C411: 100nF; C_0402_1005Metric; MPN Murata GRM/GCM, TDK C/CGA or KEMET (X7R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
C405: 33pF; C_0402_1005Metric; MPN Murata GRM/GCM, TDK C/CGA or KEMET (X7R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
C406: 18pF; C_0402_1005Metric; MPN Murata GRM/GCM, TDK C/CGA or KEMET (X7R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
C407: 10pF; C_0402_1005Metric; MPN Murata GRM/GCM, TDK C/CGA or KEMET (X7R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
C408: 6.8pF; C_0402_1005Metric; MPN Murata GRM/GCM, TDK C/CGA or KEMET (X7R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
C410: 1uF; C_0402_1005Metric; MPN Murata GRM/GCM, TDK C/CGA or KEMET (X7R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
C412, C413, C414: 22pF; C_0402_1005Metric; MPN Murata GRM/GCM, TDK C/CGA or KEMET (X7R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
D401: green; LED_0603_1608Metric; MPN Lite-On LTST-C191KGKT
H401: 3052 standoff; MountingHole_2.2mm_M2_Pad_Via; MPN Wurth WA-SMSI M2 SMT spacer (height per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
H402: 3042 standoff; MountingHole_2.2mm_M2_Pad_Via; MPN Wurth WA-SMSI M2 SMT spacer VERIFY P/N 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
J401: M.2 Key-B WWAN; MPN LOTES APCI0026-P001A (TW) VERIFY stack 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
J402: NSIM-2-C; nanoSIM_Hinged_CUI_NSIM-2-C; MPN CUI Devices NSIM-2-C
JP401: PERST# hold; PinHeader_1x02_P2.54mm_Vertical; MPN Samtec TSW-102-07-G-S + SNT-100-BK-G sh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
Q401, Q402, Q403: 2N7002; SOT-23; MPN Diodes Inc. 2N7002-7-F (AEC-Q101: onsem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
R401: 47k; R_0402_1005Metric; MPN Yageo RC0402FR-0747KL (alt Panasonic ER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
R402, R403: 100k; R_0402_1005Metric; MPN Yageo RC0402FR-07100KL (alt Panasonic E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
R404, R406: 1k; R_0402_1005Metric; MPN Yageo RC0402FR-071KL (alt Panasonic ERJ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
R405, R407, R410: 10k; R_0402_1005Metric; MPN Yageo RC0402FR-0710KL (alt Panasonic ER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
R408, R409: 10k; R_0402_1005Metric; MPN Yageo RC0402FR-0710KL (alt Panasonic ER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; not fitted
TP401: S1_M2_GPIO6; TestPoint_Pad_D1.0mm
TP402: S1_M2_GPIO8; TestPoint_Pad_D1.0mm
TP403: SLOT1_PERST_N; TestPoint_Pad_D1.0mm
TP404: +3V7_S1; TestPoint_Pad_D1.0mm
U401: SN74LVC1G08DCKR; SOT-353_SC-70-5; MPN TI SN74LVC1G08DCKR
U402: TPD4E05U06DQAR; USON-10_2.5x1.0mm_P0.5mm; MPN TI TPD4E05U06DQAR

Connections:
+1V8: R408.1
+3V3: C409.1, R404.1, R405.1, R410.1, U401.5 (VCC)
+3V7_S1: C401.1, C402.1, C403.1, C404.1, C405.1, C406.1, C407.1, C408.1, J401.2 (+3.3V(x5)), J401.4 (+3.3V(x5)), J401.70 (+3.3V(x5)), J401.72 (+3.3V(x5)), J401.74 (+3.3V(x5)), R409.1, TP404.1
GND: C401.2, C402.2, C403.2, C404.2, C405.2, C406.2, C407.2, C408.2, C409.2, C410.2, C411.2, C412.2, C413.2, C414.2, H401.1, H402.1, J401.3 (GND(x11)), J401.5 (GND(x11)), J401.11 (GND(x11)), J401.27 (GND(x11)), J401.33 (GND(x11)), J401.39 (GND(x11)), J401.45 (GND(x11)), J401.51 (GND(x11)), J401.57 (GND(x11)), J401.71 (GND(x11)), J401.73 (GND(x11)), J402.5 (GND(C5)), J402.SH (SHIELD), JP401.2 (B), Q401.2 (S), Q402.2 (S), Q403.2 (S), R401.2, R402.2, R403.2, R407.2, U401.3 (GND), U402.3 (GND), U402.8 (GND)
unnamed: C410.1, C411.1, J401.36 (UIM_PWR), J402.1 (VCC(C1)), U402.1 (D1+)
unnamed: C412.1, J401.30 (UIM_RESET), J402.2 (RST(C2)), U402.2 (D1-)
unnamed: C413.1, J401.32 (UIM_CLK), J402.3 (CLK(C3)), U402.4 (D2+)
unnamed: C414.1, J401.34 (UIM_DATA), J402.7 (I/O(C7)), U402.5 (D2-)
unnamed: D401.1 (K), J401.10 (LED1#)
unnamed: D401.2 (A), R404.2
unnamed: J401.8 (W_DISABLE1#), Q402.3 (D)
unnamed: J401.22 (GPIO6[VBUS_SNS]), R409.2, TP401.1
unnamed: J401.28 (GPIO8[PLA_S2#]), TP402.1
unnamed: J401.50 (PERST#), TP403.1, U401.4
unnamed: J401.66 (SIM_DETECT), J402.CD (CD(NO_to_GND))
unnamed: J401.67 (RESET#), Q401.3 (D)
unnamed: JP401.1 (A), R406.2, U401.2
PCIE_PERST_N: U401.1
S1_M2_IFSEL: J401.20 (GPIO5[IF_SEL]), Q403.3 (D), R408.2
SLOT1_CLKREQ_N: J401.52 (CLKREQ#)
SLOT1_FCPO_N: J401.6 (FULL_CARD_POWER_OFF#), R401.1
SLOT1_PCIE_EN: R406.1, R407.1
SLOT1_PCIE_RX_N: J401.47 (PERn0)
SLOT1_PCIE_RX_P: J401.49 (PERp0)
SLOT1_PCIE_SEL: Q403.1 (G), R410.2
SLOT1_PCIE_TX_N: J401.41 (PETn0)
SLOT1_PCIE_TX_P: J401.43 (PETp0)
SLOT1_REFCLK_N: J401.53 (REFCLKN)
SLOT1_REFCLK_P: J401.55 (REFCLKP)
SLOT1_RESET: Q401.1 (G), R402.1
SLOT1_USB2_DM: J401.9 (USB_D-)
SLOT1_USB2_DP: J401.7 (USB_D+)
SLOT1_USB3_RX_N: J401.35 (USB3_RX-)
SLOT1_USB3_RX_P: J401.37 (USB3_RX+)
SLOT1_USB3_TX_N: J401.29 (USB3_TX-)
SLOT1_USB3_TX_P: J401.31 (USB3_TX+)
SLOT1_WAKE_N: J401.54 (PEWAKE#), R405.2
SLOT1_WDIS: Q402.1 (G), R403.1

Notes on the sheet:
SLOT 1: generic M.2 3052/3042 Key-B WWAN socket. Pins checked vs Sierra EM92XX PTS Rev 5 (Jan 2025) + Telit FN990 HDG Rev 3. PCIe Gen3 x1 to switch port 1 (lane1); USB2 + USB3 to USB5744 port 1. Module TX AC caps on module. FULL_CARD_POWER_OFF# (pin 6): TCA6416A 3.3V push-pull + 47k PD (EM92 VIH 1.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
