jmendoza-10/connectivity-module-public/hardware/kicad/slot2.kicad_sch

## KiCad design hardware/kicad/slot2.kicad_sch (2026-10-14)

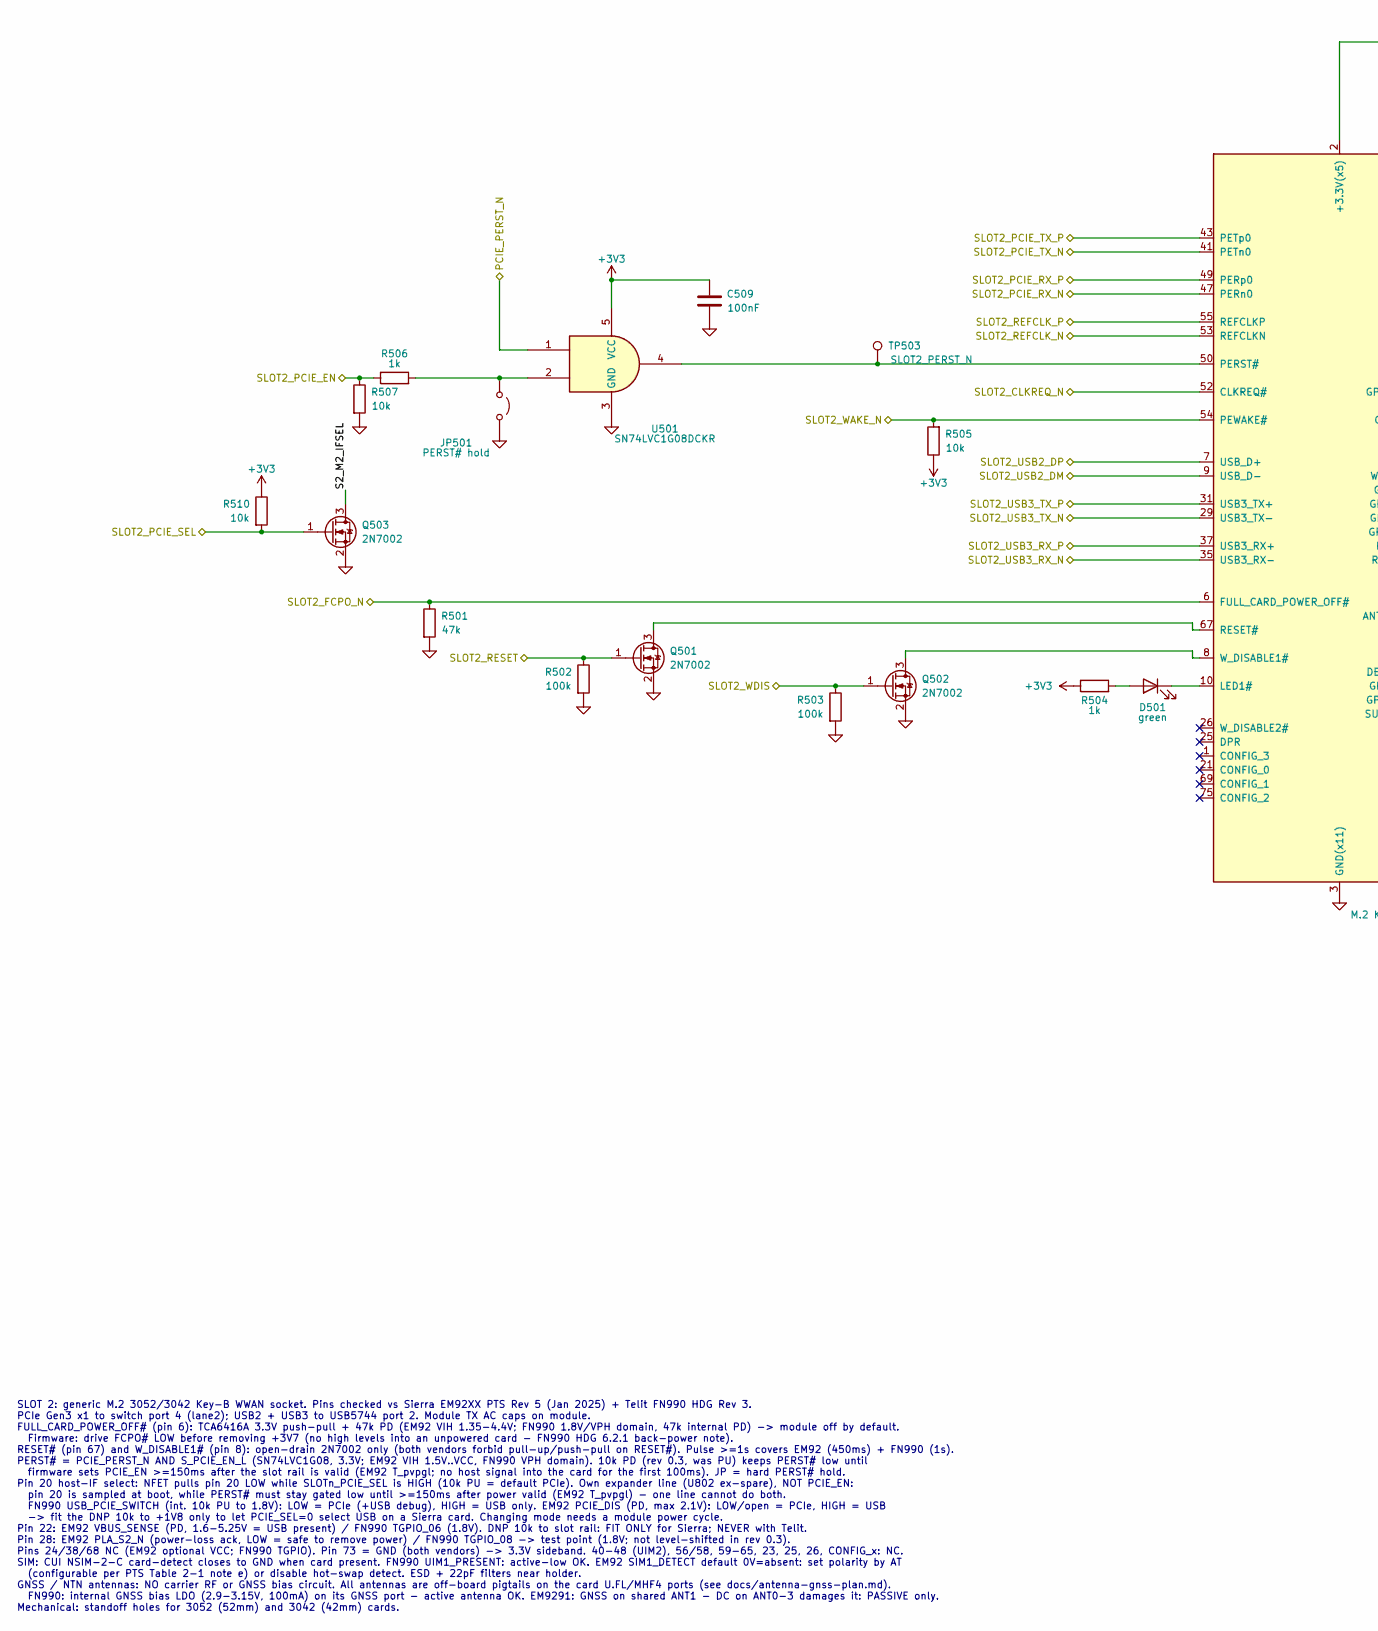
[picture p26: schematic slot2.kicad_sch, part in row 1, column 1]

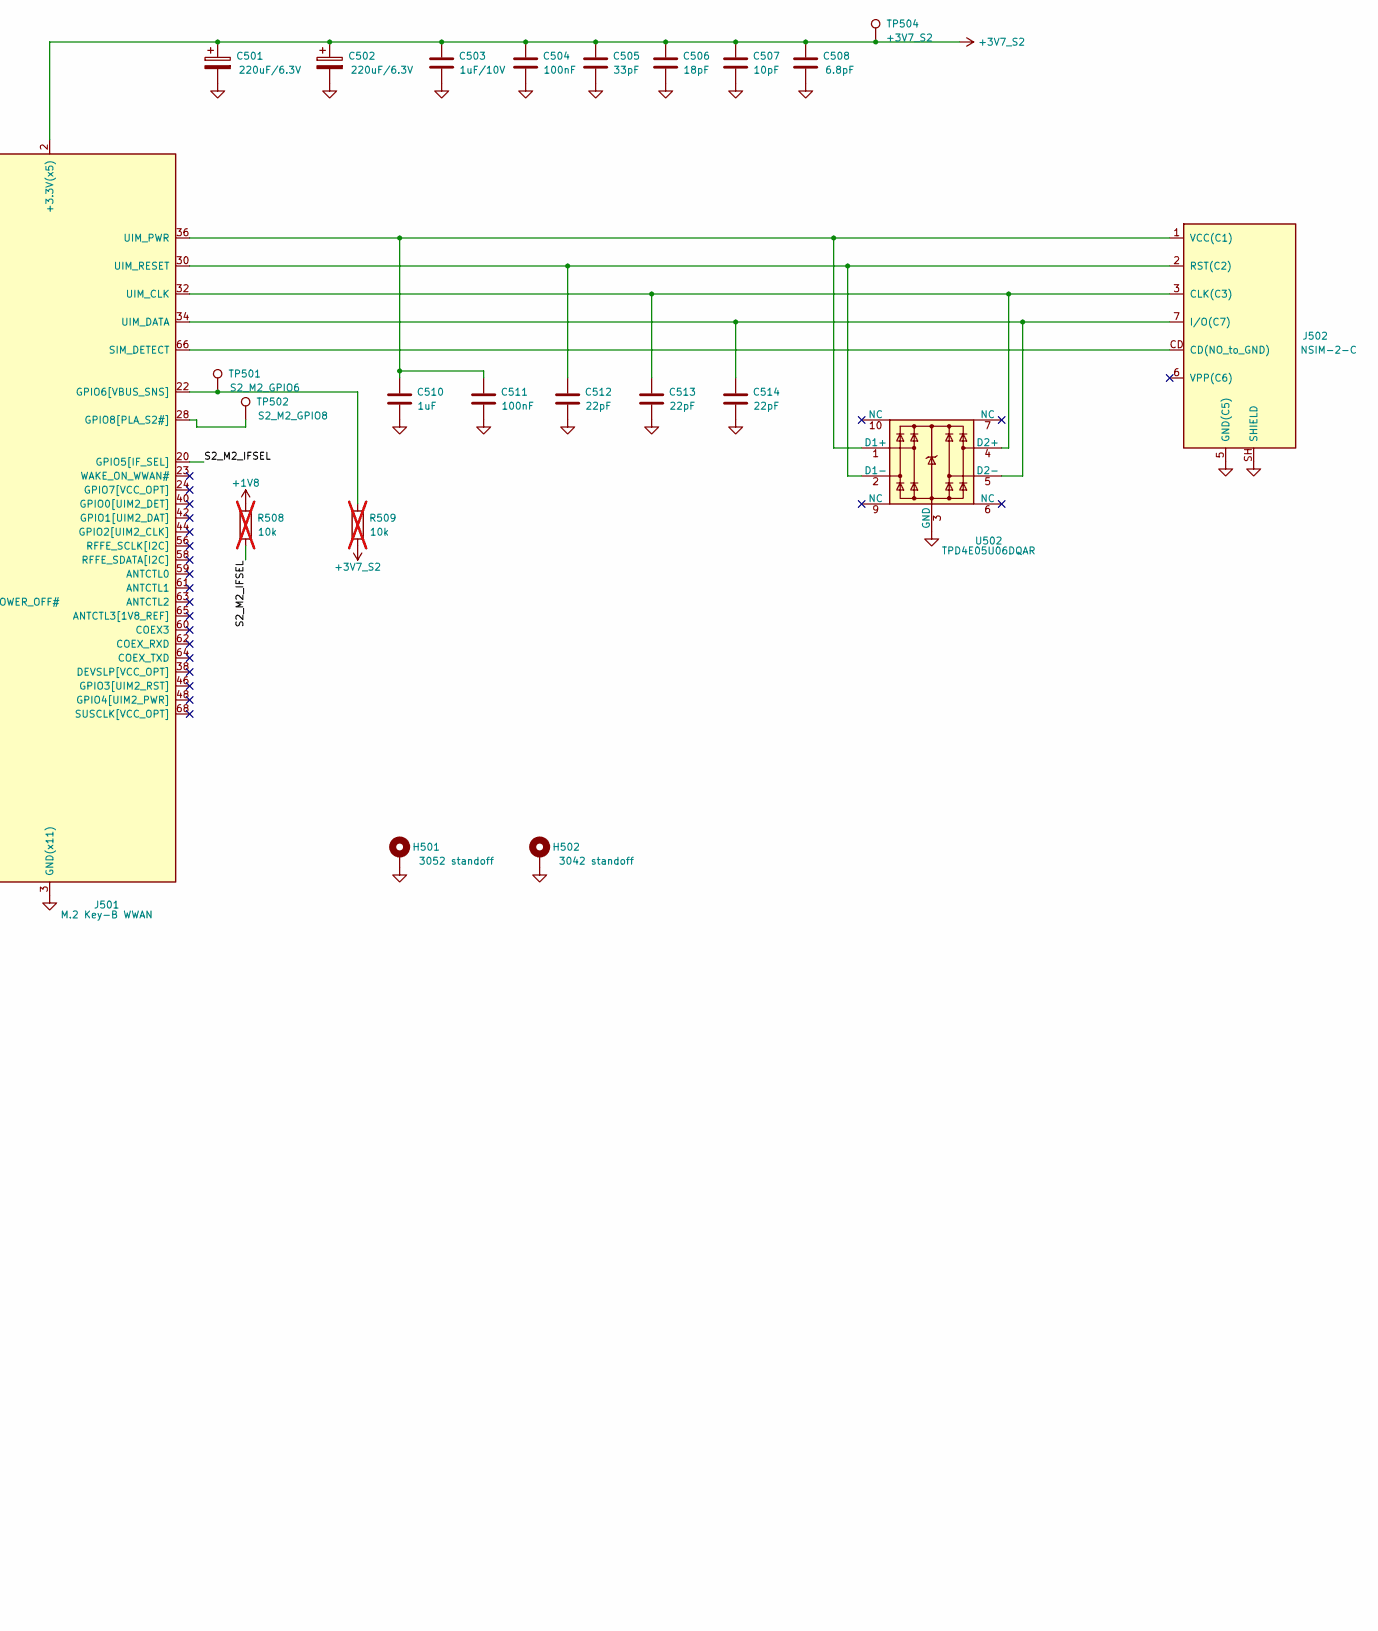
[picture p27: schematic slot2.kicad_sch, part in row 1, column 2]

Parts:
C501, C502: 220uF/6.3V; CP_EIA-7343-31_Kemet-D; MPN KEMET T520D227M006ATE015 (low ESR polym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
C503: 1uF/10V; C_0402_1005Metric; MPN Murata GRM/GCM, TDK C/CGA or KEMET (X7R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
C504, C509, C511: 100nF; C_0402_1005Metric; MPN Murata GRM/GCM, TDK C/CGA or KEMET (X7R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
C505: 33pF; C_0402_1005Metric; MPN Murata GRM/GCM, TDK C/CGA or KEMET (X7R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
C506: 18pF; C_0402_1005Metric; MPN Murata GRM/GCM, TDK C/CGA or KEMET (X7R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
C507: 10pF; C_0402_1005Metric; MPN Murata GRM/GCM, TDK C/CGA or KEMET (X7R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
C508: 6.8pF; C_0402_1005Metric; MPN Murata GRM/GCM, TDK C/CGA or KEMET (X7R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
C510: 1uF; C_0402_1005Metric; MPN Murata GRM/GCM, TDK C/CGA or KEMET (X7R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
C512, C513, C514: 22pF; C_0402_1005Metric; MPN Murata GRM/GCM, TDK C/CGA or KEMET (X7R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
D501: green; LED_0603_1608Metric; MPN Lite-On LTST-C191KGKT
H501: 3052 standoff; MountingHole_2.2mm_M2_Pad_Via; MPN Wurth WA-SMSI M2 SMT spacer (height per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
H502: 3042 standoff; MountingHole_2.2mm_M2_Pad_Via; MPN Wurth WA-SMSI M2 SMT spacer VERIFY P/N 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
J501: M.2 Key-B WWAN; MPN LOTES APCI0026-P001A (TW) VERIFY stack 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
J502: NSIM-2-C; nanoSIM_Hinged_CUI_NSIM-2-C; MPN CUI Devices NSIM-2-C
JP501: PERST# hold; PinHeader_1x02_P2.54mm_Vertical; MPN Samtec TSW-102-07-G-S + SNT-100-BK-G sh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
Q501, Q502, Q503: 2N7002; SOT-23; MPN Diodes Inc. 2N7002-7-F (AEC-Q101: onsem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
R501: 47k; R_0402_1005Metric; MPN Yageo RC0402FR-0747KL (alt Panasonic ER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
R502, R503: 100k; R_0402_1005Metric; MPN Yageo RC0402FR-07100KL (alt Panasonic E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
R504, R506: 1k; R_0402_1005Metric; MPN Yageo RC0402FR-071KL (alt Panasonic ERJ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
R505, R507, R510: 10k; R_0402_1005Metric; MPN Yageo RC0402FR-0710KL (alt Panasonic ER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
R508, R509: 10k; R_0402_1005Metric; MPN Yageo RC0402FR-0710KL (alt Panasonic ER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; not fitted
TP501: S2_M2_GPIO6; TestPoint_Pad_D1.0mm
TP502: S2_M2_GPIO8; TestPoint_Pad_D1.0mm
TP503: SLOT2_PERST_N; TestPoint_Pad_D1.0mm
TP504: +3V7_S2; TestPoint_Pad_D1.0mm
U501: SN74LVC1G08DCKR; SOT-353_SC-70-5; MPN TI SN74LVC1G08DCKR
U502: TPD4E05U06DQAR; USON-10_2.5x1.0mm_P0.5mm; MPN TI TPD4E05U06DQAR

Connections:
+1V8: R508.1
+3V3: C509.1, R504.1, R505.1, R510.1, U501.5 (VCC)
+3V7_S2: C501.1, C502.1, C503.1, C504.1, C505.1, C506.1, C507.1, C508.1, J501.2 (+3.3V(x5)), J501.4 (+3.3V(x5)), J501.70 (+3.3V(x5)), J501.72 (+3.3V(x5)), J501.74 (+3.3V(x5)), R509.1, TP504.1
GND: C501.2, C502.2, C503.2, C504.2, C505.2, C506.2, C507.2, C508.2, C509.2, C510.2, C511.2, C512.2, C513.2, C514.2, H501.1, H502.1, J501.3 (GND(x11)), J501.5 (GND(x11)), J501.11 (GND(x11)), J501.27 (GND(x11)), J501.33 (GND(x11)), J501.39 (GND(x11)), J501.45 (GND(x11)), J501.51 (GND(x11)), J501.57 (GND(x11)), J501.71 (GND(x11)), J501.73 (GND(x11)), J502.5 (GND(C5)), J502.SH (SHIELD), JP501.2 (B), Q501.2 (S), Q502.2 (S), Q503.2 (S), R501.2, R502.2, R503.2, R507.2, U501.3 (GND), U502.3 (GND), U502.8 (GND)
unnamed: C510.1, C511.1, J501.36 (UIM_PWR), J502.1 (VCC(C1)), U502.1 (D1+)
unnamed: C512.1, J501.30 (UIM_RESET), J502.2 (RST(C2)), U502.2 (D1-)
unnamed: C513.1, J501.32 (UIM_CLK), J502.3 (CLK(C3)), U502.4 (D2+)
unnamed: C514.1, J501.34 (UIM_DATA), J502.7 (I/O(C7)), U502.5 (D2-)
unnamed: D501.1 (K), J501.10 (LED1#)
unnamed: D501.2 (A), R504.2
unnamed: J501.8 (W_DISABLE1#), Q502.3 (D)
unnamed: J501.22 (GPIO6[VBUS_SNS]), R509.2, TP501.1
unnamed: J501.28 (GPIO8[PLA_S2#]), TP502.1
unnamed: J501.50 (PERST#), TP503.1, U501.4
unnamed: J501.66 (SIM_DETECT), J502.CD (CD(NO_to_GND))
unnamed: J501.67 (RESET#), Q501.3 (D)
unnamed: JP501.1 (A), R506.2, U501.2
PCIE_PERST_N: U501.1
S2_M2_IFSEL: J501.20 (GPIO5[IF_SEL]), Q503.3 (D), R508.2
SLOT2_CLKREQ_N: J501.52 (CLKREQ#)
SLOT2_FCPO_N: J501.6 (FULL_CARD_POWER_OFF#), R501.1
SLOT2_PCIE_EN: R506.1, R507.1
SLOT2_PCIE_RX_N: J501.47 (PERn0)
SLOT2_PCIE_RX_P: J501.49 (PERp0)
SLOT2_PCIE_SEL: Q503.1 (G), R510.2
SLOT2_PCIE_TX_N: J501.41 (PETn0)
SLOT2_PCIE_TX_P: J501.43 (PETp0)
SLOT2_REFCLK_N: J501.53 (REFCLKN)
SLOT2_REFCLK_P: J501.55 (REFCLKP)
SLOT2_RESET: Q501.1 (G), R502.1
SLOT2_USB2_DM: J501.9 (USB_D-)
SLOT2_USB2_DP: J501.7 (USB_D+)
SLOT2_USB3_RX_N: J501.35 (USB3_RX-)
SLOT2_USB3_RX_P: J501.37 (USB3_RX+)
SLOT2_USB3_TX_N: J501.29 (USB3_TX-)
SLOT2_USB3_TX_P: J501.31 (USB3_TX+)
SLOT2_WAKE_N: J501.54 (PEWAKE#), R505.2
SLOT2_WDIS: Q502.1 (G), R503.1

Notes on the sheet:
SLOT 2: generic M.2 3052/3042 Key-B WWAN socket. Pins checked vs Sierra EM92XX PTS Rev 5 (Jan 2025) + Telit FN990 HDG Rev 3. PCIe Gen3 x1 to switch port 4 (lane2); USB2 + USB3 to USB5744 port 2. Module TX AC caps on module. FULL_CARD_POWER_OFF# (pin 6): TCA6416A 3.3V push-pull + 47k PD (EM92 VIH 1.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
