jmendoza-10/connectivity-module-public/hardware/kicad/slot3.kicad_sch

## KiCad design hardware/kicad/slot3.kicad_sch (2026-10-14)

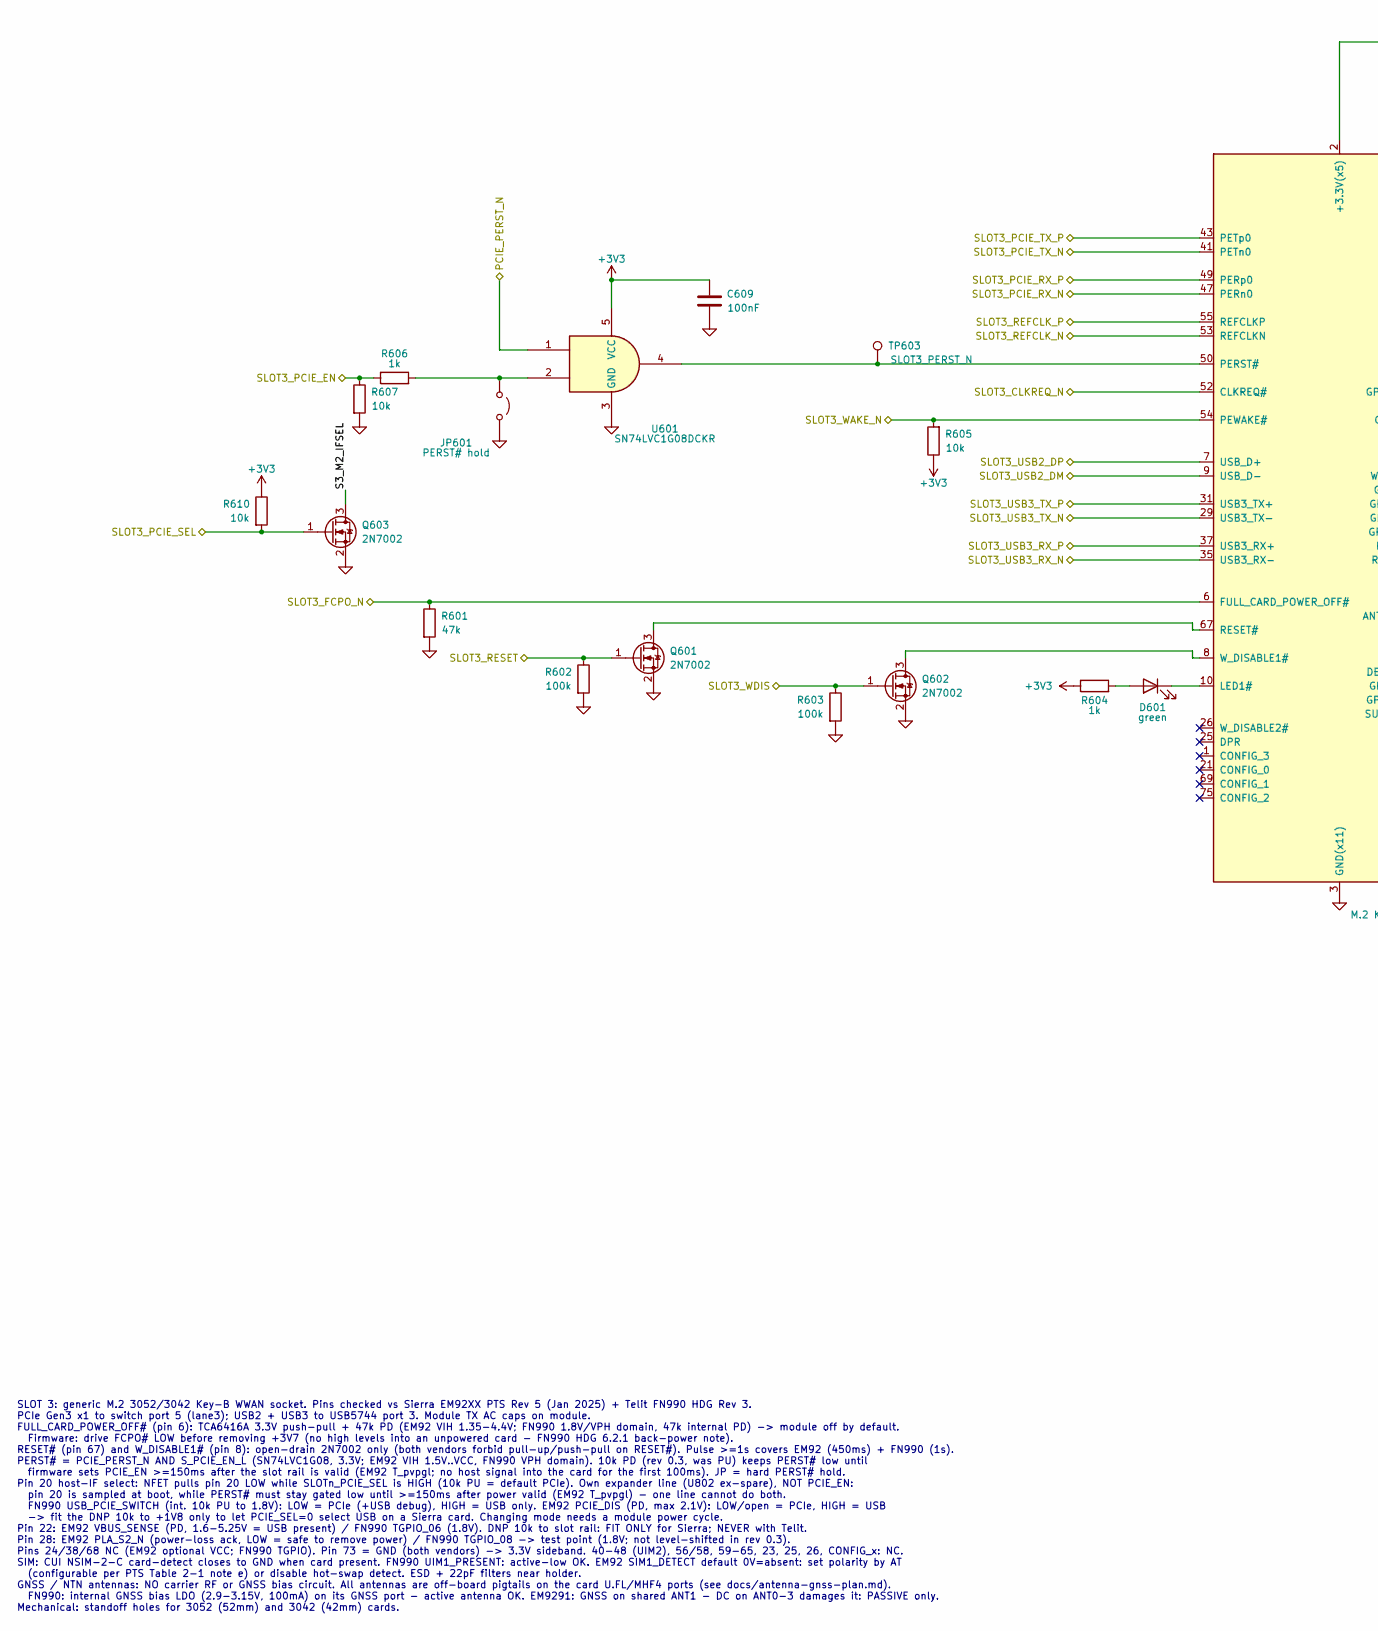
[picture p28: schematic slot3.kicad_sch, part in row 1, column 1]

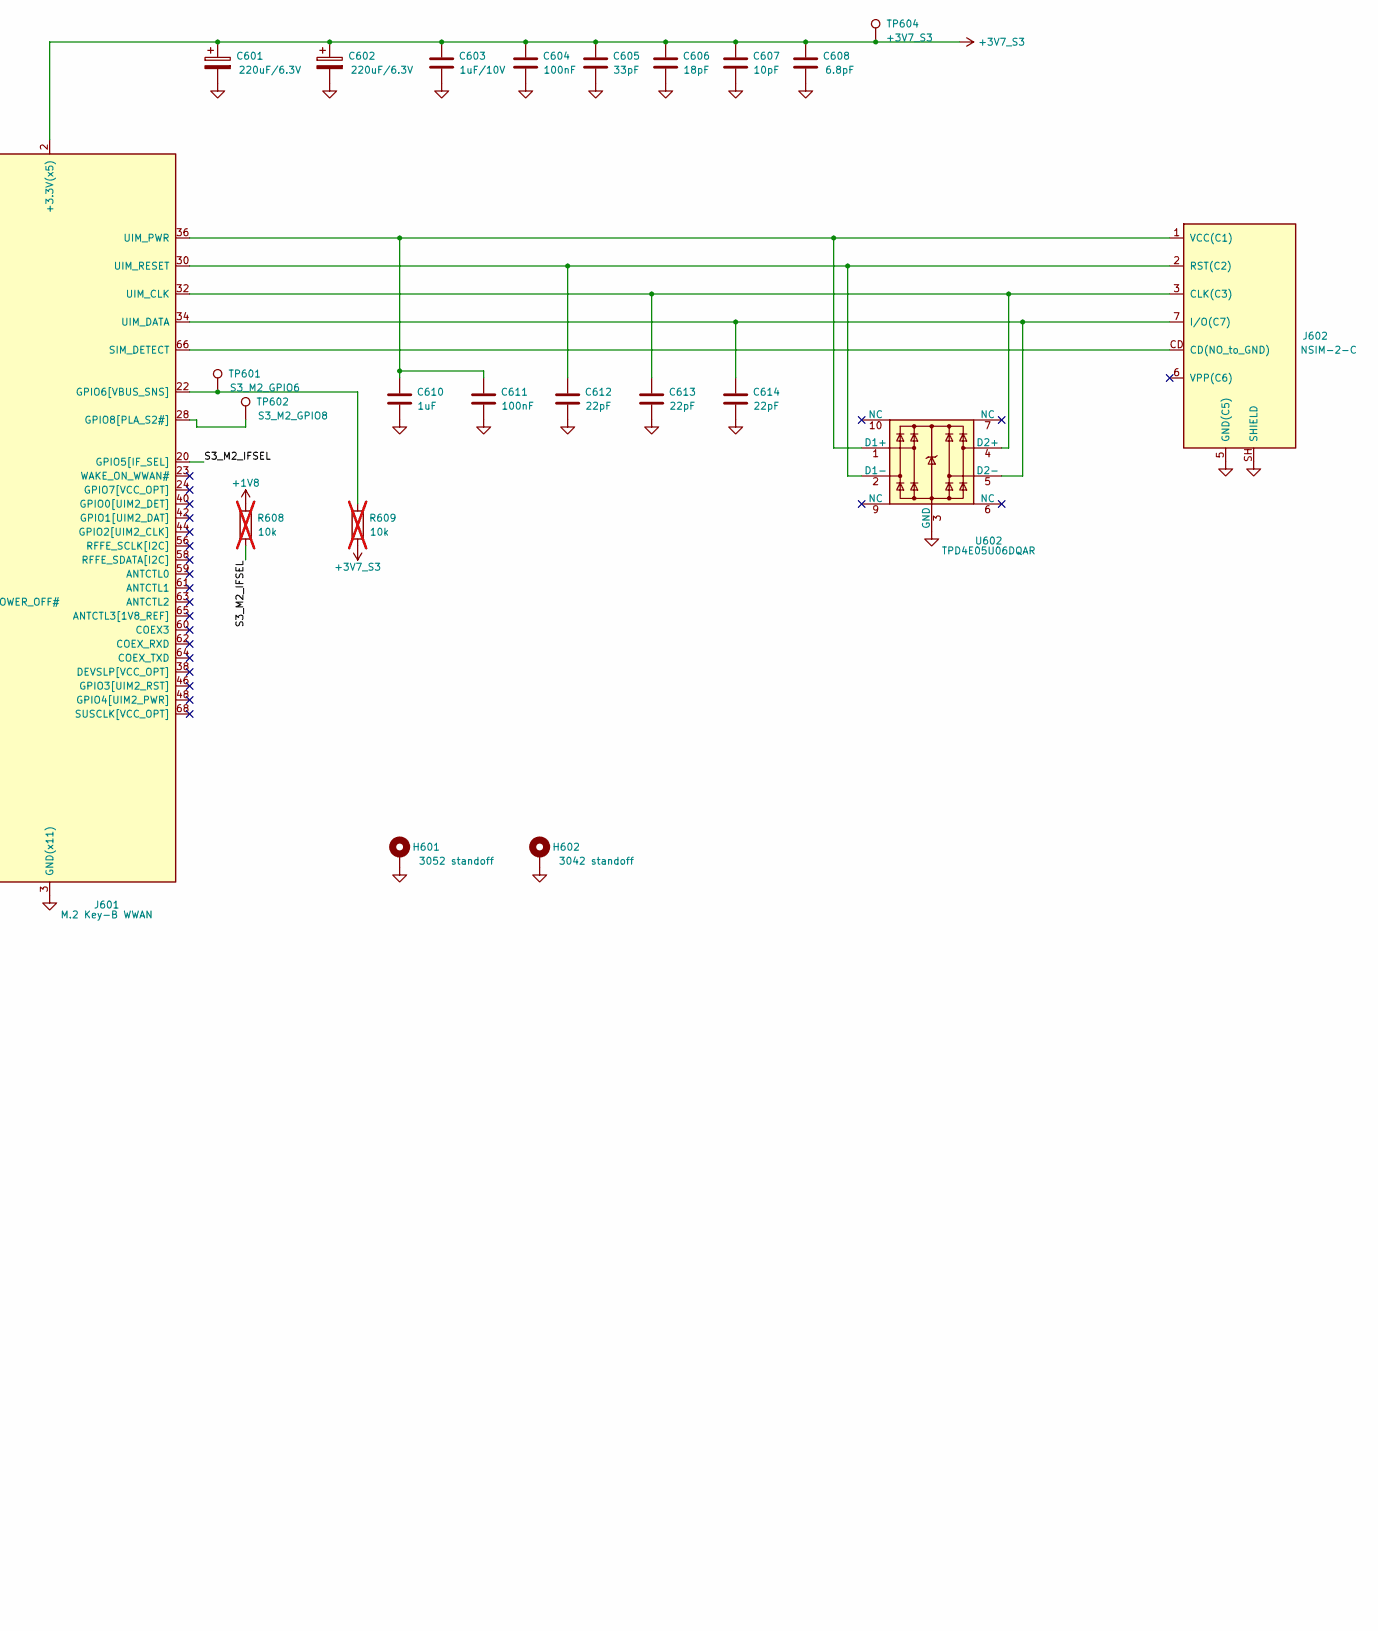
[picture p29: schematic slot3.kicad_sch, part in row 1, column 2]

Parts:
C601, C602: 220uF/6.3V; CP_EIA-7343-31_Kemet-D; MPN KEMET T520D227M006ATE015 (low ESR polym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
C603: 1uF/10V; C_0402_1005Metric; MPN Murata GRM/GCM, TDK C/CGA or KEMET (X7R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
C604, C609, C611: 100nF; C_0402_1005Metric; MPN Murata GRM/GCM, TDK C/CGA or KEMET (X7R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
C605: 33pF; C_0402_1005Metric; MPN Murata GRM/GCM, TDK C/CGA or KEMET (X7R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
C606: 18pF; C_0402_1005Metric; MPN Murata GRM/GCM, TDK C/CGA or KEMET (X7R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
C607: 10pF; C_0402_1005Metric; MPN Murata GRM/GCM, TDK C/CGA or KEMET (X7R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
C608: 6.8pF; C_0402_1005Metric; MPN Murata GRM/GCM, TDK C/CGA or KEMET (X7R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
C610: 1uF; C_0402_1005Metric; MPN Murata GRM/GCM, TDK C/CGA or KEMET (X7R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
C612, C613, C614: 22pF; C_0402_1005Metric; MPN Murata GRM/GCM, TDK C/CGA or KEMET (X7R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
D601: green; LED_0603_1608Metric; MPN Lite-On LTST-C191KGKT
H601: 3052 standoff; MountingHole_2.2mm_M2_Pad_Via; MPN Wurth WA-SMSI M2 SMT spacer (height per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
H602: 3042 standoff; MountingHole_2.2mm_M2_Pad_Via; MPN Wurth WA-SMSI M2 SMT spacer VERIFY P/N 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
J601: M.2 Key-B WWAN; MPN LOTES APCI0026-P001A (TW) VERIFY stack 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
J602: NSIM-2-C; nanoSIM_Hinged_CUI_NSIM-2-C; MPN CUI Devices NSIM-2-C
JP601: PERST# hold; PinHeader_1x02_P2.54mm_Vertical; MPN Samtec TSW-102-07-G-S + SNT-100-BK-G sh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
Q601, Q602, Q603: 2N7002; SOT-23; MPN Diodes Inc. 2N7002-7-F (AEC-Q101: onsem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
R601: 47k; R_0402_1005Metric; MPN Yageo RC0402FR-0747KL (alt Panasonic ER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
R602, R603: 100k; R_0402_1005Metric; MPN Yageo RC0402FR-07100KL (alt Panasonic E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
R604, R606: 1k; R_0402_1005Metric; MPN Yageo RC0402FR-071KL (alt Panasonic ERJ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
R605, R607, R610: 10k; R_0402_1005Metric; MPN Yageo RC0402FR-0710KL (alt Panasonic ER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
R608, R609: 10k; R_0402_1005Metric; MPN Yageo RC0402FR-0710KL (alt Panasonic ER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; not fitted
TP601: S3_M2_GPIO6; TestPoint_Pad_D1.0mm
TP602: S3_M2_GPIO8; TestPoint_Pad_D1.0mm
TP603: SLOT3_PERST_N; TestPoint_Pad_D1.0mm
TP604: +3V7_S3; TestPoint_Pad_D1.0mm
U601: SN74LVC1G08DCKR; SOT-353_SC-70-5; MPN TI SN74LVC1G08DCKR
U602: TPD4E05U06DQAR; USON-10_2.5x1.0mm_P0.5mm; MPN TI TPD4E05U06DQAR

Connections:
+1V8: R608.1
+3V3: C609.1, R604.1, R605.1, R610.1, U601.5 (VCC)
+3V7_S3: C601.1, C602.1, C603.1, C604.1, C605.1, C606.1, C607.1, C608.1, J601.2 (+3.3V(x5)), J601.4 (+3.3V(x5)), J601.70 (+3.3V(x5)), J601.72 (+3.3V(x5)), J601.74 (+3.3V(x5)), R609.1, TP604.1
GND: C601.2, C602.2, C603.2, C604.2, C605.2, C606.2, C607.2, C608.2, C609.2, C610.2, C611.2, C612.2, C613.2, C614.2, H601.1, H602.1, J601.3 (GND(x11)), J601.5 (GND(x11)), J601.11 (GND(x11)), J601.27 (GND(x11)), J601.33 (GND(x11)), J601.39 (GND(x11)), J601.45 (GND(x11)), J601.51 (GND(x11)), J601.57 (GND(x11)), J601.71 (GND(x11)), J601.73 (GND(x11)), J602.5 (GND(C5)), J602.SH (SHIELD), JP601.2 (B), Q601.2 (S), Q602.2 (S), Q603.2 (S), R601.2, R602.2, R603.2, R607.2, U601.3 (GND), U602.3 (GND), U602.8 (GND)
unnamed: C610.1, C611.1, J601.36 (UIM_PWR), J602.1 (VCC(C1)), U602.1 (D1+)
unnamed: C612.1, J601.30 (UIM_RESET), J602.2 (RST(C2)), U602.2 (D1-)
unnamed: C613.1, J601.32 (UIM_CLK), J602.3 (CLK(C3)), U602.4 (D2+)
unnamed: C614.1, J601.34 (UIM_DATA), J602.7 (I/O(C7)), U602.5 (D2-)
unnamed: D601.1 (K), J601.10 (LED1#)
unnamed: D601.2 (A), R604.2
unnamed: J601.8 (W_DISABLE1#), Q602.3 (D)
unnamed: J601.22 (GPIO6[VBUS_SNS]), R609.2, TP601.1
unnamed: J601.28 (GPIO8[PLA_S2#]), TP602.1
unnamed: J601.50 (PERST#), TP603.1, U601.4
unnamed: J601.66 (SIM_DETECT), J602.CD (CD(NO_to_GND))
unnamed: J601.67 (RESET#), Q601.3 (D)
unnamed: JP601.1 (A), R606.2, U601.2
PCIE_PERST_N: U601.1
S3_M2_IFSEL: J601.20 (GPIO5[IF_SEL]), Q603.3 (D), R608.2
SLOT3_CLKREQ_N: J601.52 (CLKREQ#)
SLOT3_FCPO_N: J601.6 (FULL_CARD_POWER_OFF#), R601.1
SLOT3_PCIE_EN: R606.1, R607.1
SLOT3_PCIE_RX_N: J601.47 (PERn0)
SLOT3_PCIE_RX_P: J601.49 (PERp0)
SLOT3_PCIE_SEL: Q603.1 (G), R610.2
SLOT3_PCIE_TX_N: J601.41 (PETn0)
SLOT3_PCIE_TX_P: J601.43 (PETp0)
SLOT3_REFCLK_N: J601.53 (REFCLKN)
SLOT3_REFCLK_P: J601.55 (REFCLKP)
SLOT3_RESET: Q601.1 (G), R602.1
SLOT3_USB2_DM: J601.9 (USB_D-)
SLOT3_USB2_DP: J601.7 (USB_D+)
SLOT3_USB3_RX_N: J601.35 (USB3_RX-)
SLOT3_USB3_RX_P: J601.37 (USB3_RX+)
SLOT3_USB3_TX_N: J601.29 (USB3_TX-)
SLOT3_USB3_TX_P: J601.31 (USB3_TX+)
SLOT3_WAKE_N: J601.54 (PEWAKE#), R605.2
SLOT3_WDIS: Q602.1 (G), R603.1

Notes on the sheet:
SLOT 3: generic M.2 3052/3042 Key-B WWAN socket. Pins checked vs Sierra EM92XX PTS Rev 5 (Jan 2025) + Telit FN990 HDG Rev 3. PCIe Gen3 x1 to switch port 5 (lane3); USB2 + USB3 to USB5744 port 3. Module TX AC caps on module. FULL_CARD_POWER_OFF# (pin 6): TCA6416A 3.3V push-pull + 47k PD (EM92 VIH 1.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
