jmendoza-10/connectivity-module-public/hardware/kicad/usb_hub.kicad_sch

## KiCad design hardware/kicad/usb_hub.kicad_sch (2026-10-14)

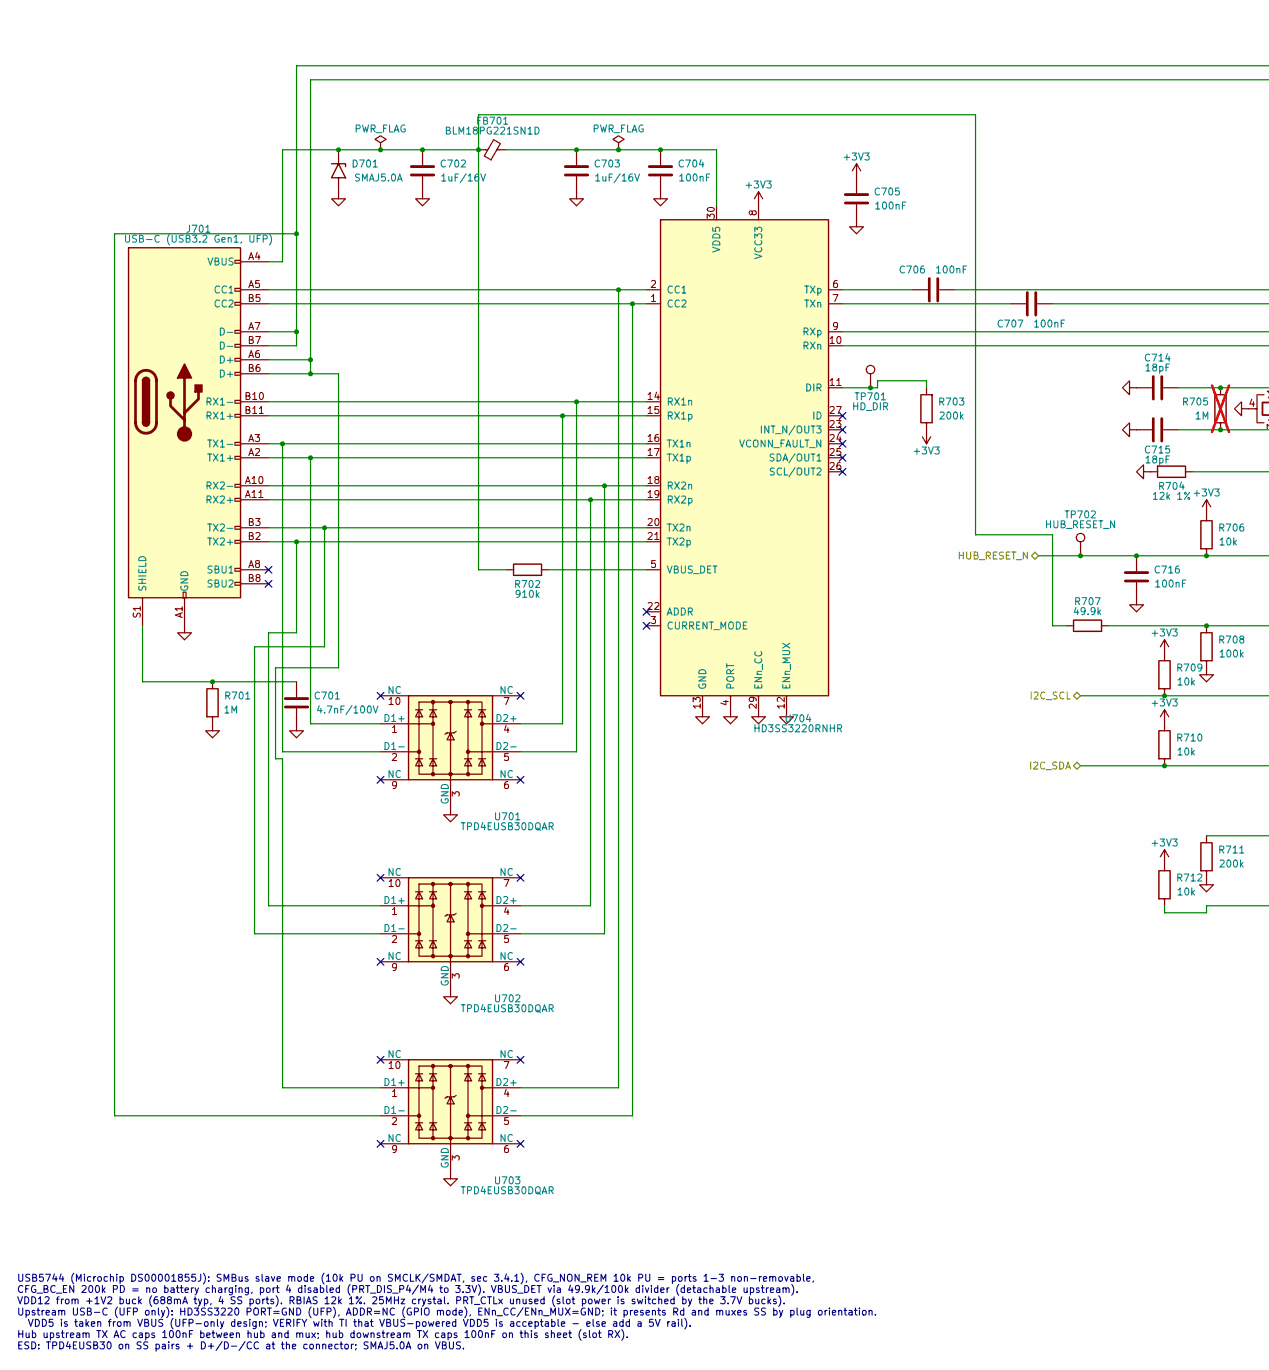
[picture p30: schematic usb_hub.kicad_sch, part in row 1, column 1]

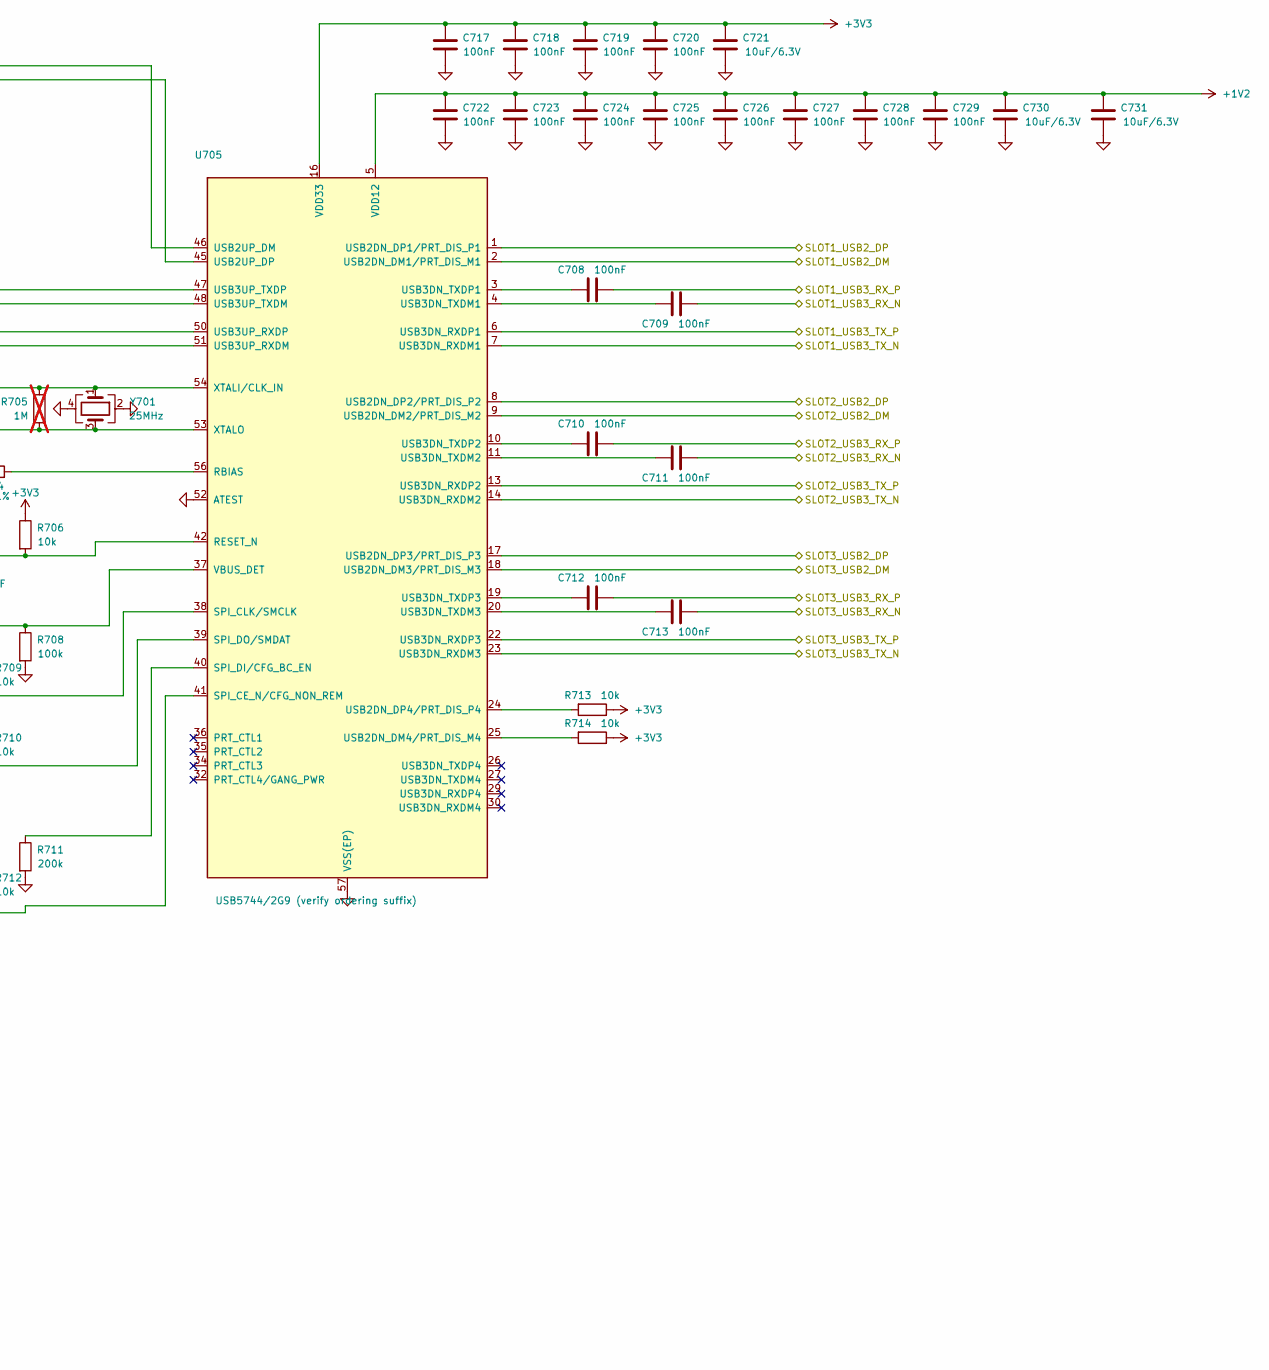
[picture p31: schematic usb_hub.kicad_sch, part in row 1, column 2]

Parts:
C701: 4.7nF/100V; C_0603_1608Metric; MPN Murata GRM/GCM, TDK C/CGA or KEMET (X7R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
C702, C703: 1uF/16V; C_0402_1005Metric; MPN Murata GRM/GCM, TDK C/CGA or KEMET (X7R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
C704, C705, C716, C717, C718, C719, C720, C722, C723, C724, C725, C726, C727, C728, C729: 100nF; C_0402_1005Metric; MPN Murata GRM/GCM, TDK C/CGA or KEMET (X7R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
C706, C707, C708, C709, C710, C711, C712, C713: 100nF; C_0201_0603Metric; MPN Murata GRM/GCM, TDK C/CGA or KEMET (X7R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
C714, C715: 18pF; C_0402_1005Metric; MPN Murata GRM/GCM, TDK C/CGA or KEMET (X7R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
C721, C730, C731: 10uF/6.3V; C_0402_1005Metric; MPN Murata GRM/GCM, TDK C/CGA or KEMET (X7R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
D701: SMAJ5.0A; D_SMA; MPN Littelfuse SMAJ5.0A (unidirectional, pi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
FB701: BLM18PG221SN1D; L_0603_1608Metric; MPN Murata BLM18PG221SN1D
J701: USB-C (USB3.2 Gen1, UFP); USB_C_Receptacle_Amphenol_12401610E4-2A; MPN Amphenol 12401610E4#2A
R701: 1M; R_0603_1608Metric; MPN Yageo RC0603FR-071ML (alt Panasonic ERJ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
R702: 910k; R_0402_1005Metric; MPN Yageo RC0402FR-07910KL (alt Panasonic E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
R703, R711: 200k; R_0402_1005Metric; MPN Yageo RC0402FR-07200KL (alt Panasonic E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
R704: 12k 1%; R_0402_1005Metric; MPN Yageo RC0402FR-0712KL (alt Panasonic ER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
R705: 1M; R_0402_1005Metric; MPN Yageo RC0402FR-071ML (alt Panasonic ERJ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; not fitted
R706, R709, R710, R712, R713, R714: 10k; R_0402_1005Metric; MPN Yageo RC0402FR-0710KL (alt Panasonic ER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
R707: 49.9k; R_0402_1005Metric; MPN Yageo RC0402FR-0749K9L (alt Panasonic E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
R708: 100k; R_0402_1005Metric; MPN Yageo RC0402FR-07100KL (alt Panasonic E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
TP701: HD_DIR; TestPoint_Pad_D1.0mm
TP702: HUB_RESET_N; TestPoint_Pad_D1.0mm
U701, U702, U703: TPD4EUSB30DQAR; USON-10_2.5x1.0mm_P0.5mm; MPN TPD4EUSB30DQAR
U704: HD3SS3220RNHR; Texas_RNH0030A_WQFN-30-1EP_2.5x4.5mm_P0.4mm_EP1.2x3.2mm; MPN HD3SS3220RNHR
U705: USB5744/2G9 (verify ordering suffix); QFN-56-1EP_7x7mm_P0.4mm_EP5.6x5.6mm_ThermalVias; MPN USB5744-I/2G (industrial) VERIFY suffix
Y701: 25MHz; Crystal_SMD_3225-4Pin_3.2x2.5mm; MPN Abracon ABM8-25.000MHZ-B2-T (VERIFY CL 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

Connections:
+1V2: C722.1, C723.1, C724.1, C725.1, C726.1, C727.1, C728.1, C729.1, C730.1, C731.1, U705.5 (VDD12), U705.12 (VDD12), U705.15 (VDD12), U705.21 (VDD12), U705.28 (VDD12), U705.33 (VDD12), U705.43 (VDD12), U705.49 (VDD12)
+3V3: C705.1, C717.1, C718.1, C719.1, C720.1, C721.1, R703.1, R706.1, R709.1, R710.1, R712.1, R713.1, R714.1, U704.8 (VCC33), U705.16 (VDD33), U705.31 (VDD33), U705.44 (VDD33), U705.55 (VDD33)
GND: C701.2, C702.2, C703.2, C704.2, C705.2, C714.2, C715.2, C716.2, C717.2, C718.2, C719.2, C720.2, C721.2, C722.2, C723.2, C724.2, C725.2, C726.2, C727.2, C728.2, C729.2, C730.2, C731.2, D701.2 (A2), J701.A1 (GND), J701.A12 (GND), J701.B1 (GND), J701.B12 (GND), R701.2, R704.2, R708.2, R711.2, U701.3 (GND), U701.8 (GND), U702.3 (GND), U702.8 (GND), U703.3 (GND), U703.8 (GND), U704.4 (PORT), U704.12 (ENn_MUX), U704.13 (GND), U704.28 (GND), U704.29 (ENn_CC), U704.31 (GND), U705.52 (ATEST), U705.57 (VSS(EP)), Y701.2, Y701.4
HUB_RESET_N: C716.1, R706.2, TP702.1, U705.42 (RESET_N)
I2C_SCL: R709.2, U705.38 (SPI_CLK/SMCLK)
I2C_SDA: R710.2, U705.39 (SPI_DO/SMDAT)
unnamed: C701.1, J701.S1 (SHIELD), R701.1
unnamed: C702.1, D701.1 (A1), FB701.1, J701.A4 (VBUS), J701.A9 (VBUS), J701.B4 (VBUS), J701.B9 (VBUS), R702.1, R707.1
unnamed: C703.1, C704.1, FB701.2, U704.30 (VDD5)
unnamed: C706.1, U705.47 (USB3UP_TXDP)
unnamed: C706.2, U704.6 (TXp)
unnamed: C707.1, U705.48 (USB3UP_TXDM)
unnamed: C707.2, U704.7 (TXn)
unnamed: C708.1, U705.3 (USB3DN_TXDP1)
unnamed: C709.1, U705.4 (USB3DN_TXDM1)
unnamed: C710.1, U705.10 (USB3DN_TXDP2)
unnamed: C711.1, U705.11 (USB3DN_TXDM2)
unnamed: C712.1, U705.19 (USB3DN_TXDP3)
unnamed: C713.1, U705.20 (USB3DN_TXDM3)
unnamed: C714.1, R705.1, U705.54 (XTALI/CLK_IN), Y701.1
unnamed: C715.1, R705.2, U705.53 (XTALO), Y701.3
unnamed: J701.A2 (TX1+), U701.1 (D1+), U704.17 (TX1p)
unnamed: J701.A3 (TX1-), U701.2 (D1-), U704.16 (TX1n)
unnamed: J701.A5 (CC1), U703.4 (D2+), U704.2 (CC1)
unnamed: J701.A6 (D+), J701.B6 (D+), U703.1 (D1+), U705.45 (USB2UP_DP)
unnamed: J701.A7 (D-), J701.B7 (D-), U703.2 (D1-), U705.46 (USB2UP_DM)
unnamed: J701.A10 (RX2-), U702.5 (D2-), U704.18 (RX2n)
unnamed: J701.A11 (RX2+), U702.4 (D2+), U704.19 (RX2p)
unnamed: J701.B2 (TX2+), U702.1 (D1+), U704.21 (TX2p)
unnamed: J701.B3 (TX2-), U702.2 (D1-), U704.20 (TX2n)
unnamed: J701.B5 (CC2), U703.5 (D2-), U704.1 (CC2)
unnamed: J701.B10 (RX1-), U701.5 (D2-), U704.14 (RX1n)
unnamed: J701.B11 (RX1+), U701.4 (D2+), U704.15 (RX1p)
unnamed: R702.2, U704.5 (VBUS_DET)
unnamed: R703.2, TP701.1, U704.11 (DIR)
unnamed: R704.1, U705.56 (RBIAS)
unnamed: R707.2, R708.1, U705.37 (VBUS_DET)
unnamed: R711.1, U705.40 (SPI_DI/CFG_BC_EN)
unnamed: R712.2, U705.41 (SPI_CE_N/CFG_NON_REM)
unnamed: R713.2, U705.24 (USB2DN_DP4/PRT_DIS_P4)
unnamed: R714.2, U705.25 (USB2DN_DM4/PRT_DIS_M4)
unnamed: U704.9 (RXp), U705.50 (USB3UP_RXDP)
unnamed: U704.10 (RXn), U705.51 (USB3UP_RXDM)
SLOT1_USB2_DM: U705.2 (USB2DN_DM1/PRT_DIS_M1)
SLOT1_USB2_DP: U705.1 (USB2DN_DP1/PRT_DIS_P1)
SLOT1_USB3_RX_N: C709.2
SLOT1_USB3_RX_P: C708.2
SLOT1_USB3_TX_N: U705.7 (USB3DN_RXDM1)
SLOT1_USB3_TX_P: U705.6 (USB3DN_RXDP1)
SLOT2_USB2_DM: U705.9 (USB2DN_DM2/PRT_DIS_M2)
SLOT2_USB2_DP: U705.8 (USB2DN_DP2/PRT_DIS_P2)
SLOT2_USB3_RX_N: C711.2
SLOT2_USB3_RX_P: C710.2
SLOT2_USB3_TX_N: U705.14 (USB3DN_RXDM2)
SLOT2_USB3_TX_P: U705.13 (USB3DN_RXDP2)
SLOT3_USB2_DM: U705.18 (USB2DN_DM3/PRT_DIS_M3)
SLOT3_USB2_DP: U705.17 (USB2DN_DP3/PRT_DIS_P3)
SLOT3_USB3_RX_N: C713.2
SLOT3_USB3_RX_P: C712.2
SLOT3_USB3_TX_N: U705.23 (USB3DN_RXDM3)
SLOT3_USB3_TX_P: U705.22 (USB3DN_RXDP3)

Notes on the sheet:
USB5744 (Microchip DS00001855J): SMBus slave mode (10k PU on SMCLK/SMDAT, sec 3.4.1), CFG_NON_REM 10k PU = ports 1-3 non-removable, CFG_BC_EN 200k PD = no battery charging, port 4 disabled (PRT_DIS_P4/M4 to 3.3V). VBUS_DET via 49.9k/100k divider (detachable upstream). VDD12 from +1V2 buck (688mA ty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
