jmendoza-10/connectivity-module-public/hardware/kicad/wwan_power.kicad_sch

## KiCad design hardware/kicad/wwan_power.kicad_sch (2026-10-14)

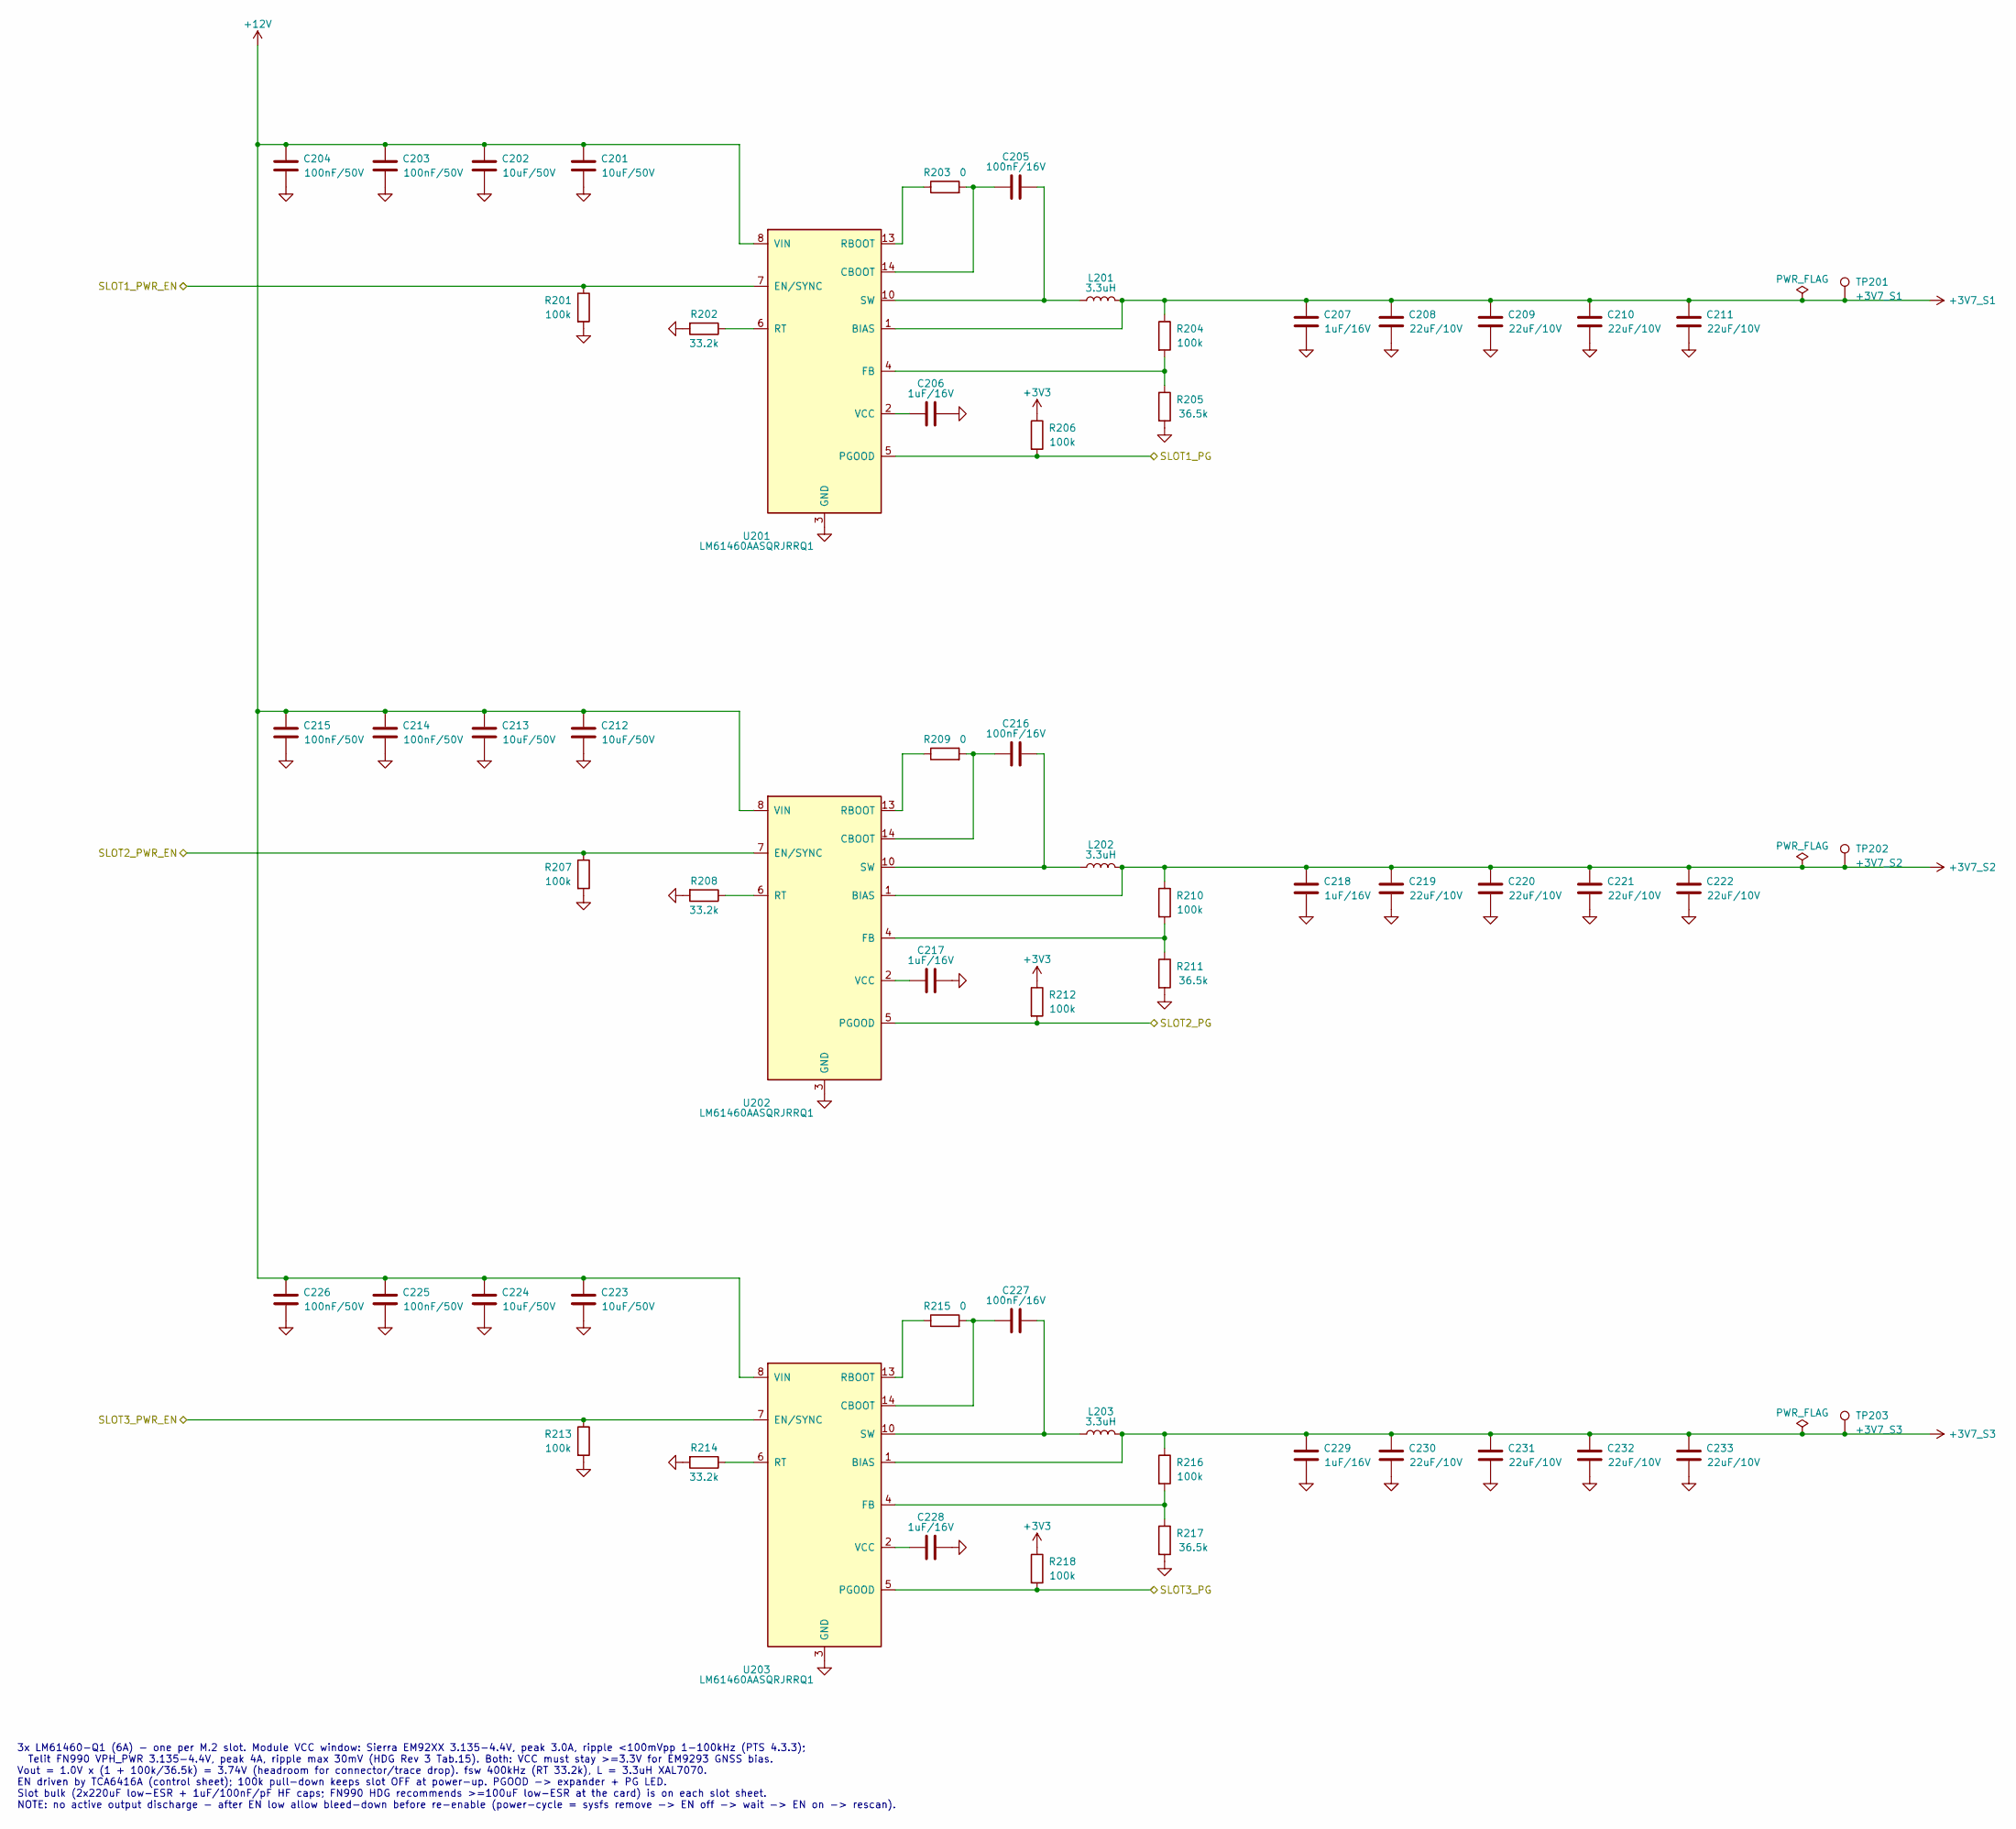
[picture p32: schematic wwan_power.kicad_sch]

Parts:
C201, C202, C212, C213, C223, C224: 10uF/50V; C_1210_3225Metric; MPN Murata GRM/GCM, TDK C/CGA or KEMET (X7R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
C203, C204, C214, C215, C225, C226: 100nF/50V; C_0402_1005Metric; MPN Murata GRM/GCM, TDK C/CGA or KEMET (X7R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
C205, C216, C227: 100nF/16V; C_0402_1005Metric; MPN Murata GRM/GCM, TDK C/CGA or KEMET (X7R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
C206, C207, C217, C218, C228, C229: 1uF/16V; C_0402_1005Metric; MPN Murata GRM/GCM, TDK C/CGA or KEMET (X7R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
C208, C209, C210, C211, C219, C220, C221, C222, C230, C231, C232, C233: 22uF/10V; C_1210_3225Metric; MPN Murata GRM/GCM, TDK C/CGA or KEMET (X7R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
L201, L202, L203: 3.3uH; L_Coilcraft_XAL7070-XXX; MPN XAL7070-332MEB
R201, R204, R206, R207, R210, R212, R213, R216, R218: 100k; R_0402_1005Metric; MPN Yageo RC0402FR-07100KL (alt Panasonic E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
R202, R208, R214: 33.2k; R_0402_1005Metric; MPN Yageo RC0402FR-0733K2L (alt Panasonic E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
R203, R209, R215: 0; R_0402_1005Metric; MPN Yageo RC0402JR-070RL (0R jumper)
R205, R211, R217: 36.5k; R_0402_1005Metric; MPN Yageo RC0402FR-0736K5L (alt Panasonic E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
TP201: +3V7_S1; TestPoint_Pad_D1.0mm
TP202: +3V7_S2; TestPoint_Pad_D1.0mm
TP203: +3V7_S3; TestPoint_Pad_D1.0mm
U201, U202, U203: LM61460AASQRJRRQ1; MPN LM61460AASQRJRRQ1

Connections:
+3V3: R206.1, R212.1, R218.1
+3V7_S1: C207.1, C208.1, C209.1, C210.1, C211.1, L201.2, R204.1, TP201.1, U201.1 (BIAS)
+3V7_S2: C218.1, C219.1, C220.1, C221.1, C222.1, L202.2, R210.1, TP202.1, U202.1 (BIAS)
+3V7_S3: C229.1, C230.1, C231.1, C232.1, C233.1, L203.2, R216.1, TP203.1, U203.1 (BIAS)
+12V: C201.1, C202.1, C203.1, C204.1, C212.1, C213.1, C214.1, C215.1, C223.1, C224.1, C225.1, C226.1, U201.8 (VIN), U201.12 (VIN), U202.8 (VIN), U202.12 (VIN), U203.8 (VIN), U203.12 (VIN)
GND: C201.2, C202.2, C203.2, C204.2, C206.2, C207.2, C208.2, C209.2, C210.2, C211.2, C212.2, C213.2, C214.2, C215.2, C217.2, C218.2, C219.2, C220.2, C221.2, C222.2, C223.2, C224.2, C225.2, C226.2, C228.2, C229.2, C230.2, C231.2, C232.2, C233.2, R201.2, R202.2, R205.2, R207.2, R208.2, R211.2, R213.2, R214.2, R217.2, U201.3 (GND), U201.9 (GND), U201.11 (GND), U202.3 (GND), U202.9 (GND), U202.11 (GND), U203.3 (GND), U203.9 (GND), U203.11 (GND)
unnamed: C205.1, R203.2, U201.14 (CBOOT)
unnamed: C205.2, L201.1, U201.10 (SW)
unnamed: C206.1, U201.2 (VCC)
unnamed: C216.1, R209.2, U202.14 (CBOOT)
unnamed: C216.2, L202.1, U202.10 (SW)
unnamed: C217.1, U202.2 (VCC)
unnamed: C227.1, R215.2, U203.14 (CBOOT)
unnamed: C227.2, L203.1, U203.10 (SW)
unnamed: C228.1, U203.2 (VCC)
unnamed: R202.1, U201.6 (RT)
unnamed: R203.1, U201.13 (RBOOT)
unnamed: R204.2, R205.1, U201.4 (FB)
unnamed: R208.1, U202.6 (RT)
unnamed: R209.1, U202.13 (RBOOT)
unnamed: R210.2, R211.1, U202.4 (FB)
unnamed: R214.1, U203.6 (RT)
unnamed: R215.1, U203.13 (RBOOT)
unnamed: R216.2, R217.1, U203.4 (FB)
SLOT1_PG: R206.2, U201.5 (PGOOD)
SLOT1_PWR_EN: R201.1, U201.7 (EN/SYNC)
SLOT2_PG: R212.2, U202.5 (PGOOD)
SLOT2_PWR_EN: R207.1, U202.7 (EN/SYNC)
SLOT3_PG: R218.2, U203.5 (PGOOD)
SLOT3_PWR_EN: R213.1, U203.7 (EN/SYNC)

Notes on the sheet:
3x LM61460-Q1 (6A) - one per M.2 slot. Module VCC window: Sierra EM92XX 3.135-4.4V, peak 3.0A, ripple <100mVpp 1-100kHz (PTS 4.3.3); Telit FN990 VPH_PWR 3.135-4.4V, peak 4A, ripple max 30mV (HDG Rev 3 Tab.15). Both: VCC must stay >=3.3V for EM9293 GNSS bias. Vout = 1.0V x (1 + 100k/36.5k) = 3.74V (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
